ruledicaprio/sjednica-hybrid-solar/README.md

solar-rfp-engine

Solar/hybrid-power engineering toolkit for producing RFP and technical
proposal documents. First active project: Solarna ograda SJEDNICA_BILECA.
See CLAUDE.md for scope, tool/data sources, and workflow.
