ruledicaprio/sjednica-hybrid-solar/rural-star-sjednica/RuralStar_Sjednica_Report.pdf

# Izvještaj o simulaciji RuralStar Sjednica

### Datum generisanja: 24.04.2026 18:20

# 1. Konfiguracija Sistema

Parametar | Vrijednost
Lokacija | 42.94° N, 18.32° E
Nadmorska visina | 1076 m
Ukupno panela | 12 kom (Huawei 540W)
Raspored | 2 nosa■a x 2 reda x 3 kolone
Nagib (Tilt) | 45°
Orijentacija | Jug (180°)
Baterija | 46.08 kWh
Generator | 13.5 kW

# 2. Geometrija Rasporeda

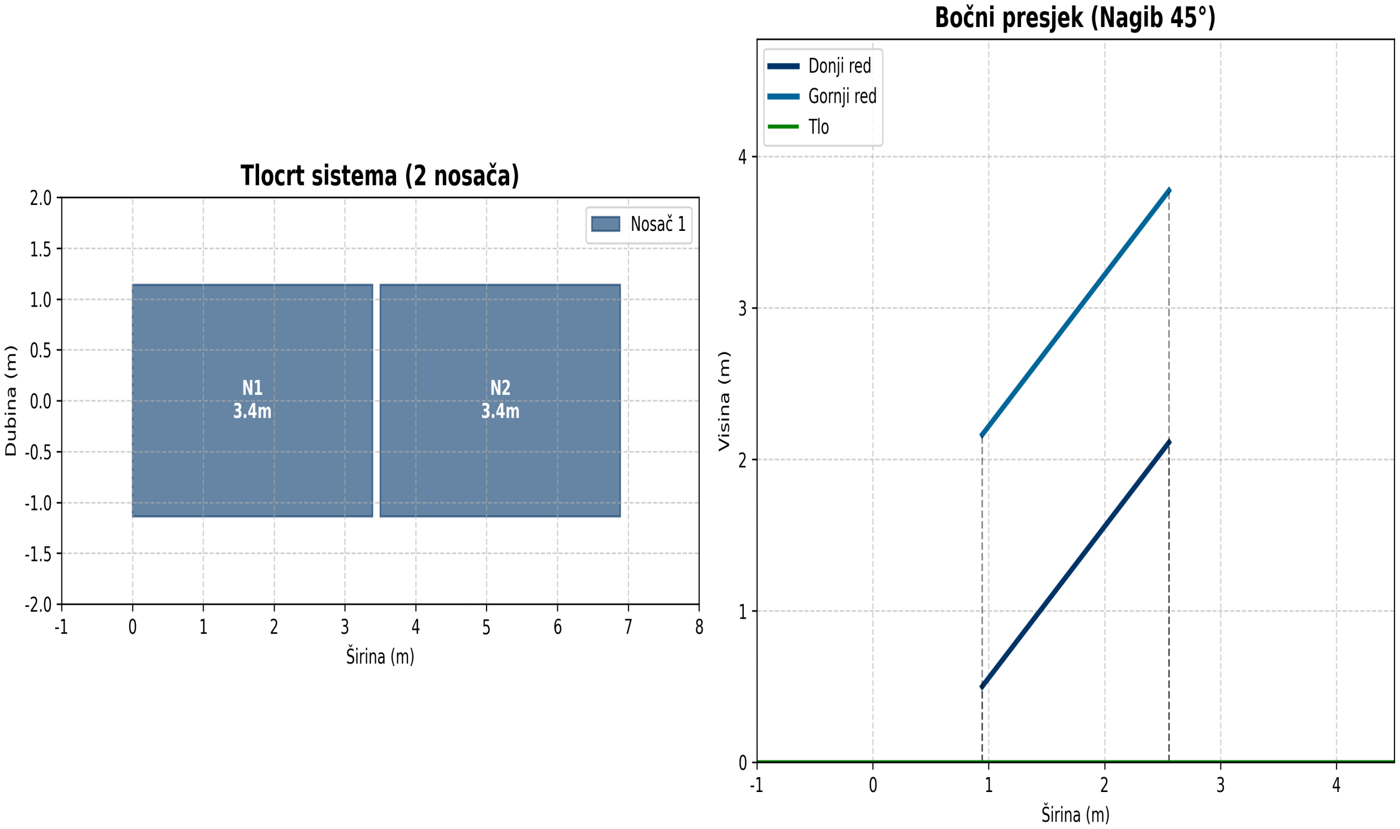
[picture p12: figure]

Slika 1: Tlocrt i bo■ni presjek sistema (2 nosa■a).

# 3. Energetski Bilans

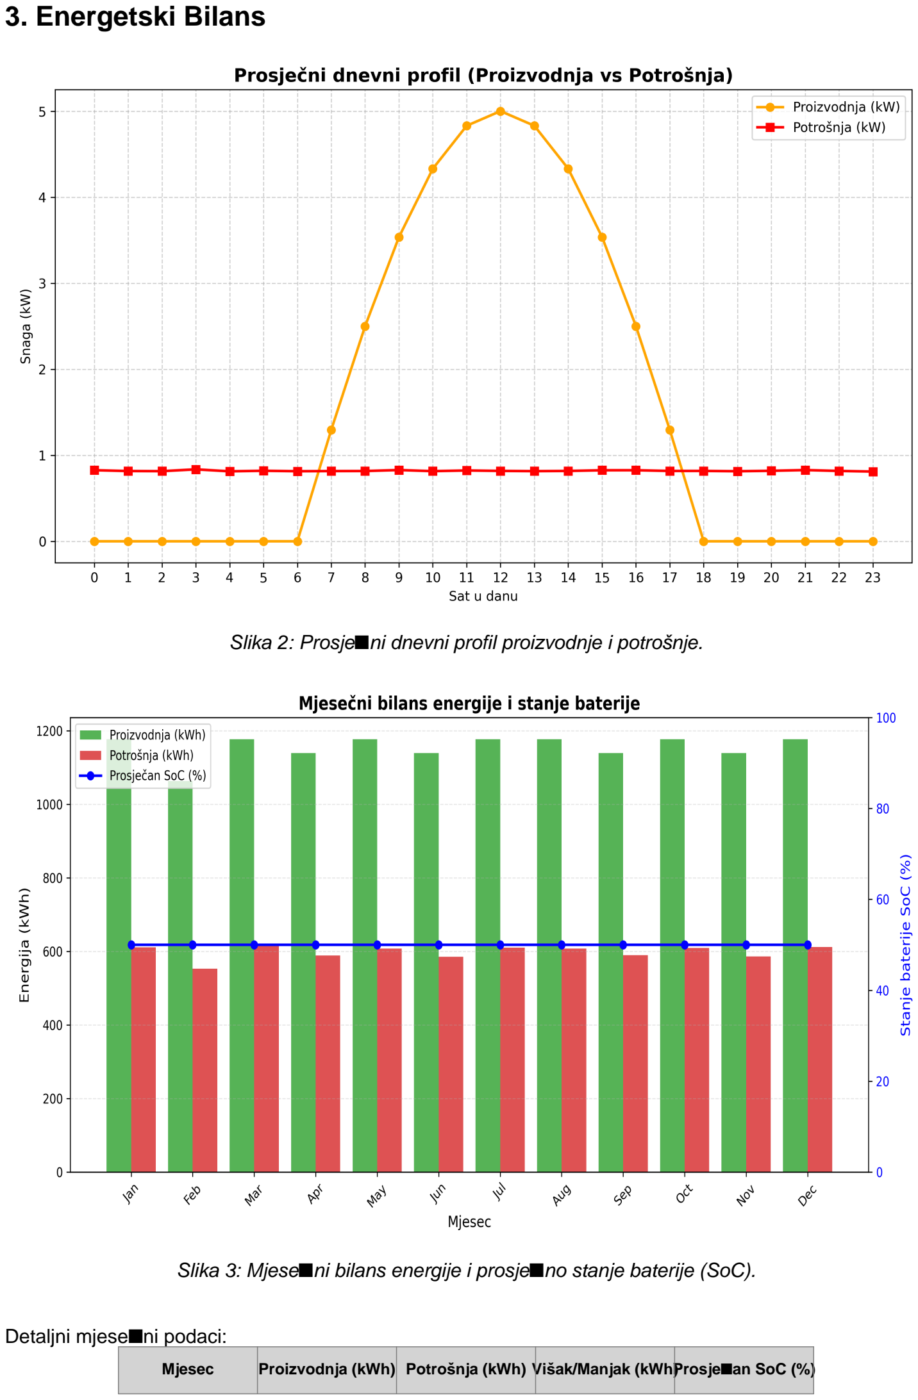
[picture p13: page 2]

Slika 2: Prosje■ni dnevni profil proizvodnje i potrošnje.

Slika 3: Mjese■ni bilans energije i prosje■no stanje baterije (SoC).

### Detaljni mjese■ni podaci:

Mjesec | Proizvodnja (kWh) | Potrošnja (kWh) Višak/Manjak (kWh)Prosje■an SoC (%)

January | 1177.3 | 611.0 | +566.3 | 50.0
February | 1063.4 | 553.0 | +510.4 | 50.0
March | 1177.3 | 615.2 | +562.2 | 50.0
April | 1139.4 | 588.8 | +550.6 | 50.0
May | 1177.3 | 607.8 | +569.5 | 50.0
June | 1139.4 | 585.3 | +554.1 | 50.0
July | 1177.3 | 610.2 | +567.2 | 50.0
August | 1177.3 | 608.1 | +569.2 | 50.0
September | 1139.4 | 589.8 | +549.6 | 50.0
October | 1177.3 | 609.5 | +567.8 | 50.0
November | 1139.4 | 587.0 | +552.4 | 50.0
December | 1177.3 | 612.0 | +565.4 | 50.0

Kraj izvještaja.
