ruledicaprio/sjednica-hybrid-solar/rural-star-sjednica/output/report_results/RuralStar_Sjednica_FINAL_REPORT.pdf

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

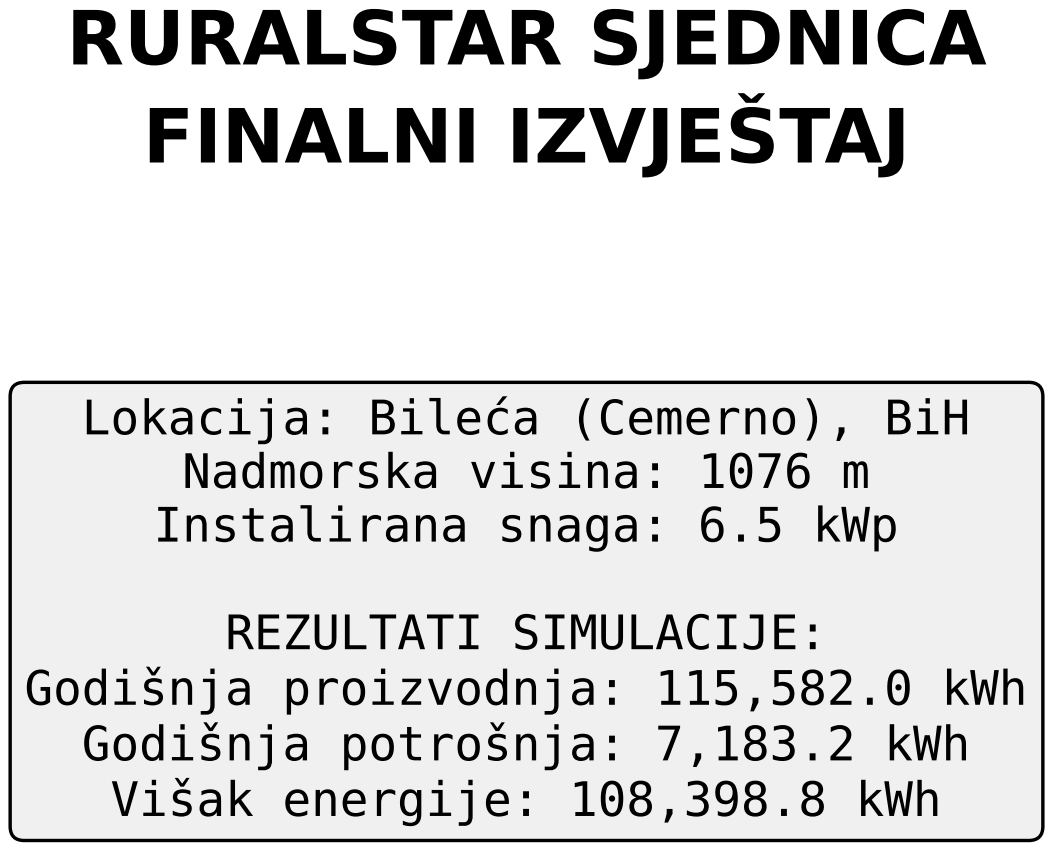
[picture p14: page 1]

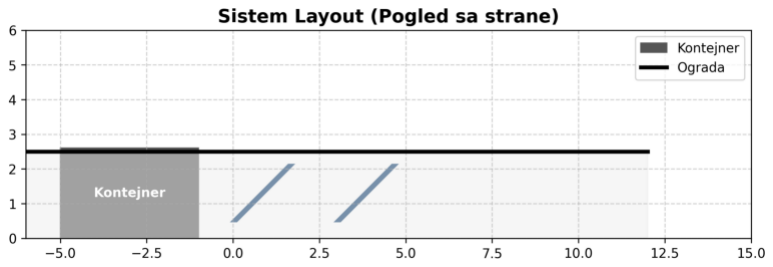
[picture p15: figure]

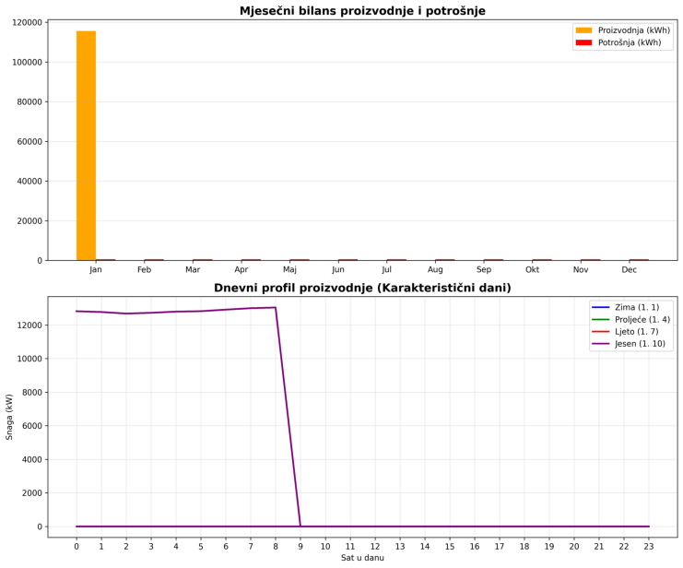
[picture p16: figure]
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
