ruledicaprio/sjednica-hybrid-solar/bht-sjednica-final-review/reference/P_22-6_FG_Wilson_LONG_SIDE_VIEW_compressed.png

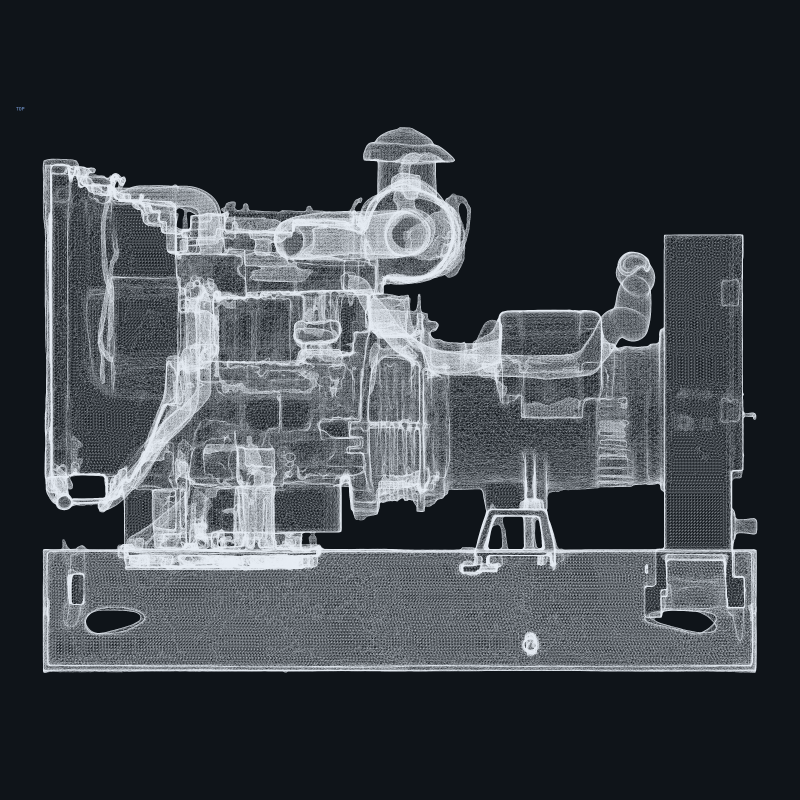
bht-sjednica-final-review/reference/P_22-6_FG_Wilson_LONG_SIDE_VIEW_compressed.png
