ruledicaprio/sjednica-hybrid-solar/bht-sjednica-final-review/reference/P_22-6_FG_Wilson_SIDE_VIEW.png

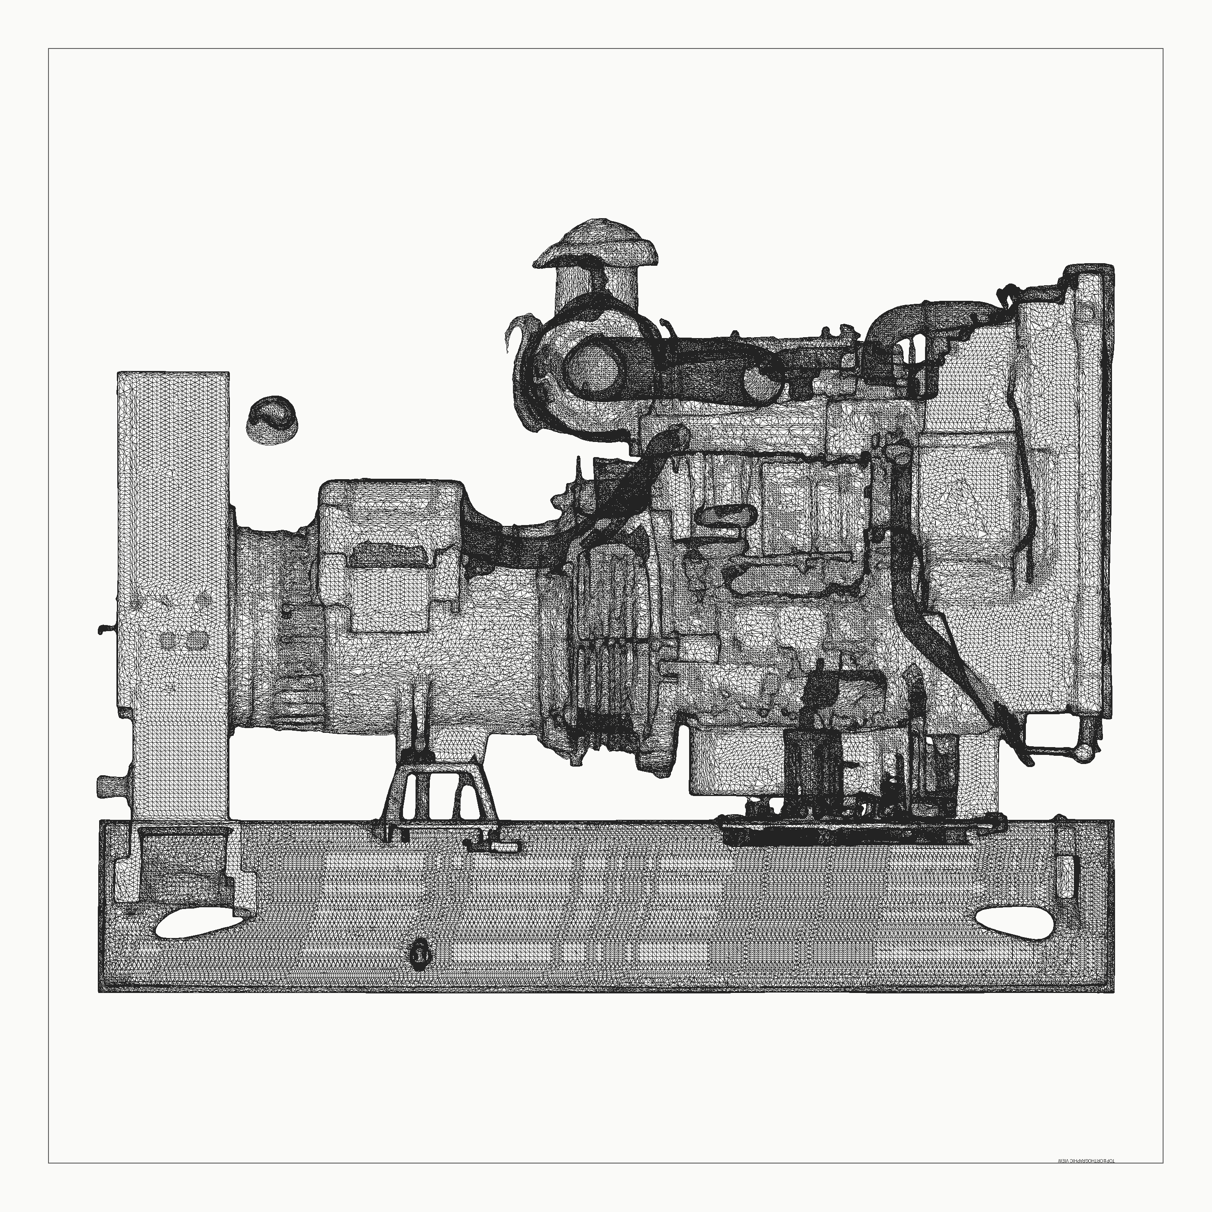
bht-sjednica-final-review/reference/P_22-6_FG_Wilson_SIDE_VIEW.png
