ruledicaprio/sjednica-hybrid-solar/bht-sjednica-final-review/review/pvsim/fig/f1_bilans_t60.png

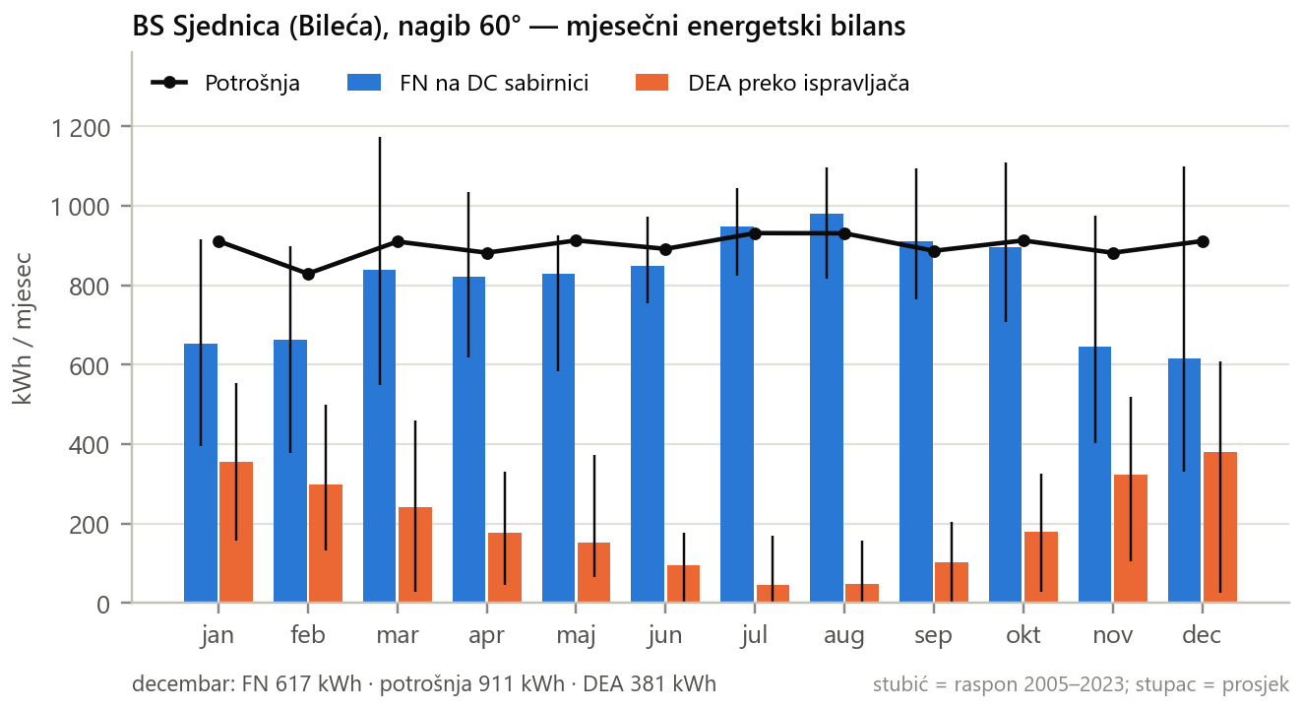
bht-sjednica-final-review/review/pvsim/fig/f1_bilans_t60.png
