ruledicaprio/sjednica-hybrid-solar/bht-sjednica-final-review/review/pvsim/fig/f3_dea_dani_t45.png

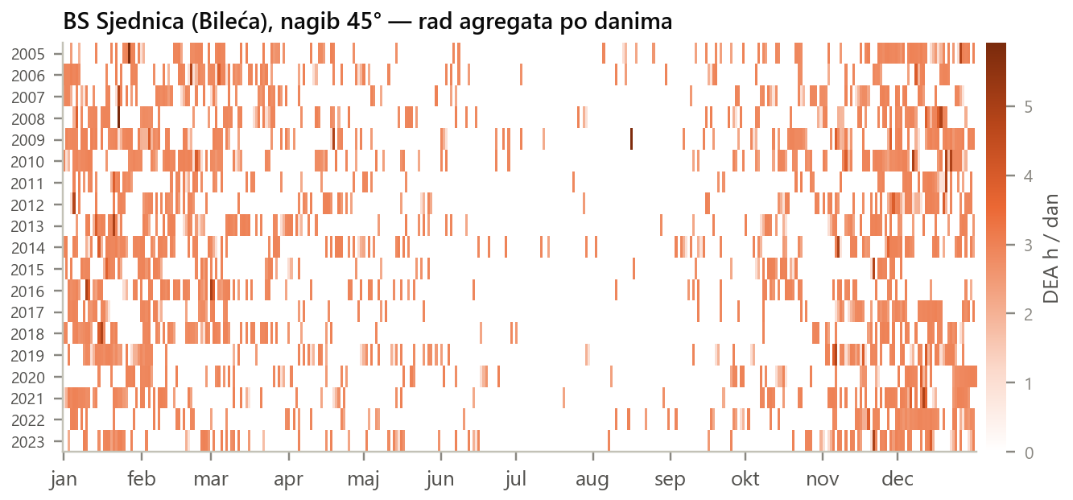
bht-sjednica-final-review/review/pvsim/fig/f3_dea_dani_t45.png
