ruledicaprio/sjednica-hybrid-solar/bht-sjednica-final-review/review/pvsim/fig/f4_dea_godine_t45.png

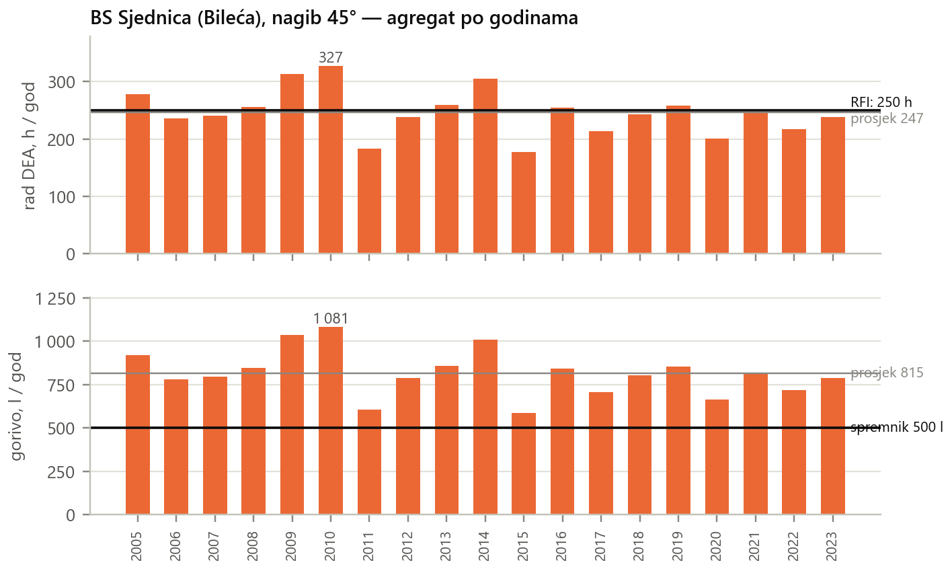
bht-sjednica-final-review/review/pvsim/fig/f4_dea_godine_t45.png
