ruledicaprio/sjednica-hybrid-solar/bht-sjednica-final-review/review/pvsim/fig/f6_nagibi.png

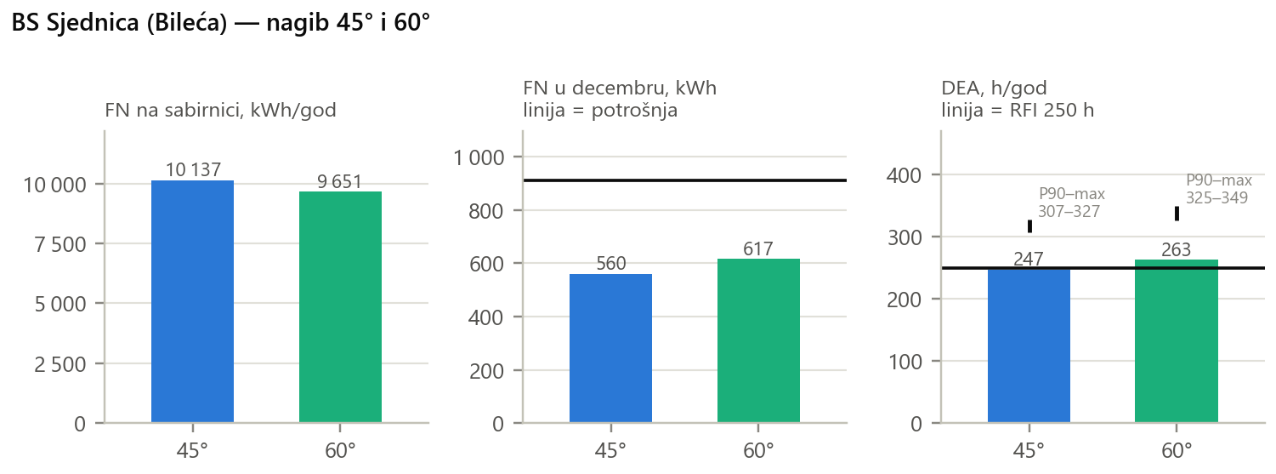
bht-sjednica-final-review/review/pvsim/fig/f6_nagibi.png
