ruledicaprio/sjednica-hybrid-solar/hamzici-hybrid-solar/review/pvsim/photo/20260908_121243_sunce.jpg

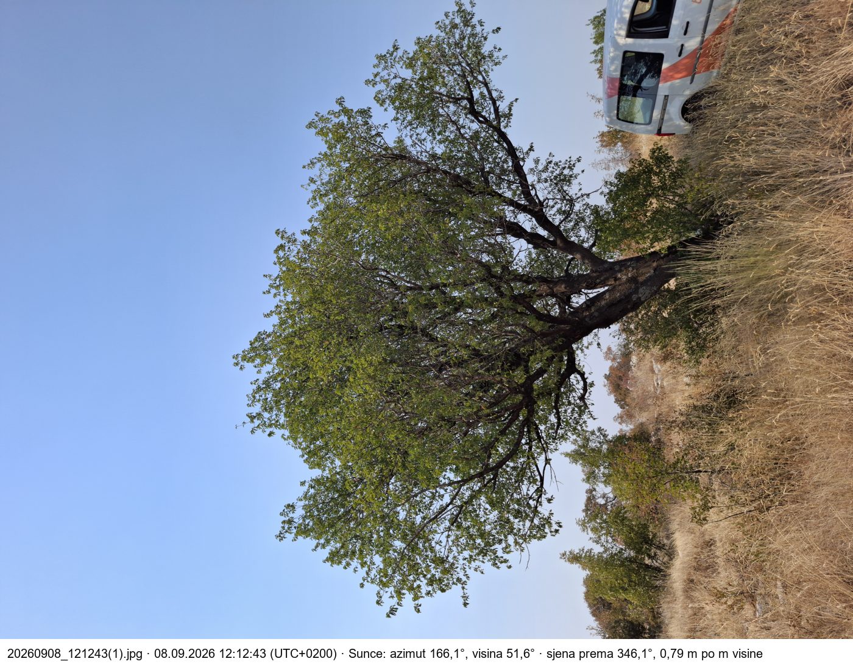
hamzici-hybrid-solar/review/pvsim/photo/20260908_121243_sunce.jpg
