ruledicaprio/sjednica-hybrid-solar/bht-sjednica-final-review/TD-OUTPUT/grafika/S-03.dxf

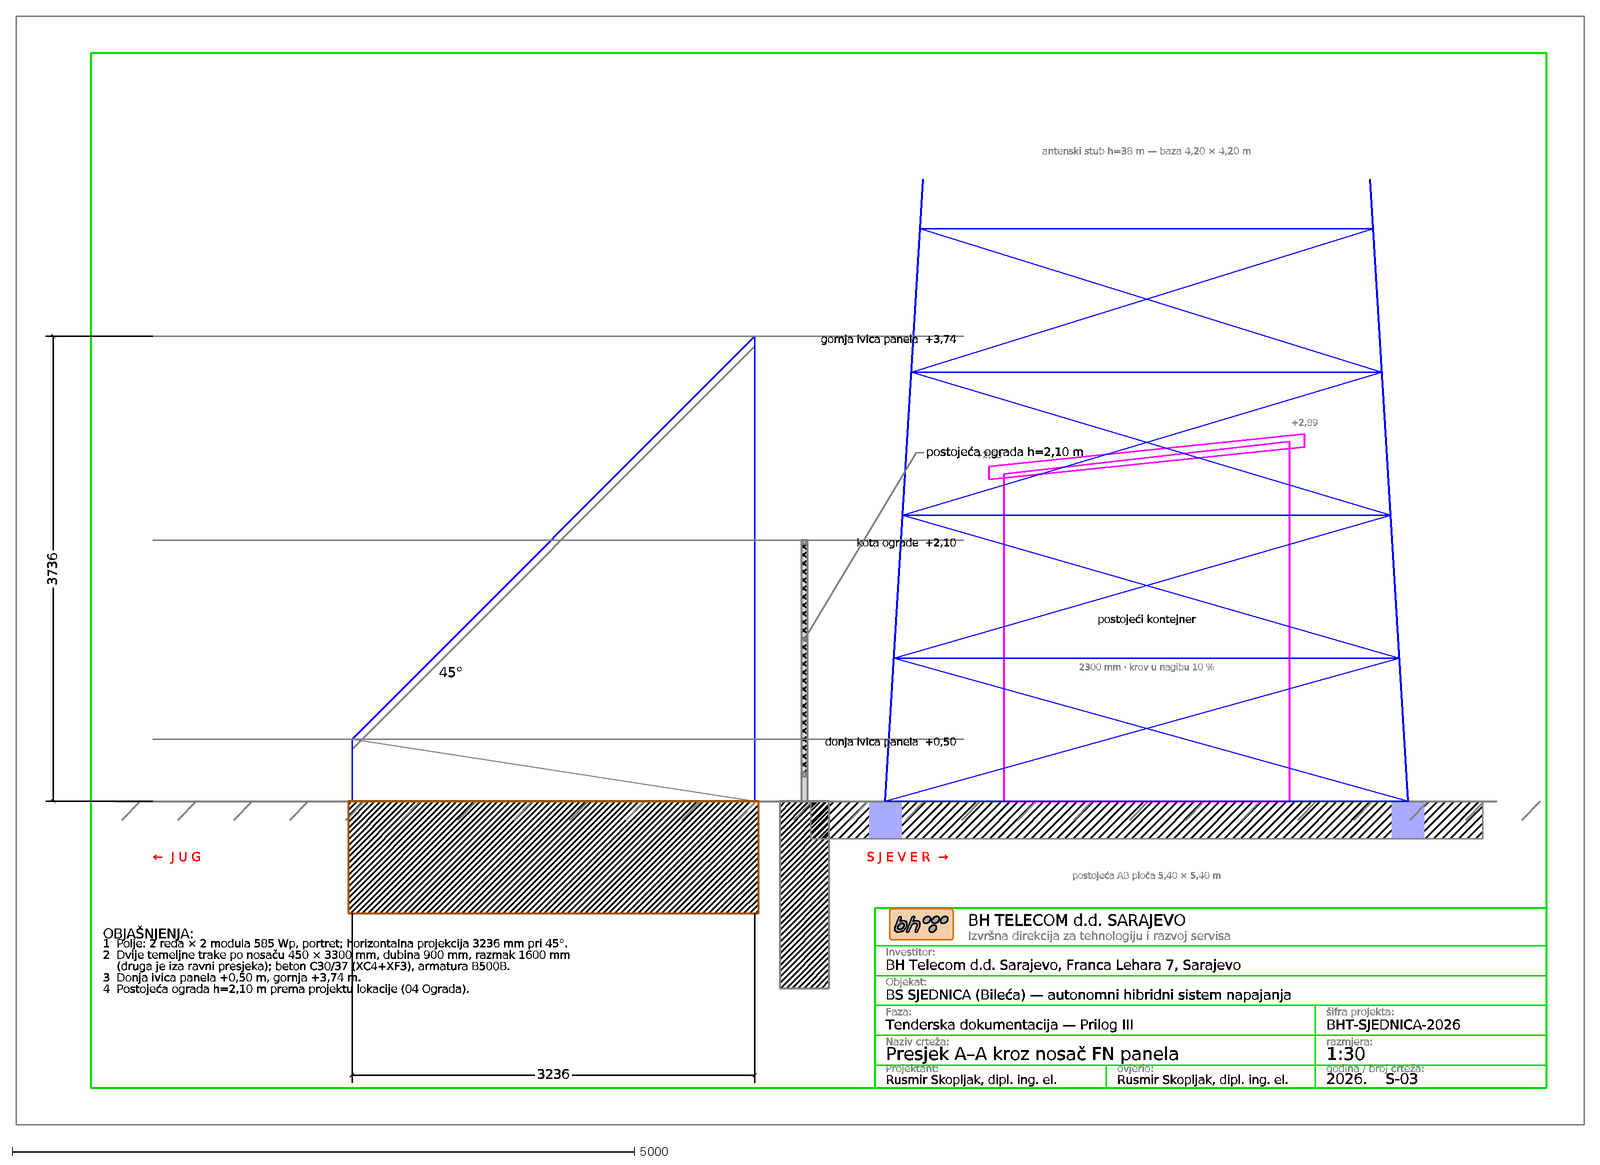
[picture p34: CAD file, 2026-09-11]
bht-sjednica-final-review/TD-OUTPUT/grafika/S-03.dxf
BH TELECOM d.d. SARAJEVO
Izvršna direkcija za tehnologiju i razvoj servisa
Investitor:
BH Telecom d.d. Sarajevo, Franca Lehara 7, Sarajevo
Objekat:
BS SJEDNICA (Bileća) — autonomni hibridni sistem napajanja
Faza:
Tenderska dokumentacija — Prilog III
šifra projekta:
BHT-SJEDNICA-2026
Naziv crteža:
Presjek A–A kroz nosač FN panela
razmjera:
1:30
Projektant:
Rusmir Skopljak, dipl. ing. el.
ovjerio:
godina / broj crteža:
2026. S-03
postojeći kontejner
2300 mm · krov u nagibu 10 %
+2,63
+2,89
postojeća AB ploča 5,40 × 5,40 m
antenski stub h=38 m — baza 4,20 × 4,20 m
donja ivica panela +0,50
kota ograde +2,10
gornja ivica panela +3,74
3236
3736
45°
S J E V E R →
← J U G
postojeća ograda h=2,10 m
OBJAŠNJENJA:
1 Polje: 2 reda × 2 modula 585 Wp, portret; horizontalna projekcija 3236 mm pri 45°.
2 Dvije temeljne trake po nosaču 450 × 3300 mm, dubina 900 mm, razmak 1600 mm
(druga je iza ravni presjeka); beton C30/37 (XC4+XF3), armatura B500B.
3 Donja ivica panela +0,50 m, gornja +3,74 m.
4 Postojeća ograda h=2,10 m prema projektu lokacije (04 Ograda).
