ruledicaprio/sjednica-hybrid-solar/hamzici-hybrid-solar/TD-OUTPUT/grafika/H-03.dxf

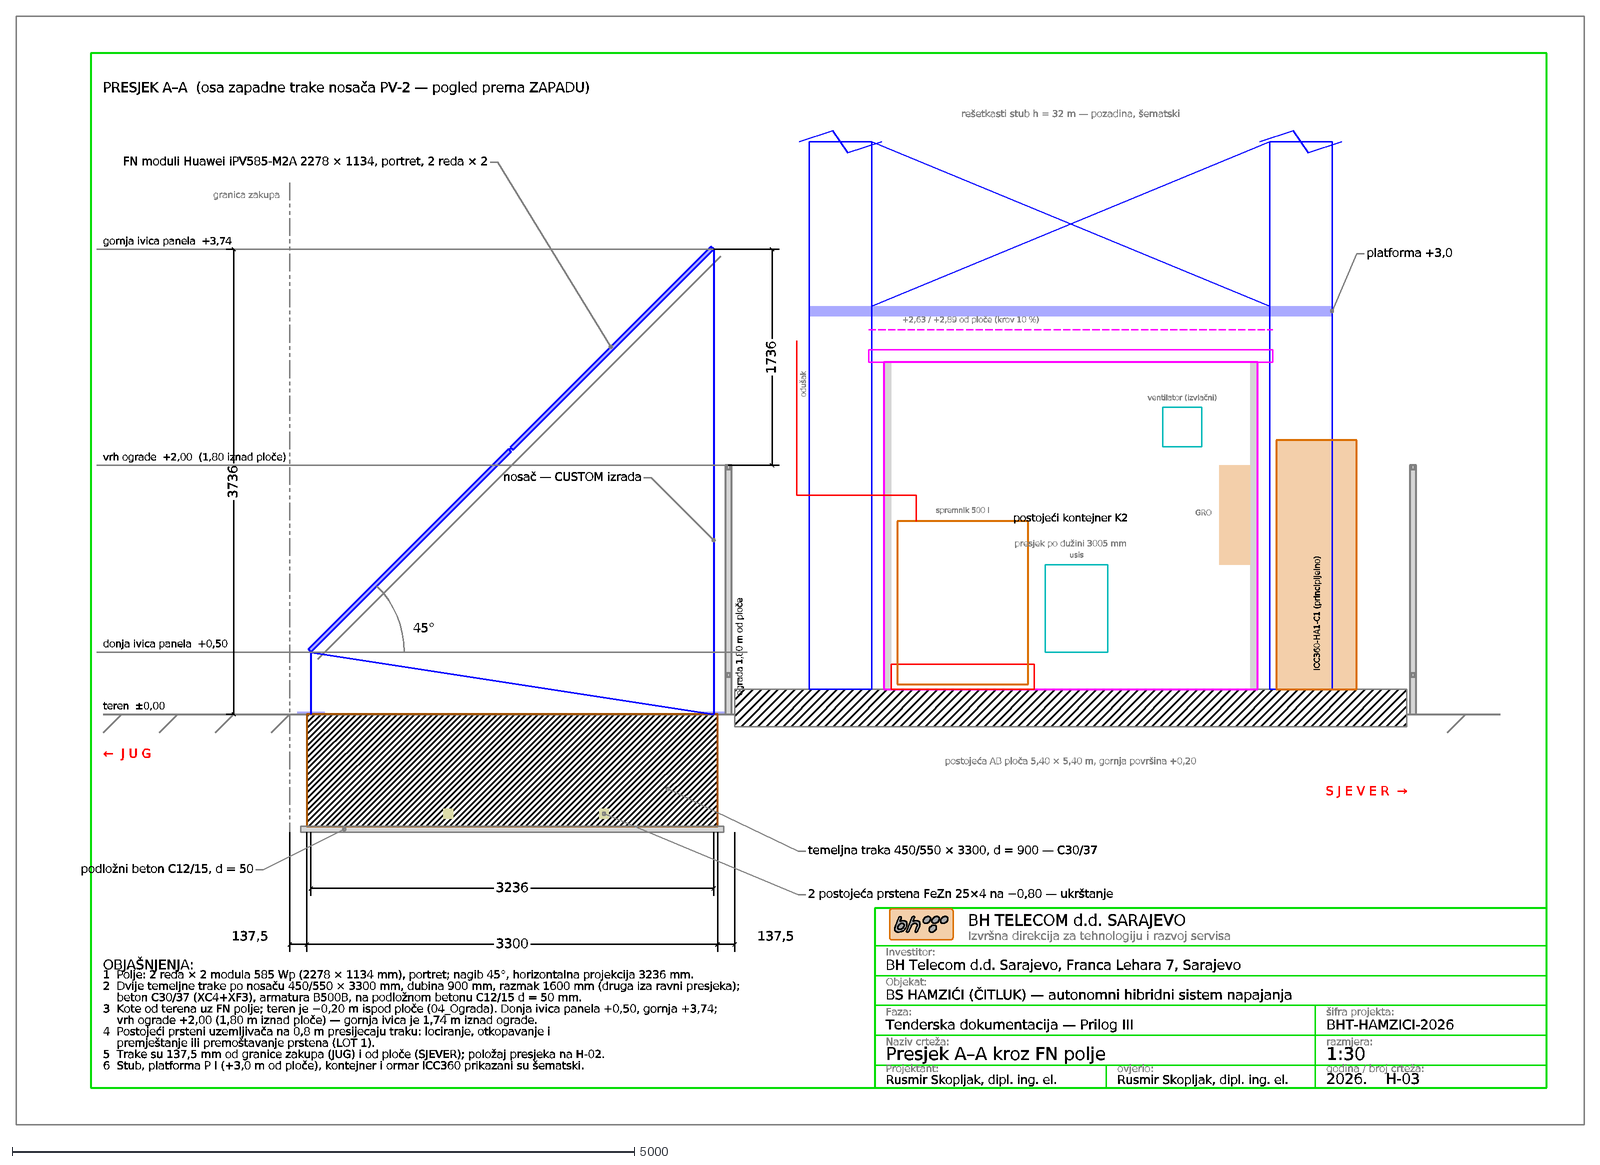
[picture p35: CAD file, 2026-09-11]
hamzici-hybrid-solar/TD-OUTPUT/grafika/H-03.dxf
BH TELECOM d.d. SARAJEVO
Izvršna direkcija za tehnologiju i razvoj servisa
Investitor:
BH Telecom d.d. Sarajevo, Franca Lehara 7, Sarajevo
Objekat:
BS HAMZIĆI (ČITLUK) — autonomni hibridni sistem napajanja
Faza:
Tenderska dokumentacija — Prilog III
šifra projekta:
BHT-HAMZICI-2026
Naziv crteža:
Presjek A–A kroz FN polje
razmjera:
1:30
Projektant:
Rusmir Skopljak, dipl. ing. el.
ovjerio:
godina / broj crteža:
2026. H-03
granica zakupa
45°
ograda 1,80 m od ploče
postojeća AB ploča 5,40 × 5,40 m, gornja površina +0,20
rešetkasti stub h = 32 m — pozadina, šematski
platforma +3,0
+2,63 / +2,89 od ploče (krov 10 %)
usis
ventilator (izvlačni)
GRO
spremnik 500 l
odušak
ICC360-HA1-C1 (principijelno)
postojeći kontejner K2
presjek po dužini 3005 mm
donja ivica panela +0,50
vrh ograde +2,00 (1,80 iznad ploče)
gornja ivica panela +3,74
teren ±0,00
3736
1736
3236
137,5
3300
FN moduli Huawei iPV585-M2A 2278 × 1134, portret, 2 reda × 2
nosač — CUSTOM izrada
temeljna traka 450/550 × 3300, d = 900 — C30/37
2 postojeća prstena FeZn 25×4 na −0,80 — ukrštanje
podložni beton C12/15, d = 50
PRESJEK A–A (osa zapadne trake nosača PV-2 — pogled prema ZAPADU)
← J U G
S J E V E R →
OBJAŠNJENJA:
1 Polje: 2 reda × 2 modula 585 Wp (2278 × 1134 mm), portret; nagib 45°, horizontalna projekcija 3236 mm.
2 Dvije temeljne trake po nosaču 450/550 × 3300 mm, dubina 900 mm, razmak 1600 mm (druga iza ravni presjeka);
beton C30/37 (XC4+XF3), armatura B500B, na podložnom betonu C12/15 d = 50 mm.
3 Kote od terena uz FN polje; teren je −0,20 m ispod ploče (04_Ograda). Donja ivica panela +0,50, gornja +3,74;
vrh ograde +2,00 (1,80 m iznad ploče) — gornja ivica je 1,74 m iznad ograde.
4 Postojeći prsteni uzemljivača na 0,8 m presijecaju traku: lociranje, otkopavanje i
premještanje ili premoštavanje prstena (LOT 1).
5 Trake su 137,5 mm od granice zakupa (JUG) i od ploče (SJEVER); položaj presjeka na H-02.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
