ruledicaprio/sjednica-hybrid-solar/rfp-hybrid-solar-td/TD-OUTPUT/grafika/hamzici/H-02.dxf

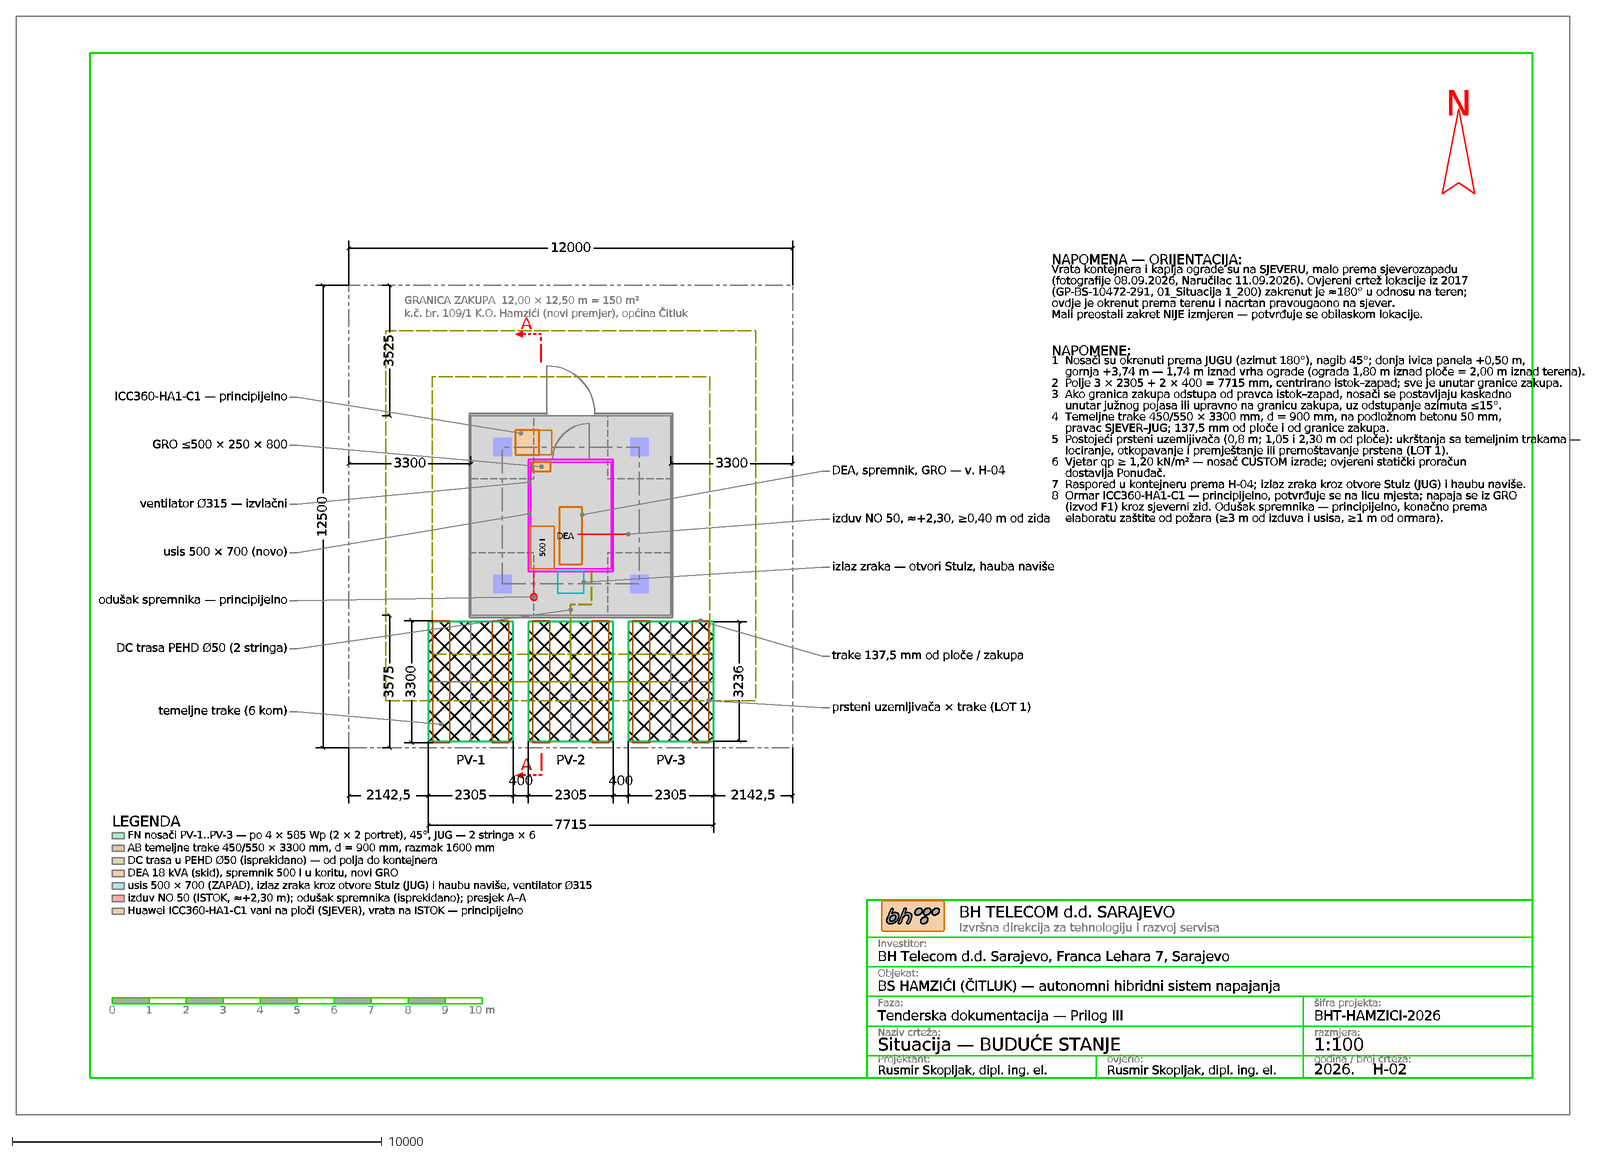
[picture p36: CAD file, 2026-09-11]
rfp-hybrid-solar-td/TD-OUTPUT/grafika/hamzici/H-02.dxf
BH TELECOM d.d. SARAJEVO
Izvršna direkcija za tehnologiju i razvoj servisa
Investitor:
BH Telecom d.d. Sarajevo, Franca Lehara 7, Sarajevo
Objekat:
BS HAMZIĆI (ČITLUK) — autonomni hibridni sistem napajanja
Faza:
Tenderska dokumentacija — Prilog III
šifra projekta:
BHT-HAMZICI-2026
Naziv crteža:
Situacija — BUDUĆE STANJE
razmjera:
1:100
Projektant:
Rusmir Skopljak, dipl. ing. el.
ovjerio:
godina / broj crteža:
2026. H-02
GRANICA ZAKUPA 12,00 × 12,50 m = 150 m²
k.č. br. 109/1 K.O. Hamzići (novi premjer), općina Čitluk
DEA
500 l
12000
12500
3525
3575
3300
PV-1
PV-2
PV-3
A
2142,5
2305
400
7715
3236
temeljne trake (6 kom)
DC trasa PEHD Ø50 (2 stringa)
usis 500 × 700 (novo)
ventilator Ø315 — izvlačni
GRO ≤500 × 250 × 800
izlaz zraka — otvori Stulz, hauba naviše
izduv NO 50, ≈+2,30, ≥0,40 m od zida
DEA, spremnik, GRO — v. H-04
trake 137,5 mm od ploče / zakupa
prsteni uzemljivača × trake (LOT 1)
ICC360-HA1-C1 — principijelno
odušak spremnika — principijelno
N
0
1
2
3
4
5
6
7
8
9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
