ruledicaprio/sjednica-hybrid-solar/bht-sjednica-final-review/TD-OUTPUT/grafika/M-01.dxf

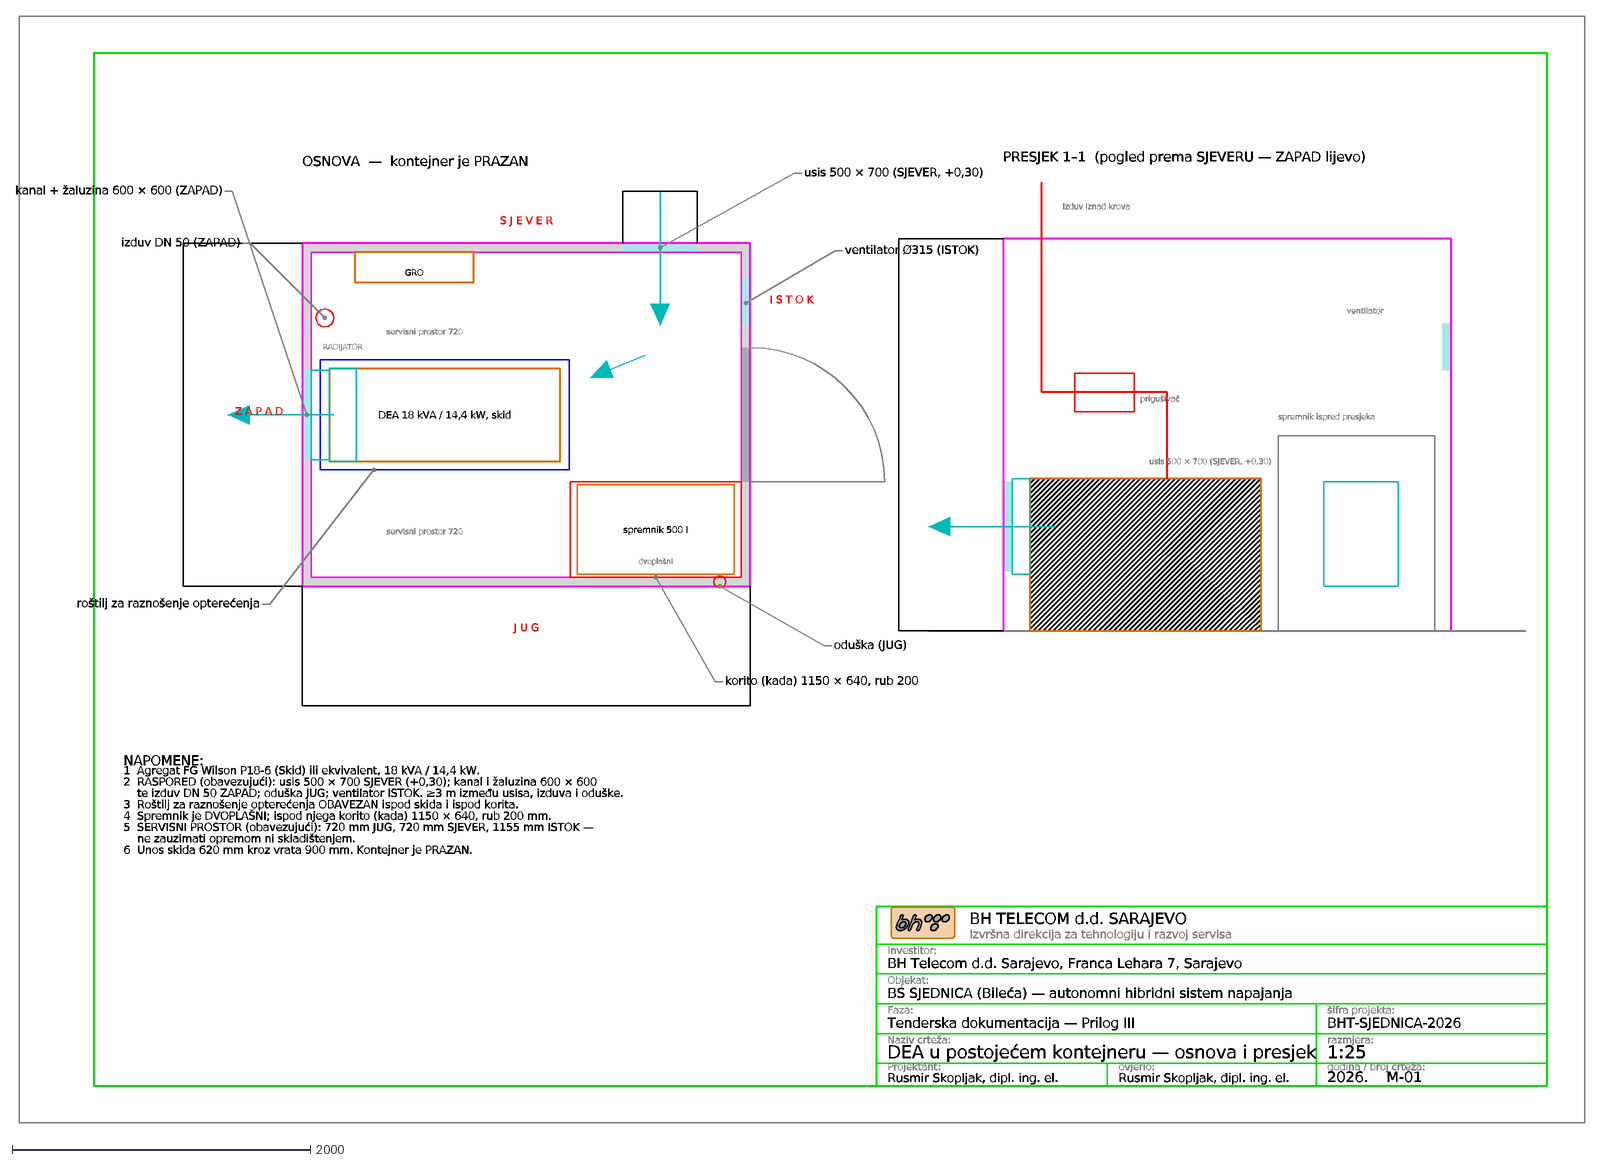
[picture p37: CAD file, 2026-09-11]
bht-sjednica-final-review/TD-OUTPUT/grafika/M-01.dxf
BH TELECOM d.d. SARAJEVO
Izvršna direkcija za tehnologiju i razvoj servisa
Investitor:
BH Telecom d.d. Sarajevo, Franca Lehara 7, Sarajevo
Objekat:
BS SJEDNICA (Bileća) — autonomni hibridni sistem napajanja
Faza:
Tenderska dokumentacija — Prilog III
šifra projekta:
BHT-SJEDNICA-2026
Naziv crteža:
DEA u postojećem kontejneru — osnova i presjek
razmjera:
1:25
Projektant:
Rusmir Skopljak, dipl. ing. el.
ovjerio:
godina / broj crteža:
2026. M-01
OSNOVA — kontejner je PRAZAN
DEA 18 kVA / 14,4 kW, skid
RADIJATOR
GRO
spremnik 500 l
dvoplašni
servisni prostor 720
3005
2300
500
usis 500 × 700 (SJEVER, +0,30)
kanal + žaluzina 600 × 600 (ZAPAD)
izduv DN 50 (ZAPAD)
korito (kada) 1150 × 640, rub 200
oduška (JUG)
ventilator Ø315 (ISTOK)
roštilj za raznošenje opterećenja
S J E V E R
J U G
Z A P A D
I S T O K
PRESJEK 1–1 (pogled prema SJEVERU — ZAPAD lijevo)
prigušivač
izduv iznad krova
spremnik ispred presjeka
ventilator
2630
NAPOMENE:
1 Agregat FG Wilson P18-6 (Skid) ili ekvivalent, 18 kVA / 14,4 kW.
2 RASPORED (obavezujući): usis 500 × 700 SJEVER (+0,30); kanal i žaluzina 600 × 600
te izduv DN 50 ZAPAD; oduška JUG; ventilator ISTOK. ≥3 m između usisa, izduva i oduške.
3 Roštilj za raznošenje opterećenja OBAVEZAN ispod skida i ispod korita.
4 Spremnik je DVOPLAŠNI; ispod njega korito (kada) 1150 × 640, rub 200 mm.
5 SERVISNI PROSTOR (obavezujući): 720 mm JUG, 720 mm SJEVER, 1155 mm ISTOK —
ne zauzimati opremom ni skladištenjem.
6 Unos skida 620 mm kroz vrata 900 mm. Kontejner je PRAZAN.
