ruledicaprio/sjednica-hybrid-solar/bht-sjednica-final-review/TD-OUTPUT/grafika/S-01.dxf

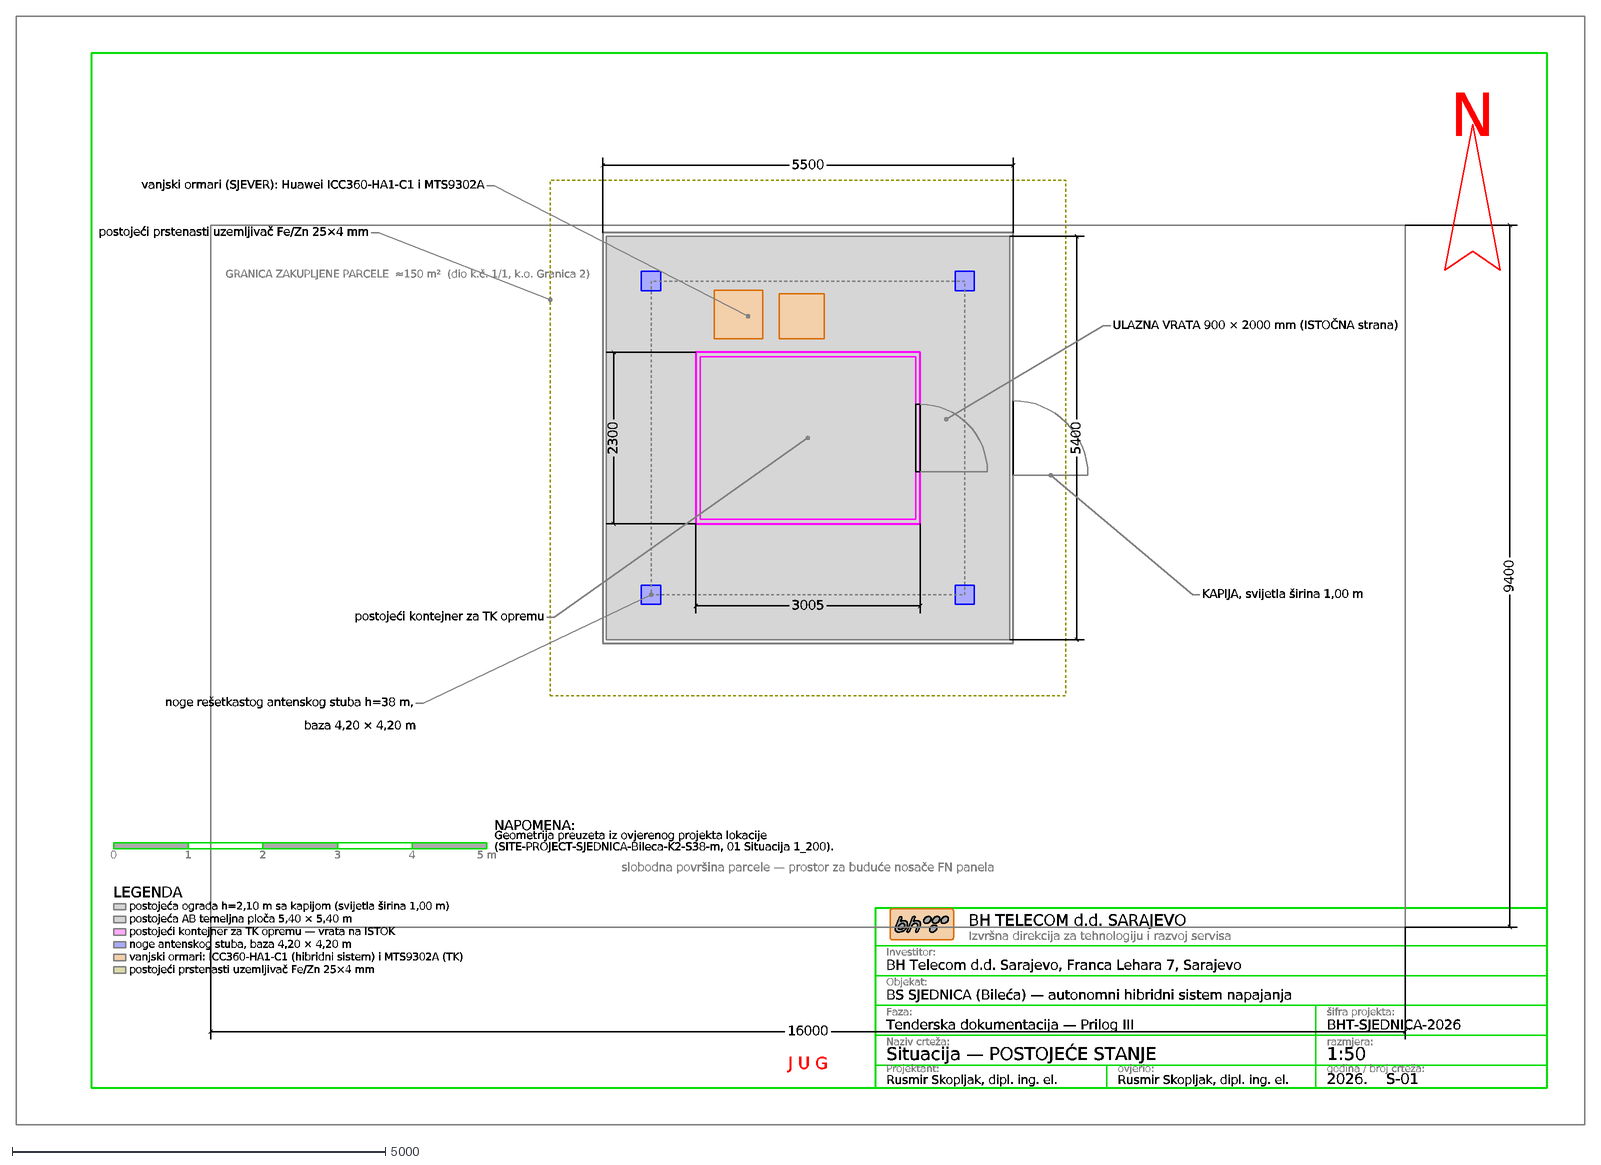
[picture p38: CAD file, 2026-09-11]
bht-sjednica-final-review/TD-OUTPUT/grafika/S-01.dxf
BH TELECOM d.d. SARAJEVO
Izvršna direkcija za tehnologiju i razvoj servisa
Investitor:
BH Telecom d.d. Sarajevo, Franca Lehara 7, Sarajevo
Objekat:
BS SJEDNICA (Bileća) — autonomni hibridni sistem napajanja
Faza:
Tenderska dokumentacija — Prilog III
šifra projekta:
BHT-SJEDNICA-2026
Naziv crteža:
Situacija — POSTOJEĆE STANJE
razmjera:
1:50
Projektant:
Rusmir Skopljak, dipl. ing. el.
ovjerio:
godina / broj crteža:
2026. S-01
GRANICA ZAKUPLJENE PARCELE ≈150 m² (dio k.č. 1/1, k.o. Granica 2)
5500
5400
3005
2300
16000
9400
postojeći kontejner za TK opremu
ULAZNA VRATA 900 × 2000 mm (ISTOČNA strana)
vanjski ormari (SJEVER): Huawei ICC360-HA1-C1 i MTS9302A
noge rešetkastog antenskog stuba h=38 m,
baza 4,20 × 4,20 m
KAPIJA, svijetla širina 1,00 m
postojeći prstenasti uzemljivač Fe/Zn 25×4 mm
slobodna površina parcele — prostor za buduće nosače FN panela
J U G
N
0
1
2
3
4
5 m
LEGENDA
postojeća ograda h=2,10 m sa kapijom (svijetla širina 1,00 m)
postojeća AB temeljna ploča 5,40 × 5,40 m
postojeći kontejner za TK opremu — vrata na ISTOK
noge antenskog stuba, baza 4,20 × 4,20 m
vanjski ormari: ICC360-HA1-C1 (hibridni sistem) i MTS9302A (TK)
NAPOMENA:
Geometrija preuzeta iz ovjerenog projekta lokacije
(SITE-PROJECT-SJEDNICA-Bileca-K2-S38-m, 01 Situacija 1_200).
