ruledicaprio/sjednica-hybrid-solar/rfp-hybrid-solar-td/TD-OUTPUT/grafika/hamzici/H-01.dxf

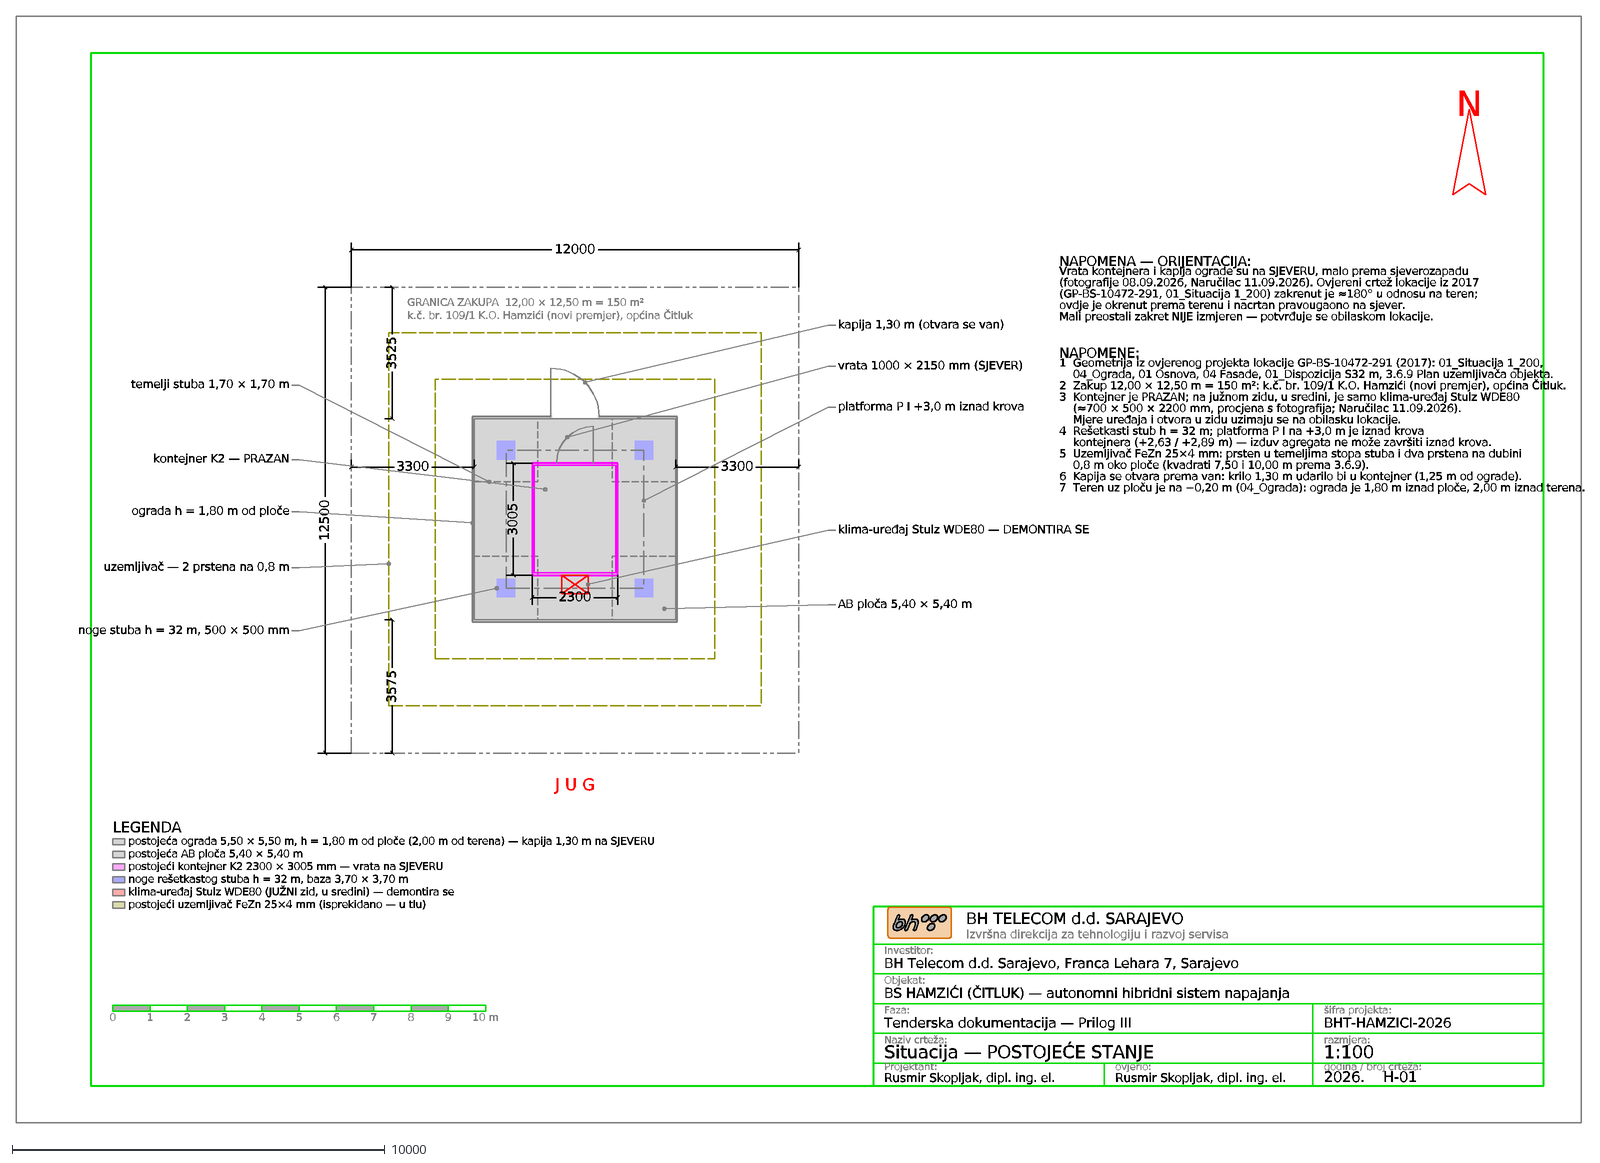
[picture p39: CAD file, 2026-09-11]
rfp-hybrid-solar-td/TD-OUTPUT/grafika/hamzici/H-01.dxf
BH TELECOM d.d. SARAJEVO
Izvršna direkcija za tehnologiju i razvoj servisa
Investitor:
BH Telecom d.d. Sarajevo, Franca Lehara 7, Sarajevo
Objekat:
BS HAMZIĆI (ČITLUK) — autonomni hibridni sistem napajanja
Faza:
Tenderska dokumentacija — Prilog III
šifra projekta:
BHT-HAMZICI-2026
Naziv crteža:
Situacija — POSTOJEĆE STANJE
razmjera:
1:100
Projektant:
Rusmir Skopljak, dipl. ing. el.
ovjerio:
godina / broj crteža:
2026. H-01
GRANICA ZAKUPA 12,00 × 12,50 m = 150 m²
k.č. br. 109/1 K.O. Hamzići (novi premjer), općina Čitluk
12000
12500
3525
3575
3300
2300
3005
temelji stuba 1,70 × 1,70 m
kontejner K2 — PRAZAN
ograda h = 1,80 m od ploče
uzemljivač — 2 prstena na 0,8 m
noge stuba h = 32 m, 500 × 500 mm
kapija 1,30 m (otvara se van)
vrata 1000 × 2150 mm (SJEVER)
platforma P I +3,0 m iznad krova
klima-uređaj Stulz WDE80 — DEMONTIRA SE
AB ploča 5,40 × 5,40 m
J U G
N
0
1
2
3
4
5
6
7
8
9
10 m
LEGENDA
postojeća ograda 5,50 × 5,50 m, h = 1,80 m od ploče (2,00 m od terena) — kapija 1,30 m na SJEVERU
postojeća AB ploča 5,40 × 5,40 m
postojeći kontejner K2 2300 × 3005 mm — vrata na SJEVERU
noge rešetkastog stuba h = 32 m, baza 3,70 × 3,70 m
klima-uređaj Stulz WDE80 (JUŽNI zid, u sredini) — demontira se
postojeći uzemljivač FeZn 25×4 mm (isprekidano — u tlu)
NAPOMENA — ORIJENTACIJA:
Vrata kontejnera i kapija ograde su na SJEVERU, malo prema sjeverozapadu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
