ruledicaprio/sjednica-hybrid-solar/bht-sjednica-final-review/TD-OUTPUT/grafika/S-02.dxf

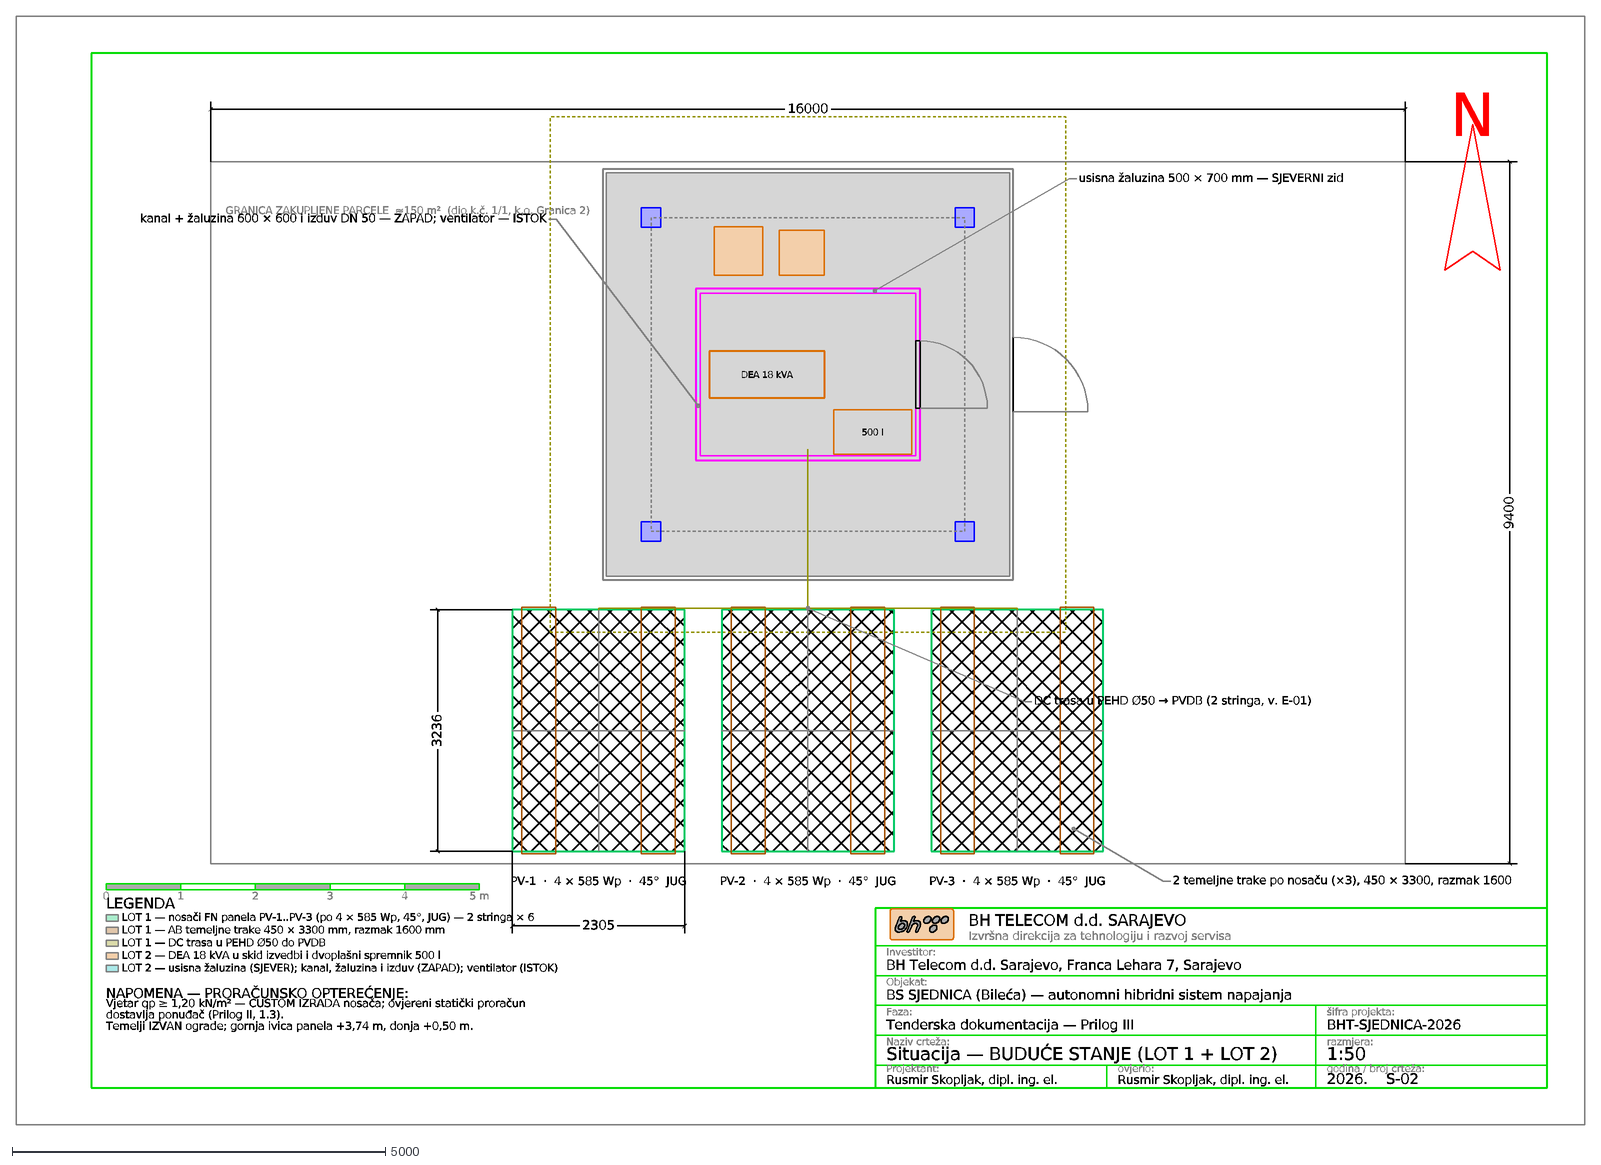
[picture p40: CAD file, 2026-09-11]
bht-sjednica-final-review/TD-OUTPUT/grafika/S-02.dxf
BH TELECOM d.d. SARAJEVO
Izvršna direkcija za tehnologiju i razvoj servisa
Investitor:
BH Telecom d.d. Sarajevo, Franca Lehara 7, Sarajevo
Objekat:
BS SJEDNICA (Bileća) — autonomni hibridni sistem napajanja
Faza:
Tenderska dokumentacija — Prilog III
šifra projekta:
BHT-SJEDNICA-2026
Naziv crteža:
Situacija — BUDUĆE STANJE (LOT 1 + LOT 2)
razmjera:
1:50
Projektant:
Rusmir Skopljak, dipl. ing. el.
ovjerio:
godina / broj crteža:
2026. S-02
GRANICA ZAKUPLJENE PARCELE ≈150 m² (dio k.č. 1/1, k.o. Granica 2)
PV-1 · 4 × 585 Wp · 45° JUG
PV-2 · 4 × 585 Wp · 45° JUG
PV-3 · 4 × 585 Wp · 45° JUG
DEA 18 kVA
500 l
2305
3236
16000
9400
usisna žaluzina 500 × 700 mm — SJEVERNI zid
kanal + žaluzina 600 × 600 i izduv DN 50 — ZAPAD; ventilator — ISTOK
DC trasa u PEHD Ø50 → PVDB (2 stringa, v. E-01)
2 temeljne trake po nosaču (×3), 450 × 3300, razmak 1600
N
0
1
2
3
4
5 m
LEGENDA
LOT 1 — nosači FN panela PV-1..PV-3 (po 4 × 585 Wp, 45°, JUG) — 2 stringa × 6
LOT 1 — AB temeljne trake 450 × 3300 mm, razmak 1600 mm
LOT 1 — DC trasa u PEHD Ø50 do PVDB
LOT 2 — DEA 18 kVA u skid izvedbi i dvoplašni spremnik 500 l
LOT 2 — usisna žaluzina (SJEVER); kanal, žaluzina i izduv (ZAPAD); ventilator (ISTOK)
NAPOMENA — PRORAČUNSKO OPTEREĆENJE:
Vjetar qp ≥ 1,20 kN/m² — CUSTOM IZRADA nosača; ovjereni statički proračun
dostavlja ponuđač (Prilog II, 1.3).
Temelji IZVAN ograde; gornja ivica panela +3,74 m, donja +0,50 m.
