ruledicaprio/sjednica-hybrid-solar/rfp-hybrid-solar-td/TD-OUTPUT/grafika/hamzici/H-04.dxf

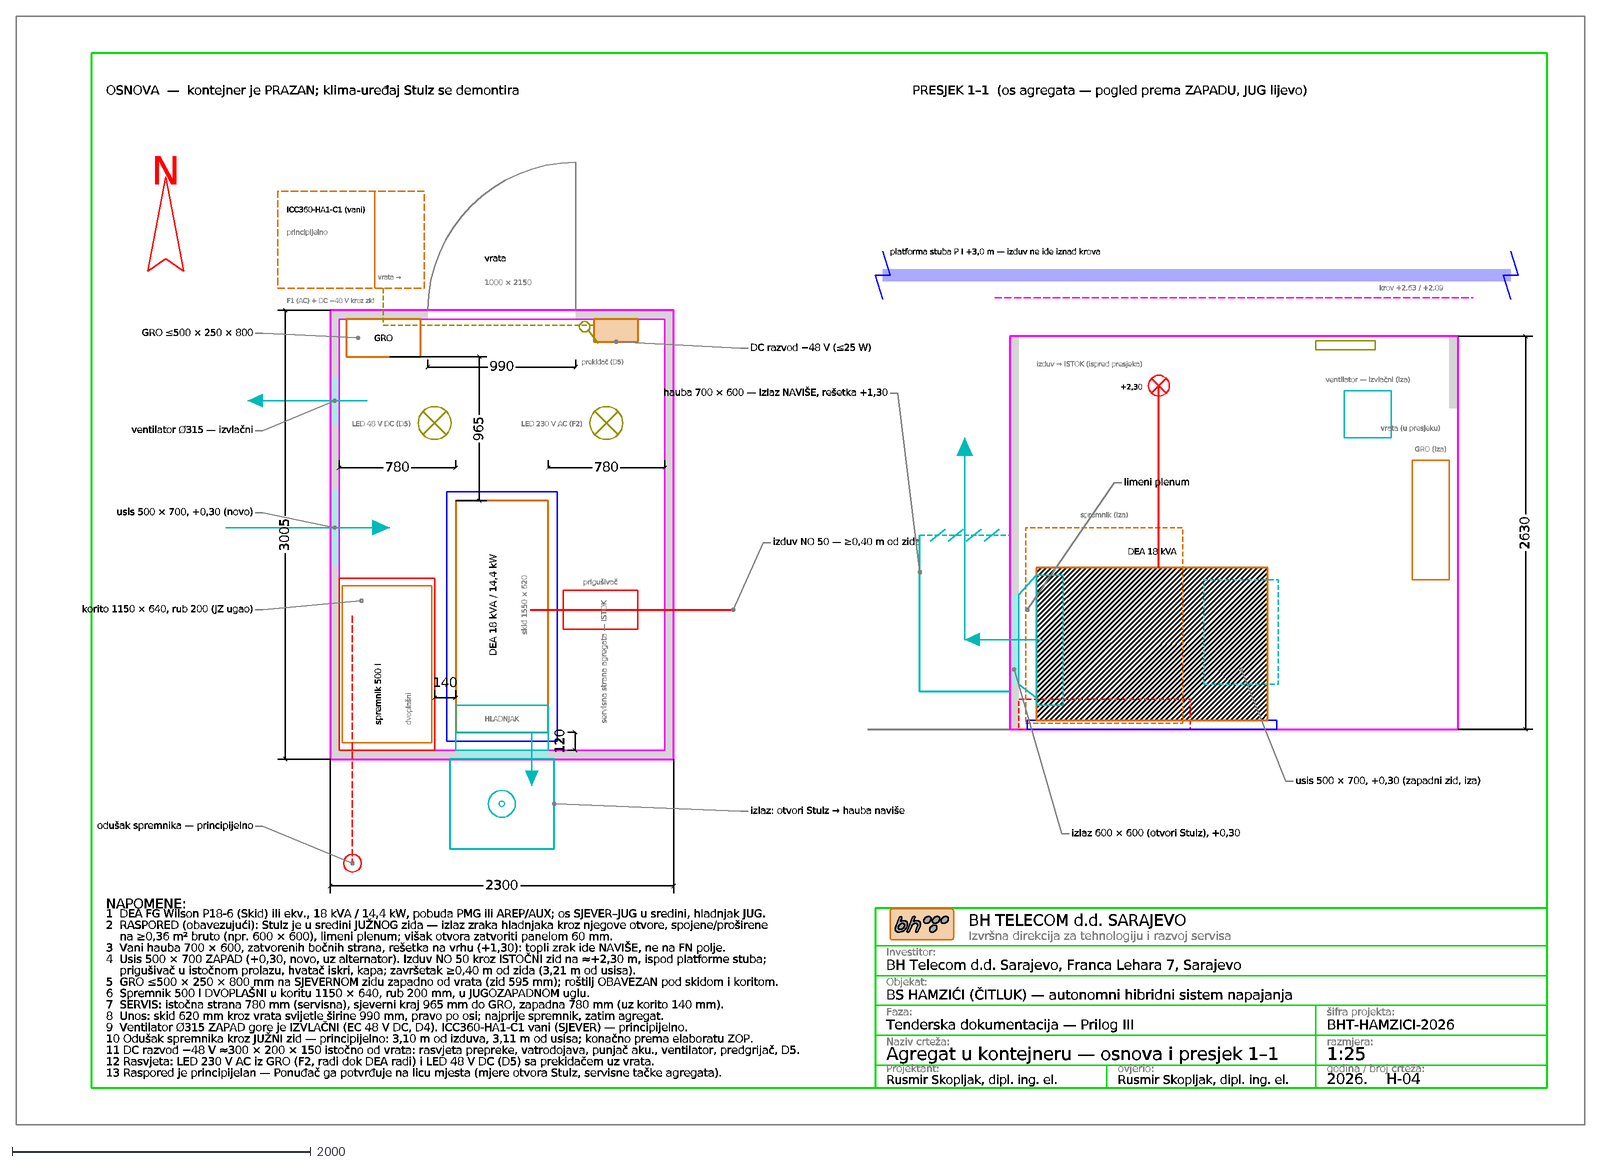
[picture p41: CAD file, 2026-09-11]
rfp-hybrid-solar-td/TD-OUTPUT/grafika/hamzici/H-04.dxf
BH TELECOM d.d. SARAJEVO
Izvršna direkcija za tehnologiju i razvoj servisa
Investitor:
BH Telecom d.d. Sarajevo, Franca Lehara 7, Sarajevo
Objekat:
BS HAMZIĆI (ČITLUK) — autonomni hibridni sistem napajanja
Faza:
Tenderska dokumentacija — Prilog III
šifra projekta:
BHT-HAMZICI-2026
Naziv crteža:
Agregat u kontejneru — osnova i presjek 1–1
razmjera:
1:25
Projektant:
Rusmir Skopljak, dipl. ing. el.
ovjerio:
godina / broj crteža:
2026. H-04
vrata
1000 × 2150
LED 230 V AC (F2)
LED 48 V DC (D5)
prekidač (D5)
F1 (AC) + DC −48 V kroz zid
DEA 18 kVA / 14,4 kW
skid 1550 × 620
HLADNJAK
spremnik 500 l
dvoplašni
GRO
prigušivač
servisna strana agregata — ISTOK
ICC360-HA1-C1 (vani)
principijelno
vrata →
2300
3005
990
780
140
120
965
korito 1150 × 640, rub 200 (JZ ugao)
usis 500 × 700, +0,30 (novo)
ventilator Ø315 — izvlačni
GRO ≤500 × 250 × 800
odušak spremnika — principijelno
DC razvod −48 V (≤25 W)
izduv NO 50 — ≥0,40 m od zida
izlaz: otvori Stulz → hauba naviše
N
OSNOVA — kontejner je PRAZAN; klima-uređaj Stulz se demontira
DEA 18 kVA
+2,30
izduv → ISTOK (ispred presjeka)
platforma stuba P I +3,0 m — izduv ne ide iznad krova
krov +2,63 / +2,89
GRO (iza)
spremnik (iza)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
