ruledicaprio/sjednica-hybrid-solar/bht-sjednica-final-review/TD-OUTPUT/grafika/E-01.dxf

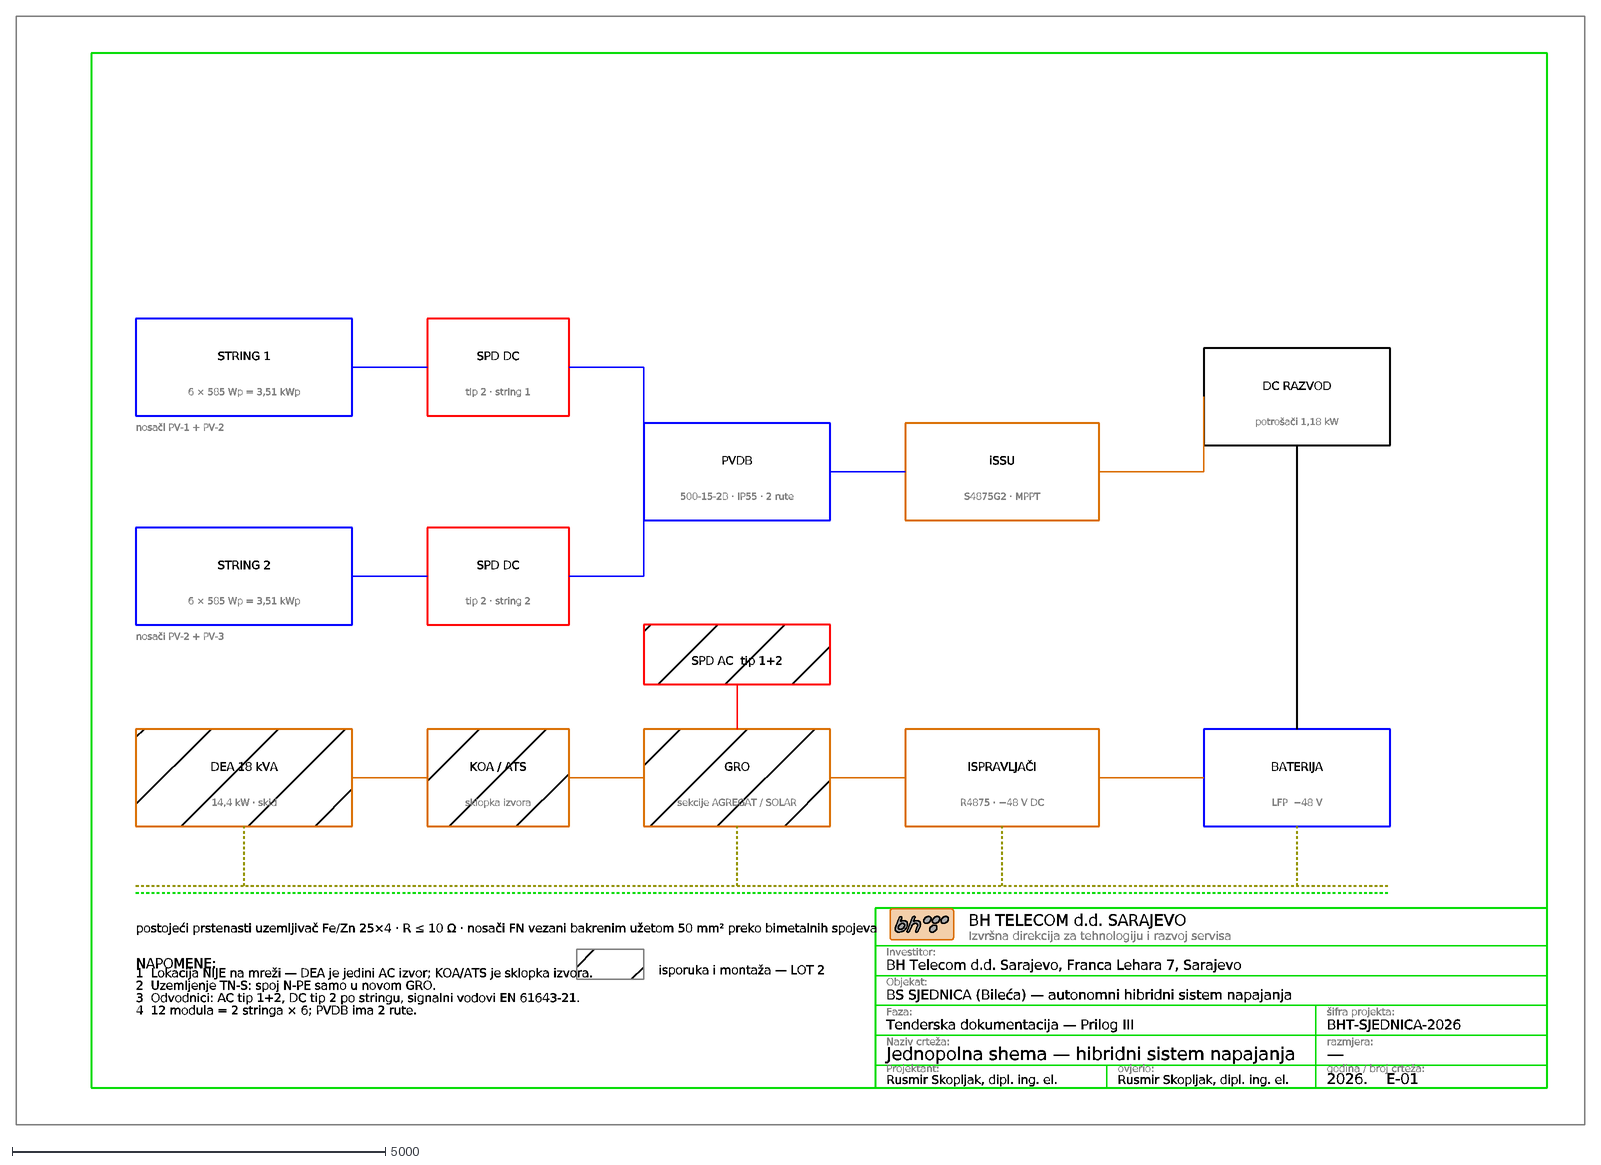
[picture p42: CAD file, 2026-09-11]
bht-sjednica-final-review/TD-OUTPUT/grafika/E-01.dxf
BH TELECOM d.d. SARAJEVO
Izvršna direkcija za tehnologiju i razvoj servisa
Investitor:
BH Telecom d.d. Sarajevo, Franca Lehara 7, Sarajevo
Objekat:
BS SJEDNICA (Bileća) — autonomni hibridni sistem napajanja
Faza:
Tenderska dokumentacija — Prilog III
šifra projekta:
BHT-SJEDNICA-2026
Naziv crteža:
Jednopolna shema — hibridni sistem napajanja
razmjera:
—
Projektant:
Rusmir Skopljak, dipl. ing. el.
ovjerio:
godina / broj crteža:
2026. E-01
STRING 1
6 × 585 Wp = 3,51 kWp
STRING 2
nosači PV-1 + PV-2
nosači PV-2 + PV-3
SPD DC
tip 2 · string 1
tip 2 · string 2
PVDB
500-15-2B · IP55 · 2 rute
iSSU
S4875G2 · MPPT
DEA 18 kVA
14,4 kW · skid
KOA / ATS
sklopka izvora
GRO
sekcije AGREGAT / SOLAR
SPD AC tip 1+2
ISPRAVLJAČI
R4875 · −48 V DC
BATERIJA
LFP −48 V
DC RAZVOD
potrošači 1,18 kW
postojeći prstenasti uzemljivač Fe/Zn 25×4 · R ≤ 10 Ω · nosači FN vezani bakrenim užetom 50 mm² preko bimetalnih spojeva
isporuka i montaža — LOT 2
NAPOMENE:
1 Lokacija NIJE na mreži — DEA je jedini AC izvor; KOA/ATS je sklopka izvora.
2 Uzemljenje TN-S: spoj N-PE samo u novom GRO.
3 Odvodnici: AC tip 1+2, DC tip 2 po stringu, signalni vodovi EN 61643-21.
4 12 modula = 2 stringa × 6; PVDB ima 2 rute.
