ruledicaprio/sjednica-hybrid-solar/(list of files, cad)

Other CAD files:
bht-sjednica-final-review/reference/P13_5_FG_Wilson_hybrid MLINISTE.dwg
bht-sjednica-final-review/reference/P13_5_FG_Wilson_hybrid MLINISTE_2.dwg
hamzici-hybrid-solar/TD-OUTPUT/grafika/H-05.dxf
rfp-hybrid-solar-td/TD-OUTPUT/grafika/hamzici/H-05.dxf
bht-sjednica-final-review/TD-OUTPUT/grafika/E-01.dwg
bht-sjednica-final-review/TD-OUTPUT/grafika/M-01.dwg
bht-sjednica-final-review/TD-OUTPUT/grafika/S-01.dwg
bht-sjednica-final-review/TD-OUTPUT/grafika/S-02.dwg
bht-sjednica-final-review/TD-OUTPUT/grafika/S-03.dwg
hamzici-hybrid-solar/TD-OUTPUT/grafika/H-01.dwg
hamzici-hybrid-solar/TD-OUTPUT/grafika/H-02.dwg
hamzici-hybrid-solar/TD-OUTPUT/grafika/H-03.dwg
hamzici-hybrid-solar/TD-OUTPUT/grafika/H-04.dwg
hamzici-hybrid-solar/TD-OUTPUT/grafika/H-05.dwg
rfp-hybrid-solar-td/TD-OUTPUT/grafika/hamzici/H-01.dwg
rfp-hybrid-solar-td/TD-OUTPUT/grafika/hamzici/H-02.dwg
rfp-hybrid-solar-td/TD-OUTPUT/grafika/hamzici/H-03.dwg
rfp-hybrid-solar-td/TD-OUTPUT/grafika/hamzici/H-04.dwg
rfp-hybrid-solar-td/TD-OUTPUT/grafika/hamzici/H-05.dwg
rfp-hybrid-solar-td/TD-OUTPUT/grafika/sjednica/E-01.dwg
rfp-hybrid-solar-td/TD-OUTPUT/grafika/sjednica/M-01.dwg
rfp-hybrid-solar-td/TD-OUTPUT/grafika/sjednica/S-01.dwg
rfp-hybrid-solar-td/TD-OUTPUT/grafika/sjednica/S-02.dwg
rfp-hybrid-solar-td/TD-OUTPUT/grafika/sjednica/S-03.dwg
