ruledicaprio/sjednica-hybrid-solar/rural-star-sjednica/results/pvlib_annual_estimate.csv

 | poa_global_w_m2 | e_dc_kwh
1978-01-01 00:00:00+01:00 | 0.0 | 0.0
1978-01-01 01:00:00+01:00 | 0.0 | 0.0
1978-01-01 02:00:00+01:00 | 0.0 | 0.0
1978-01-01 03:00:00+01:00 | 0.0 | 0.0
1978-01-01 04:00:00+01:00 | 0.0 | 0.0
1978-01-01 05:00:00+01:00 | 0.0 | 0.0
1978-01-01 06:00:00+01:00 | 0.0 | 0.0
1978-01-01 07:00:00+01:00 | 0.0 | 0.0
1978-01-01 08:00:00+01:00 | 119.1759107675795 | 0.6692919148707265
1978-01-01 09:00:00+01:00 | 295.44746299952726 | 1.659232952205345
1978-01-01 10:00:00+01:00 | 395.1714377192298 | 2.2192827942311943
1978-01-01 11:00:00+01:00 | 468.43870222862563 | 2.6307517517159615
1978-01-01 12:00:00+01:00 | 480.3214922468832 | 2.6974855004584963
1978-01-01 13:00:00+01:00 | 419.5389571100246 | 2.3561307831298985
1978-01-01 14:00:00+01:00 | 344.4762998805155 | 1.9345789001289753
1978-01-01 15:00:00+01:00 | 237.10248072744923 | 1.331567531765355
1978-01-01 16:00:00+01:00 | 18.812207099267628 | 0.10564935506948699
1978-01-01 17:00:00+01:00 | 0.05857864376269049 | 0.0003289776633712698
1978-01-01 18:00:00+01:00 | 0.0 | 0.0
1978-01-01 19:00:00+01:00 | 0.0 | 0.0
1978-01-01 20:00:00+01:00 | 0.0 | 0.0
1978-01-01 21:00:00+01:00 | 0.0 | 0.0
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
