ruledicaprio/sjednica-hybrid-solar/rural-star-sjednica/scripts/results/model_comparison.csv

datetime | PVLib_POA_W | Radiance_Front_W | Radiance_Back_W | Radiance_Total_W | Ambient_Temp
1978-01-01 08:00:00+01:00 | 93.50270037616534 | 0.1214694 | 0.06121704 | 0.170443032 | -5.6
1978-01-01 09:00:00+01:00 | 242.4269108132118 | 0.5787714 | 0.003821874 | 0.5818288992 | -5.6
1978-01-01 10:00:00+01:00 | 329.6943304021347 | 0.9597553 | 0.1456311 | 1.07626018 | -5.2
1978-01-01 11:00:00+01:00 | 411.93528631839285 | 1.325171 | 0.1095191 | 1.4127862800000002 | -3.1
1978-01-01 12:00:00+01:00 | 412.02009044678493 | 1.340458 | 0.0574526 | 1.38642008 | -2.9
1978-01-01 13:00:00+01:00 | 347.77692078823077 | 1.208185 | 0.009516924 | 1.2157985392000001 | -2.9
1978-01-01 14:00:00+01:00 | 283.8639234296404 | 0.9254003000000001 | 0.00823301 | 0.931986708 | -3.0
1978-01-01 15:00:00+01:00 | 198.76788374450211 | 0.5996197 | 0.022876159999999996 | 0.617920628 | -3.6
1978-01-01 16:00:00+01:00 | 18.0920310216783 | 0.10878130000000001 | 0.001271285 | 0.10979832800000001 | -3.3
1978-01-02 08:00:00+01:00 | 99.9235640489753 | 0.1470136 | 0.01551507 | 0.159425656 | -12.2
1978-01-02 09:00:00+01:00 | 303.4181855086342 | 0.7666065999999999 | 0.024743940000000002 | 0.786401752 | -10.3
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
