ruledicaprio/sjednica-hybrid-solar/rural-star-sjednica/output/report_results/daily_profile.png

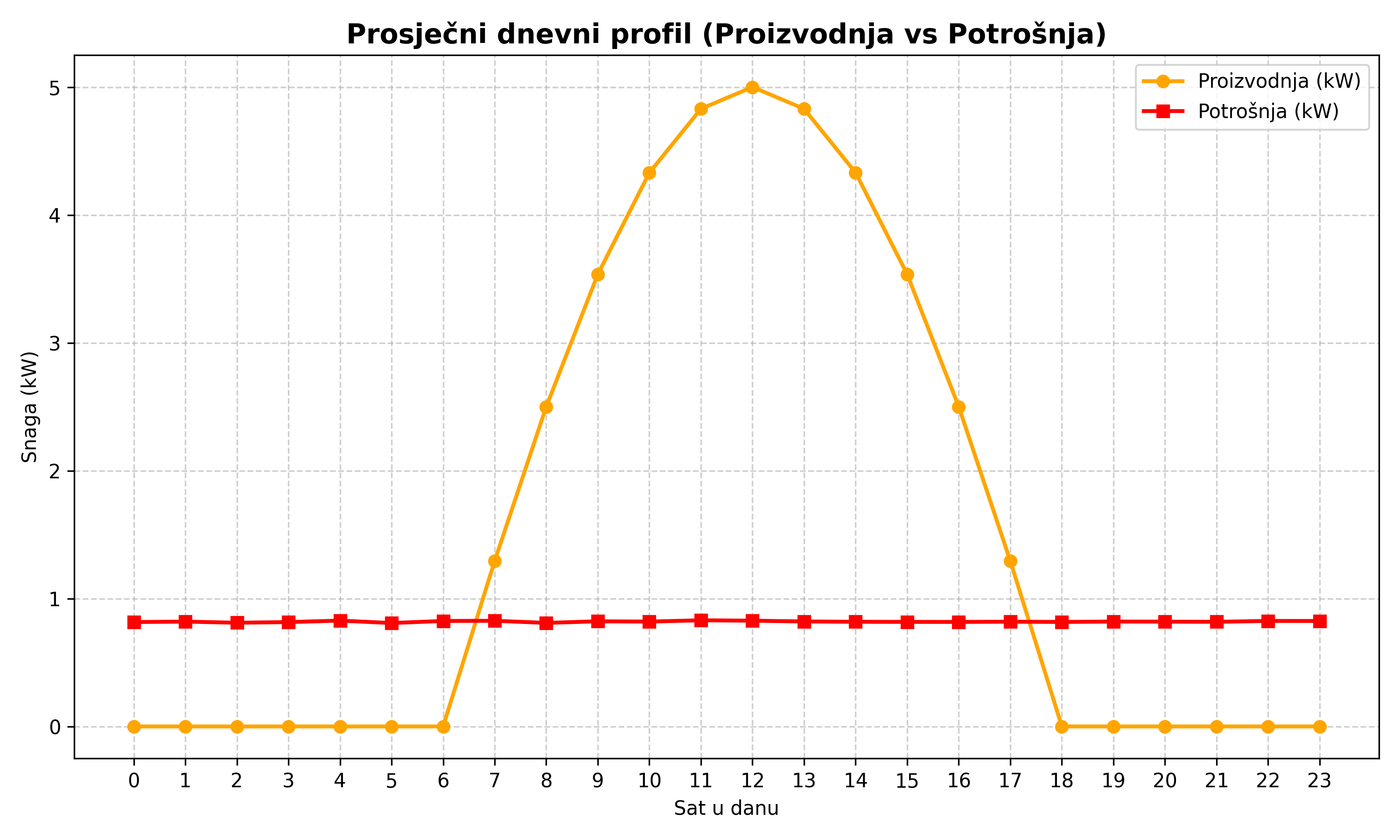
rural-star-sjednica/output/report_results/daily_profile.png
