ruledicaprio/sjednica-hybrid-solar/rural-star-sjednica/output/report_results/monthly_balance.png

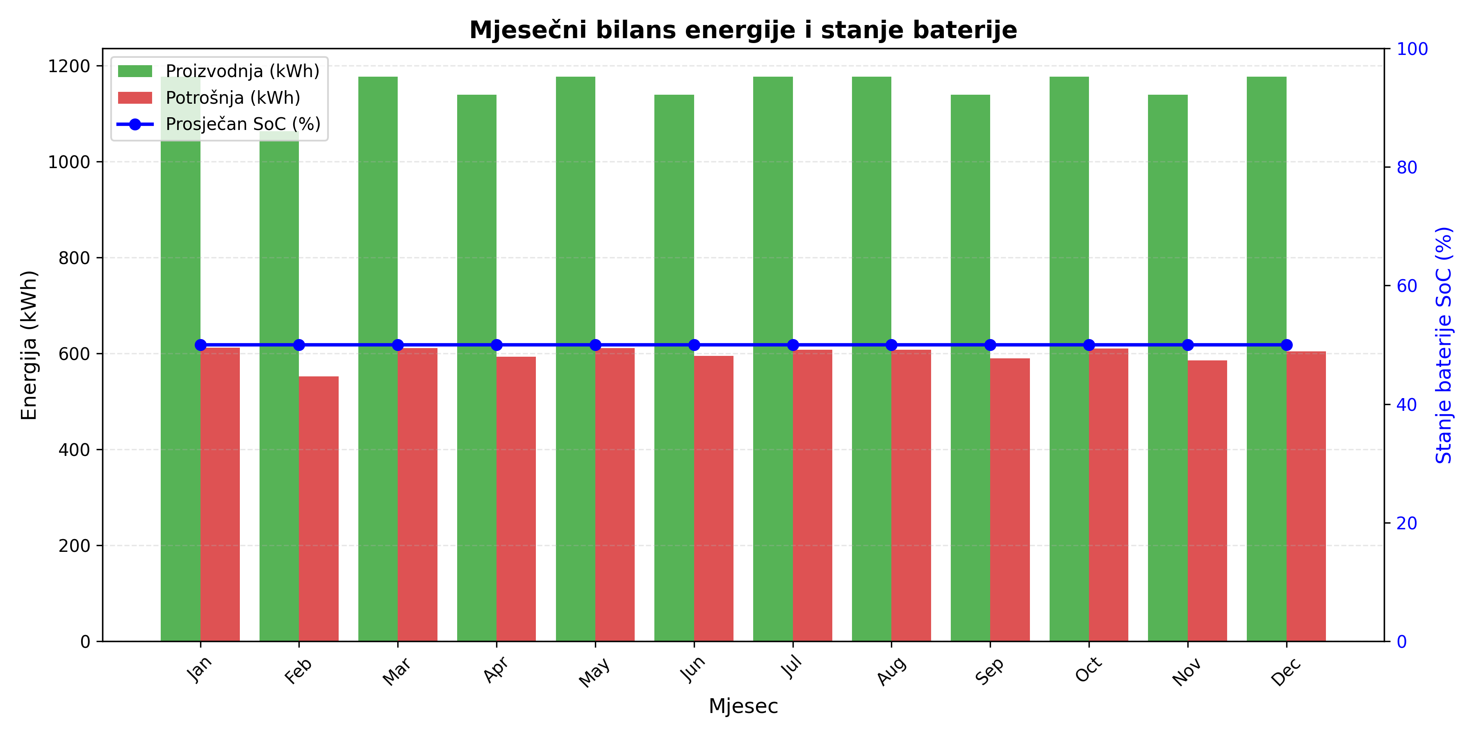
rural-star-sjednica/output/report_results/monthly_balance.png
