ruledicaprio/sjednica-hybrid-solar/rural-star-sjednica/output/report_results/system_layout.png

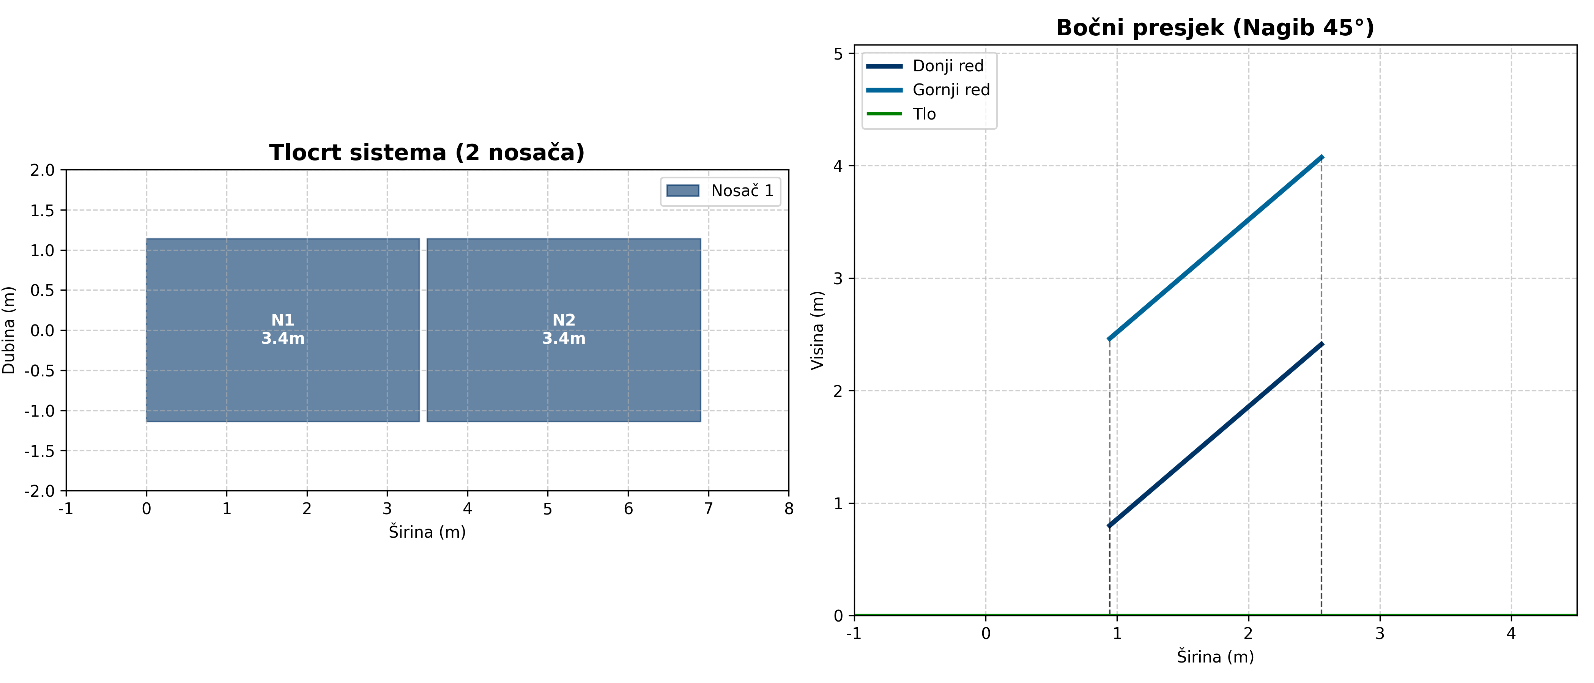
rural-star-sjednica/output/report_results/system_layout.png
