ruledicaprio/sjednica-hybrid-solar/bht-sjednica-final-review/TD-OUTPUT/Situacija_BS_Sjednica.pdf

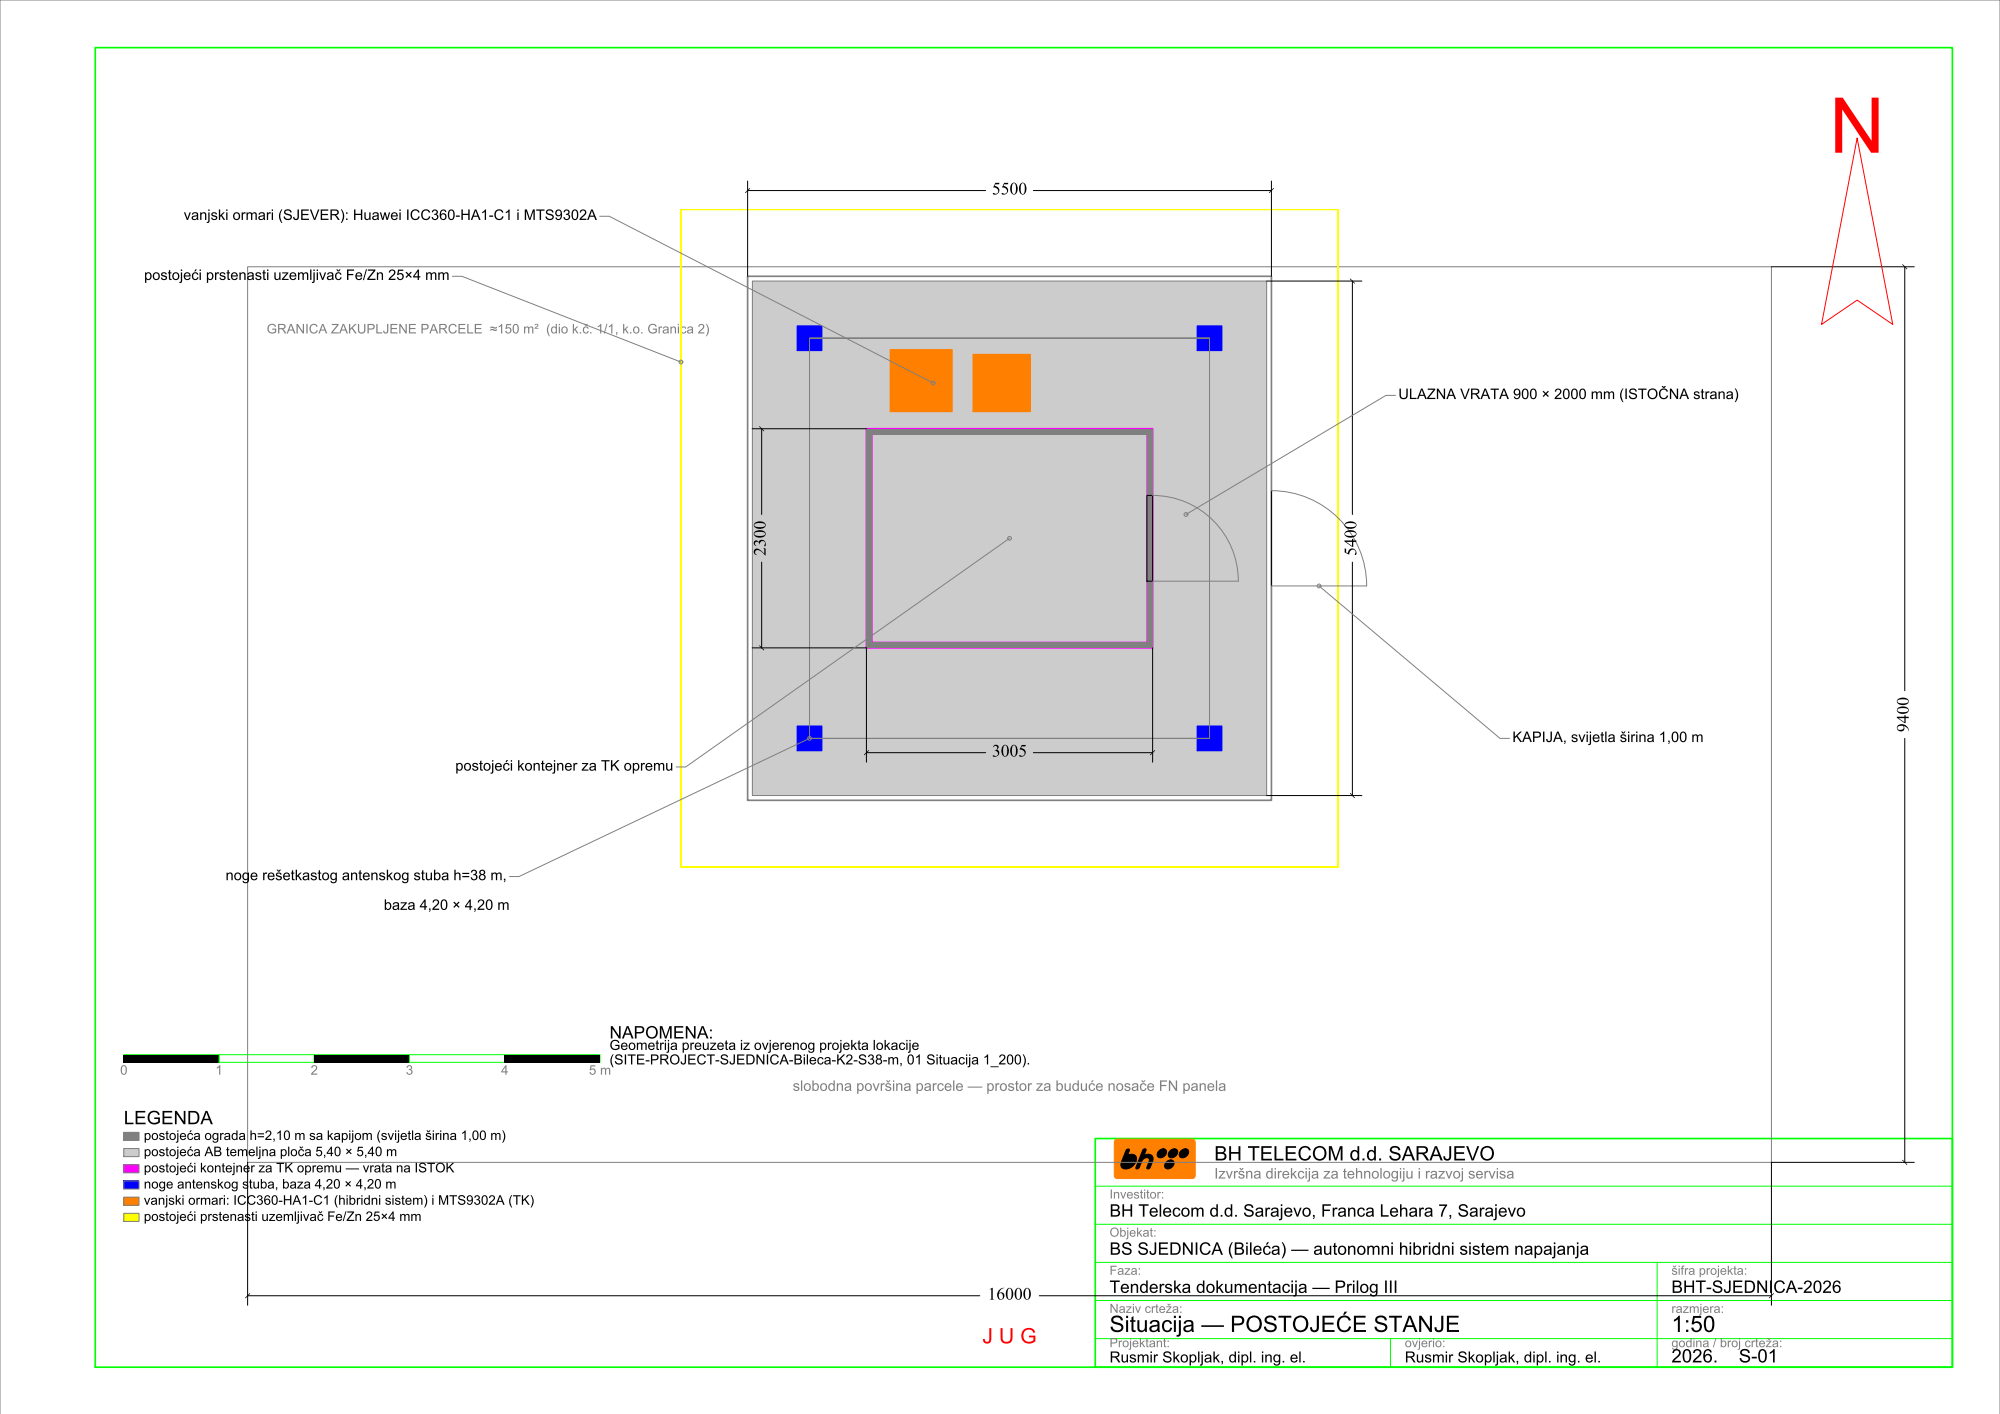
[picture p46: page 1]

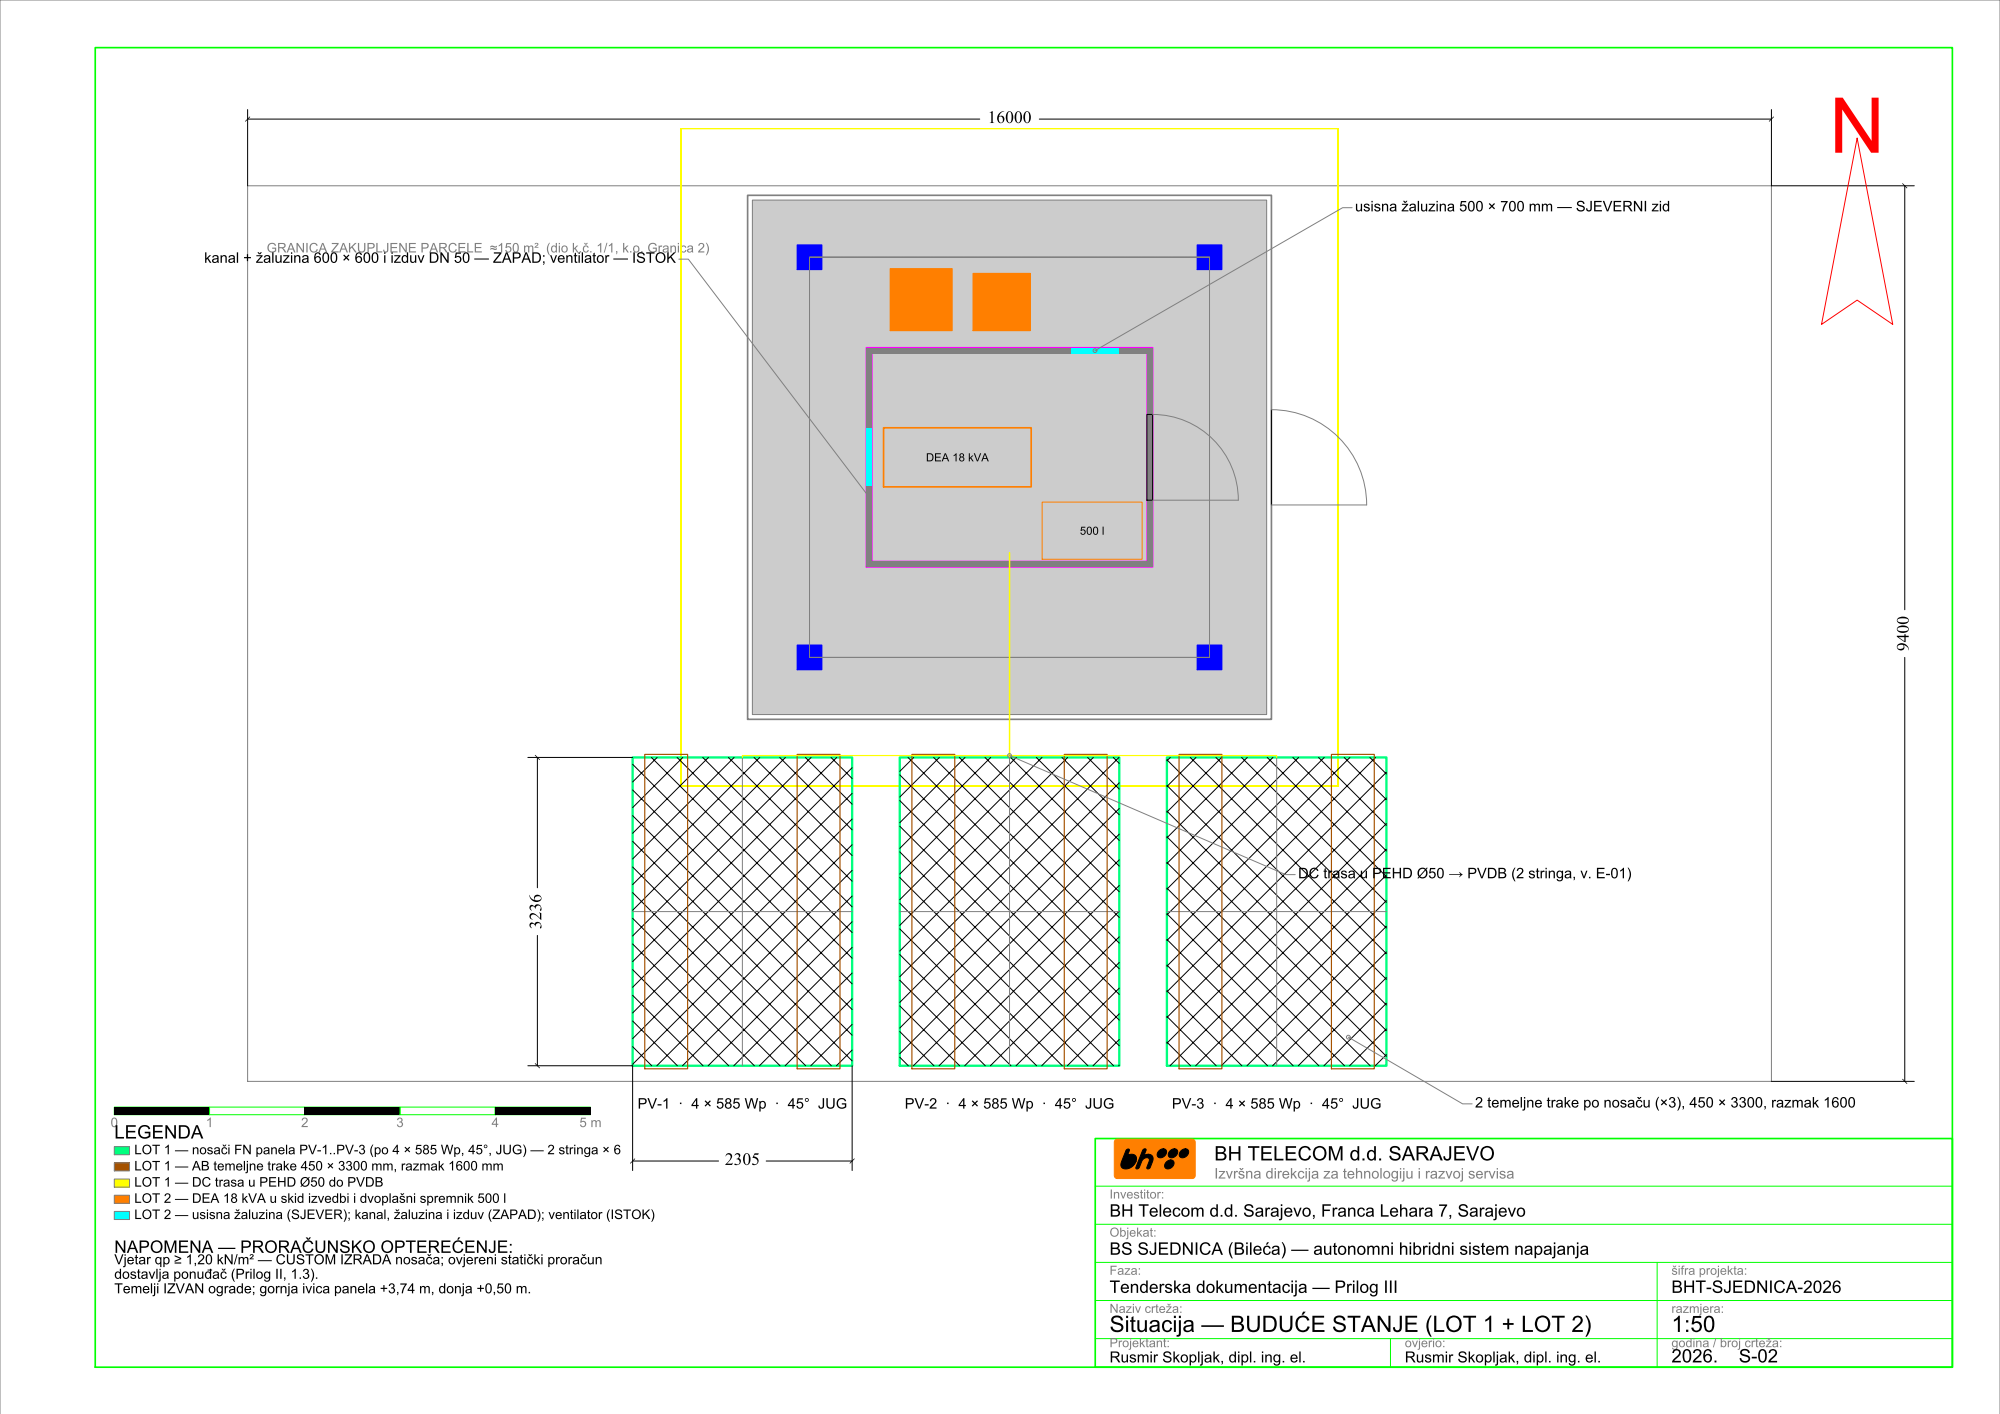
[picture p47: page 2]

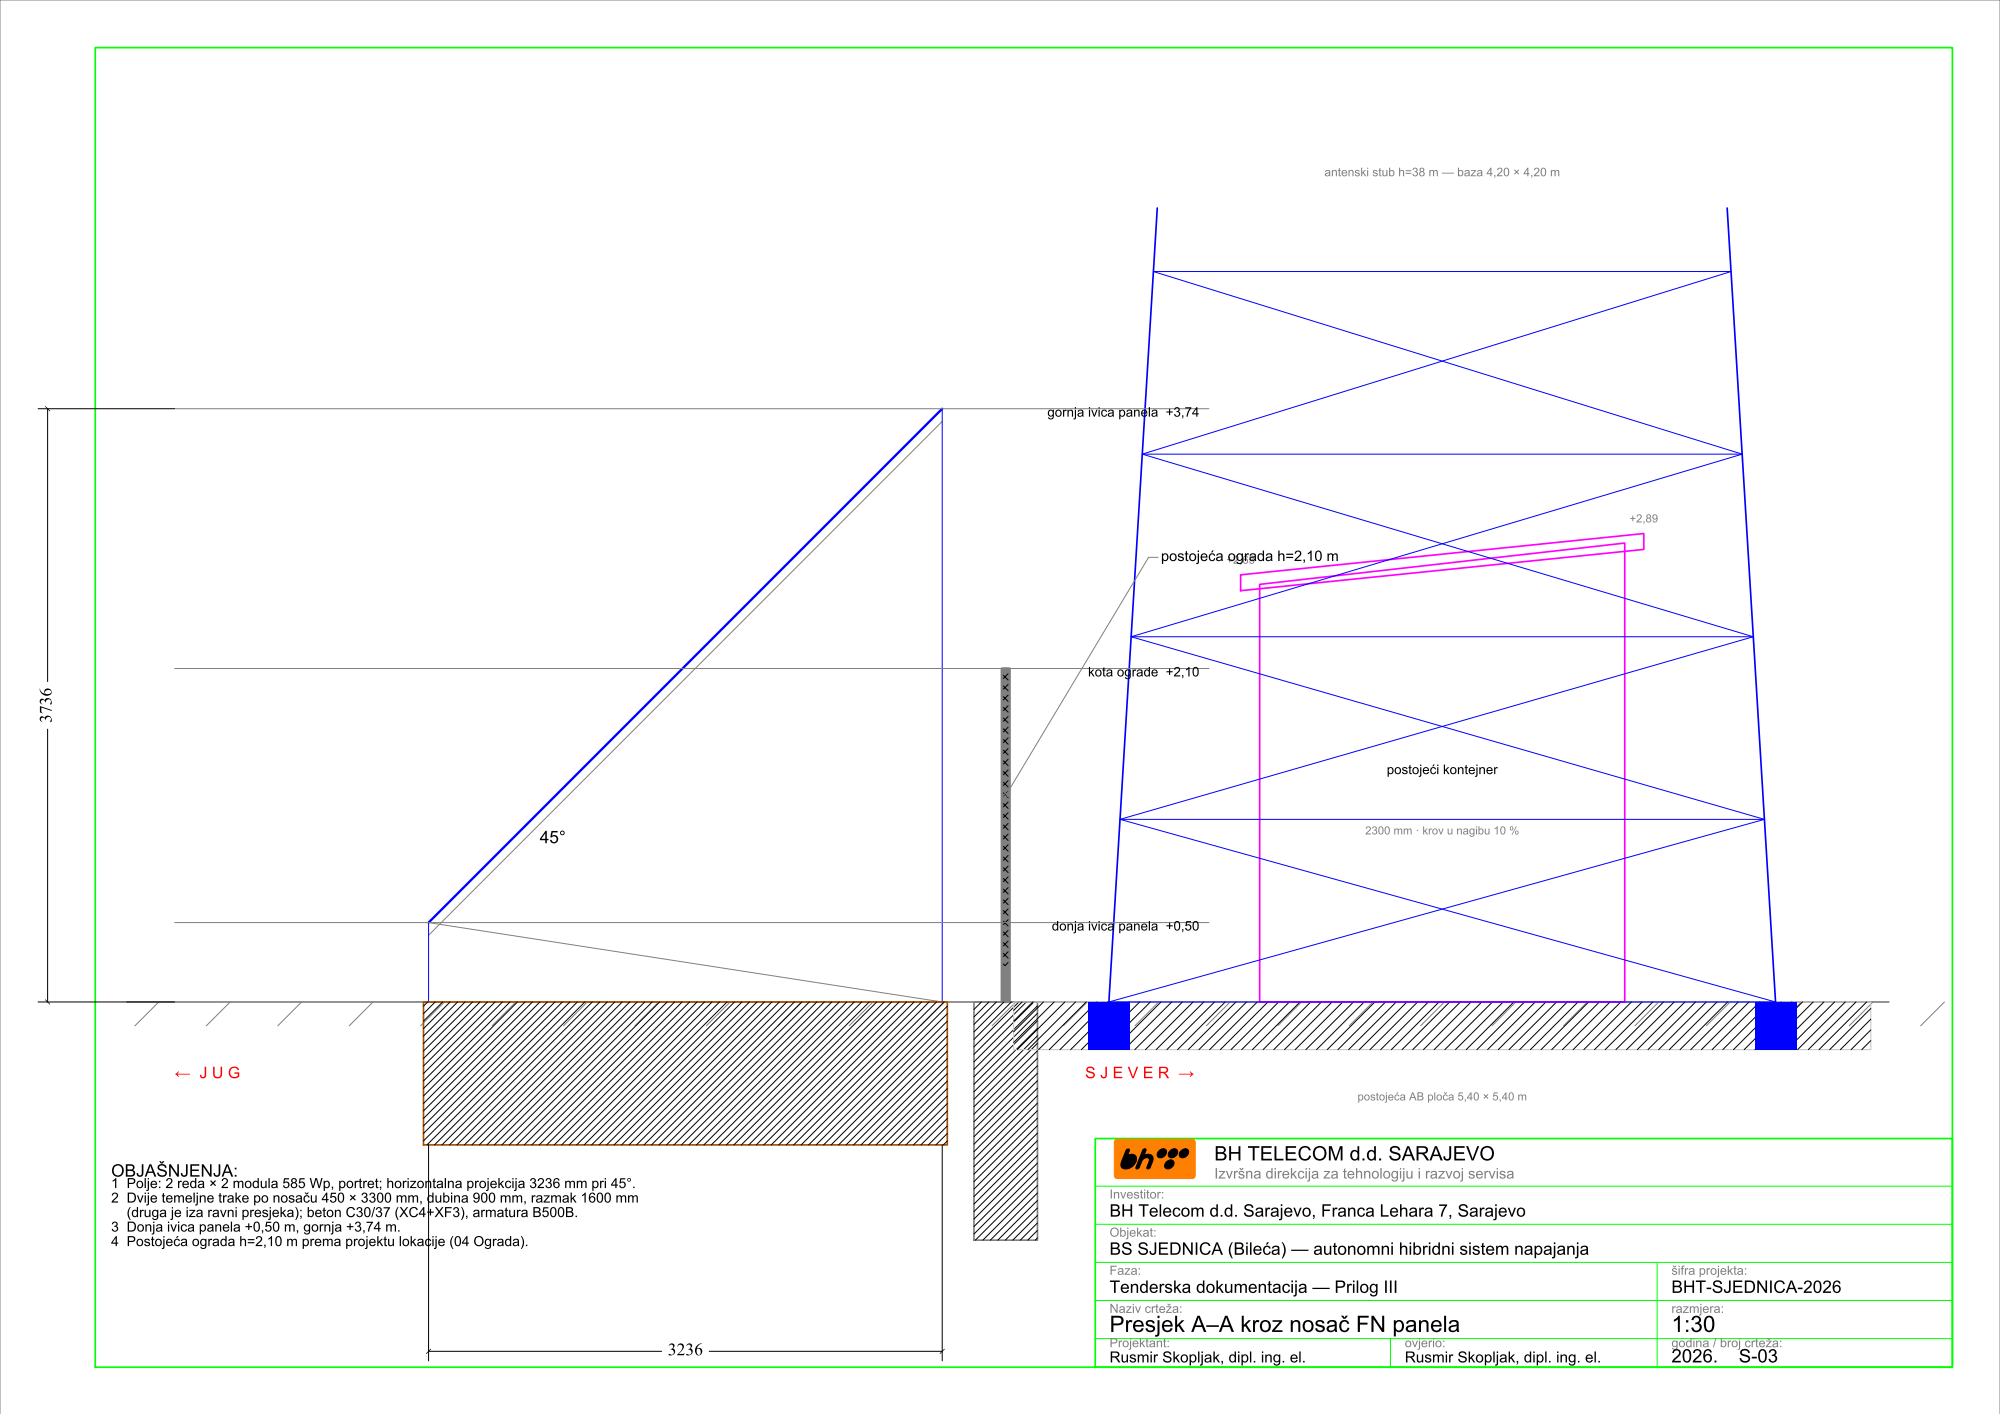
[picture p48: page 3]

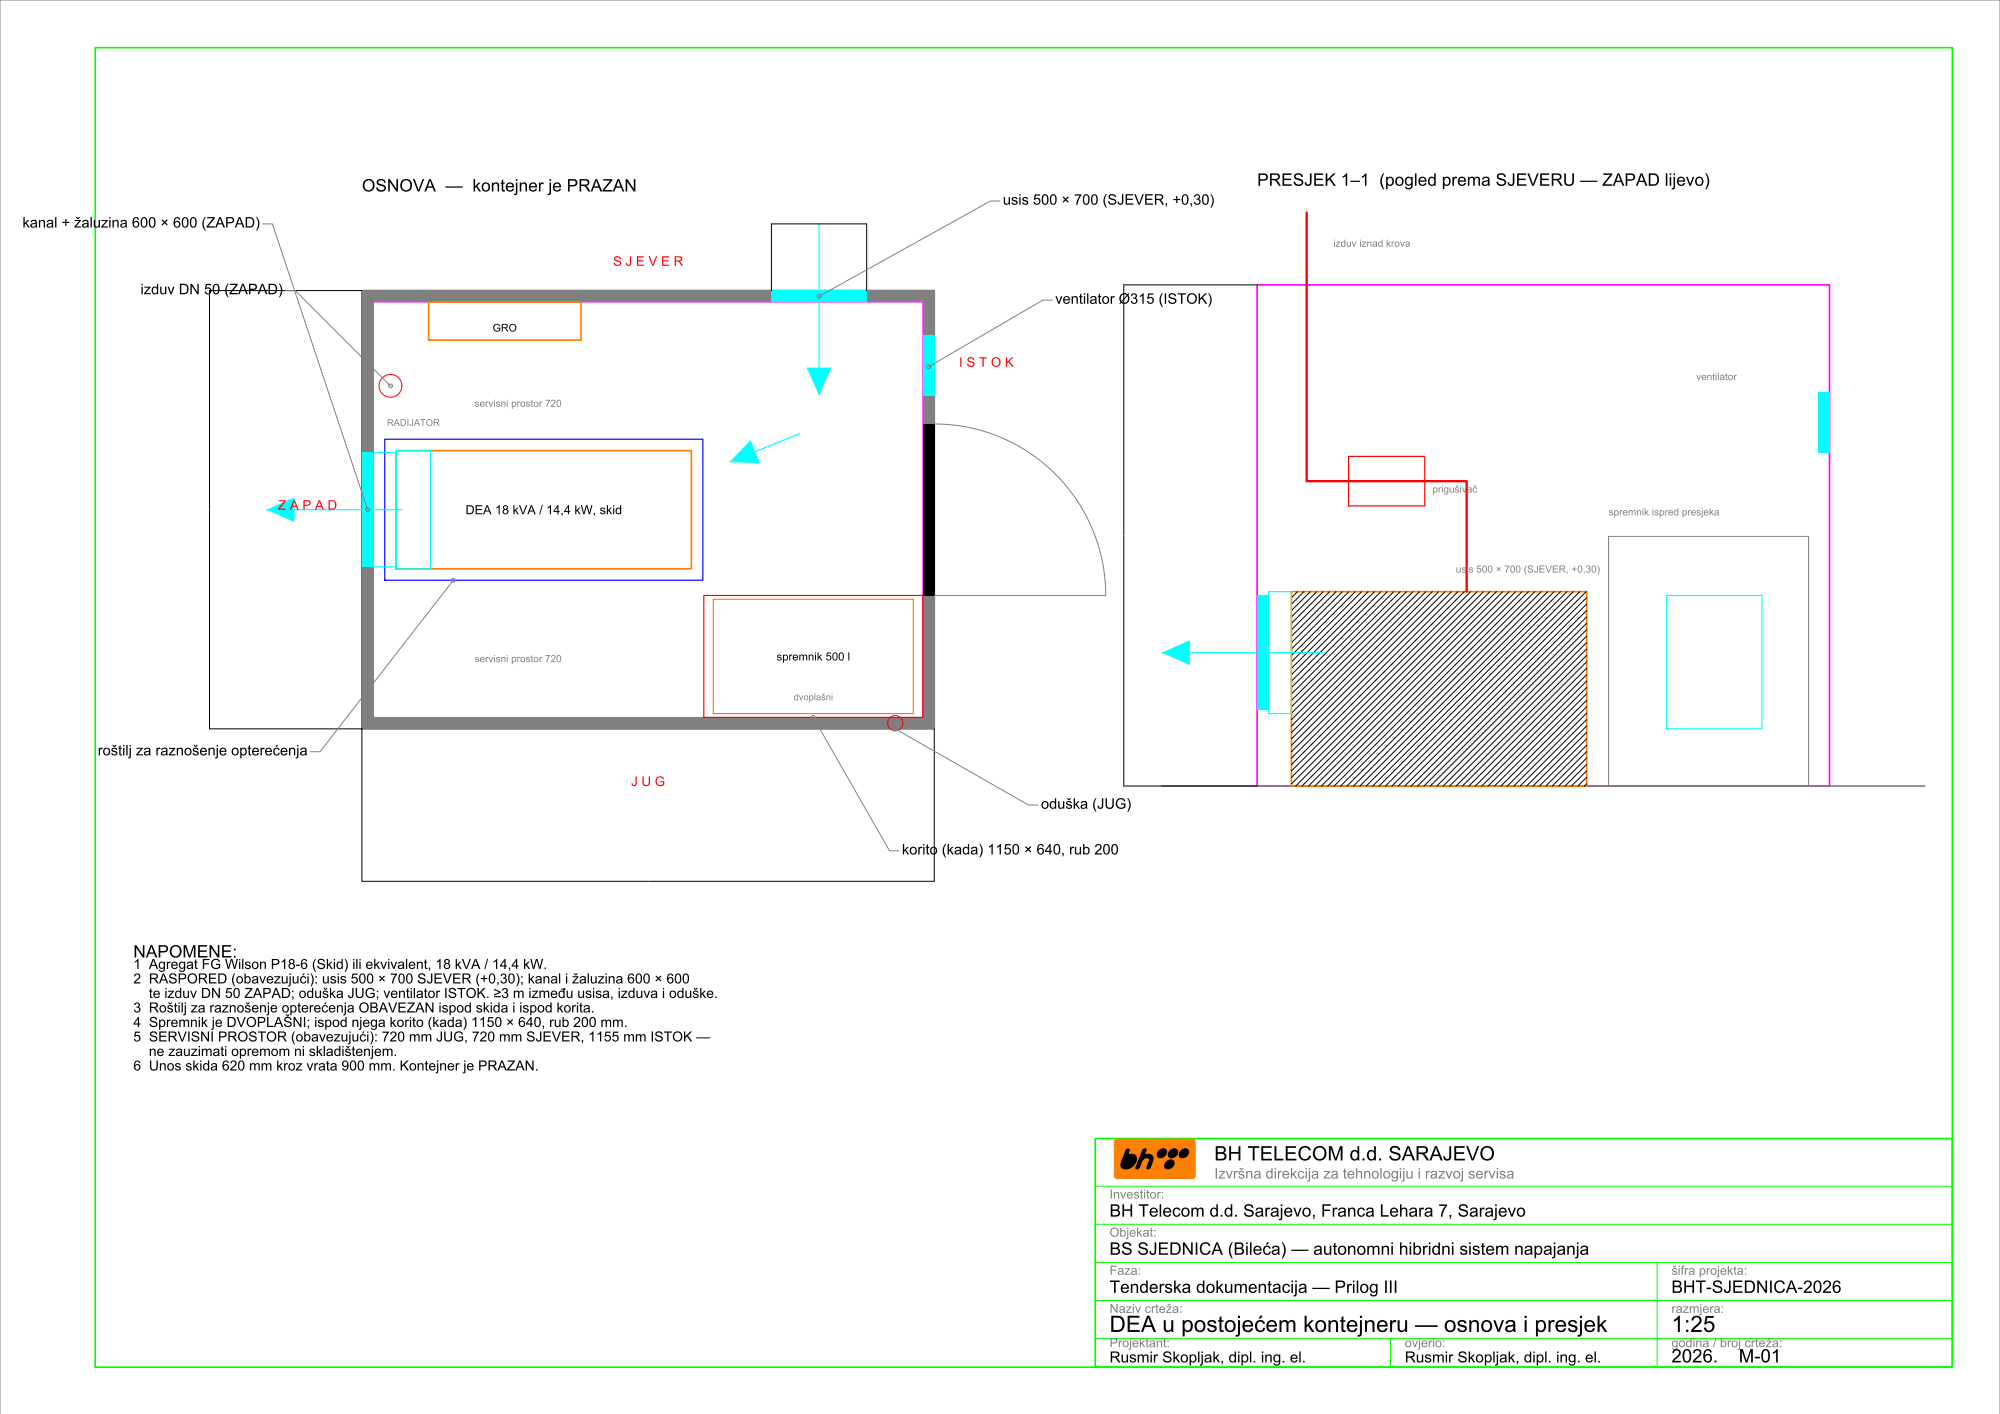
[picture p49: page 4]

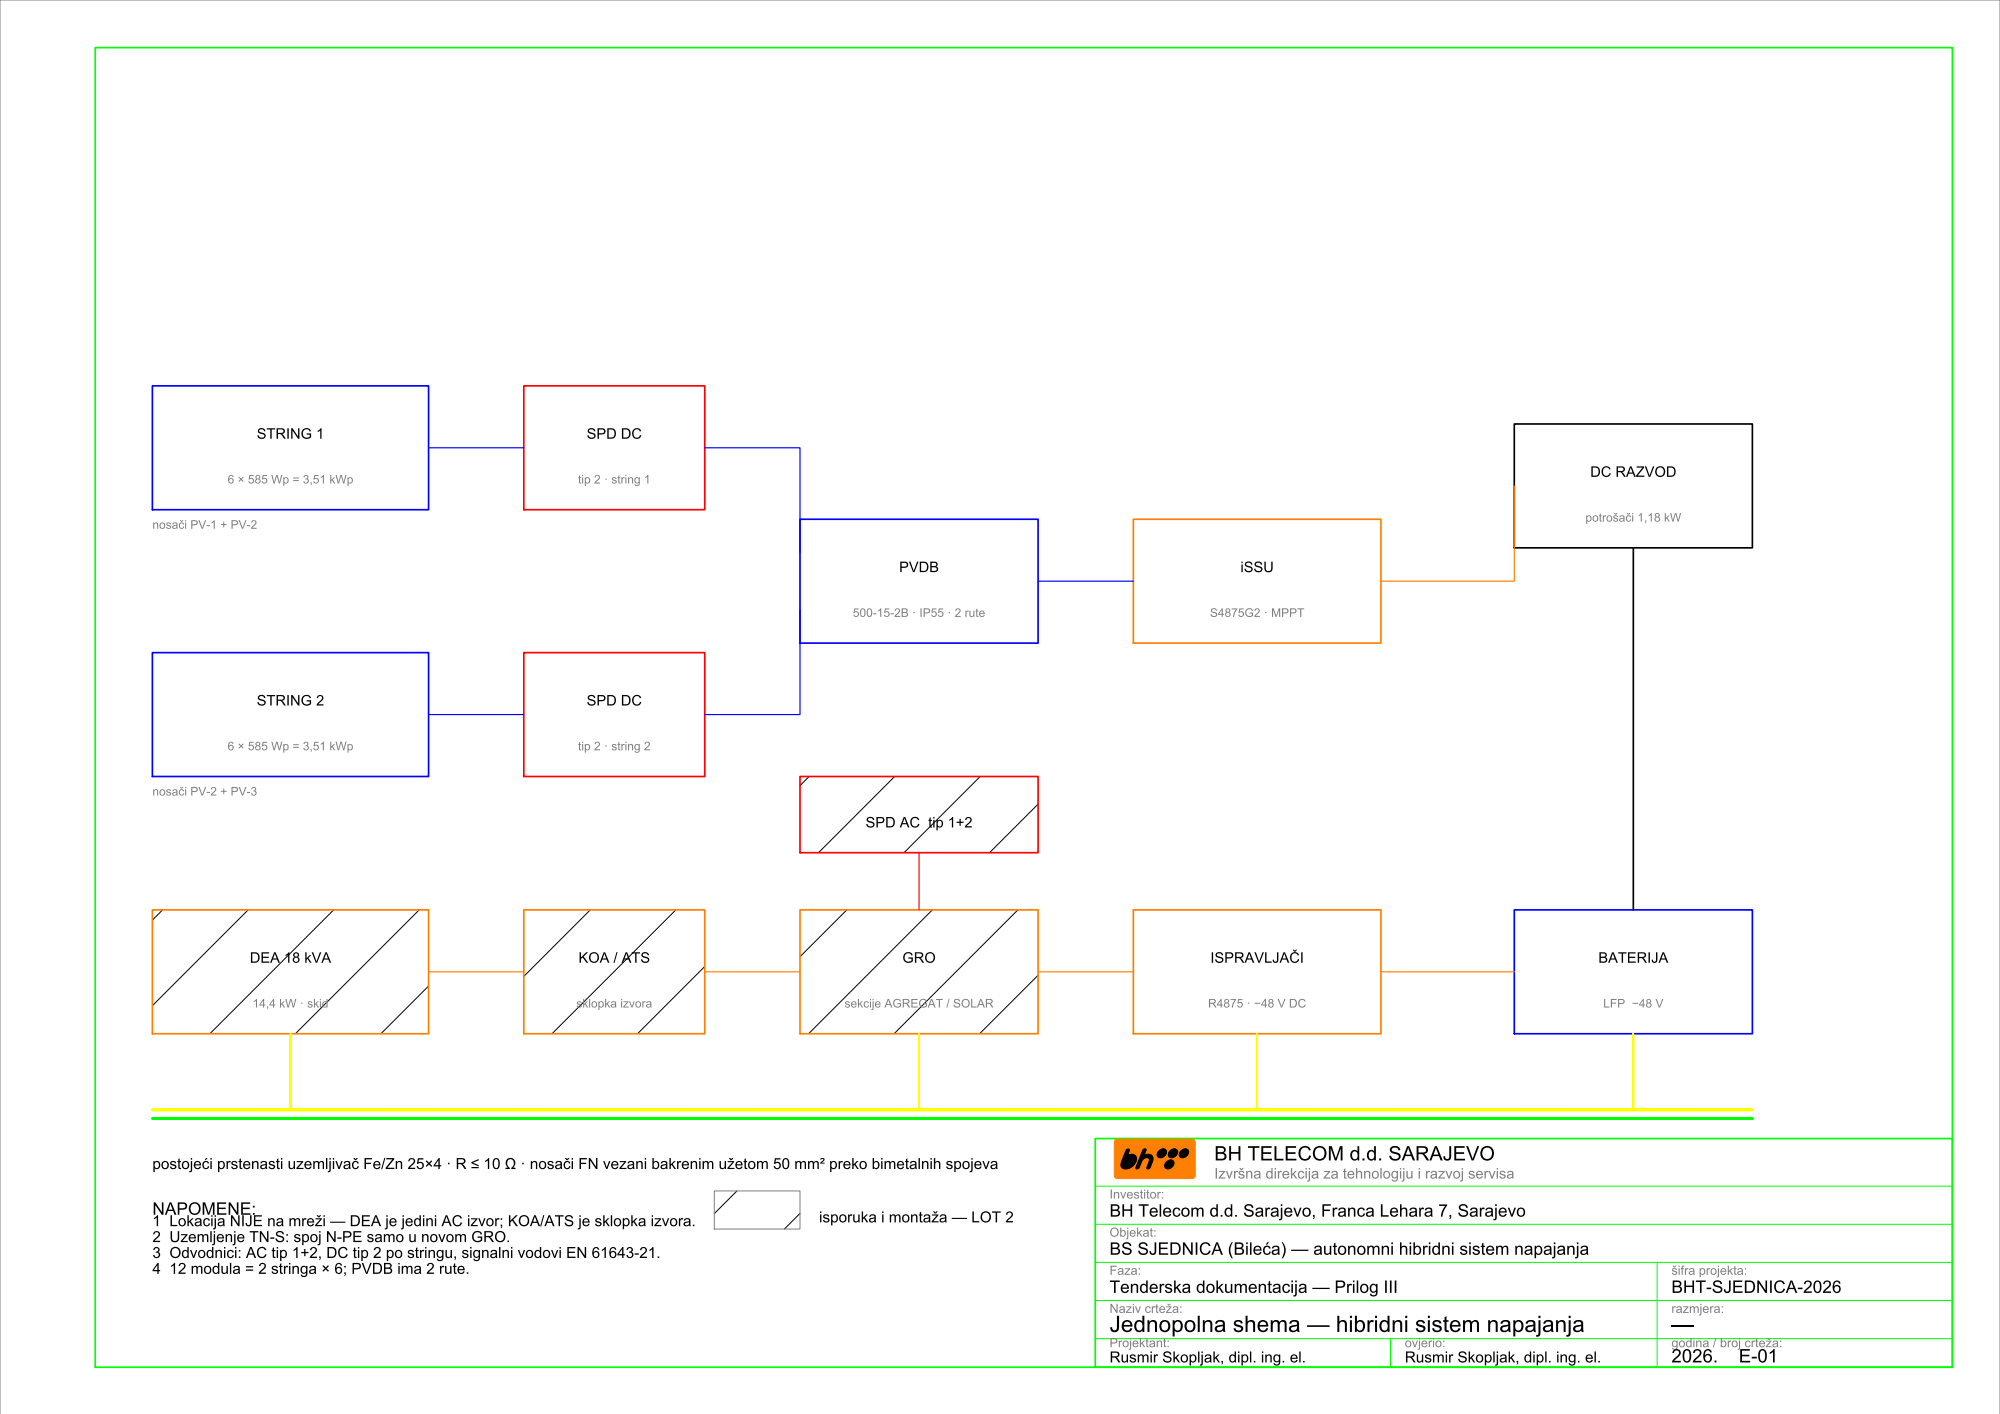
[picture p50: page 5]
