ruledicaprio/sjednica-hybrid-solar/rural-star-sjednica/docs/02_Dispozicija K2_S32 m.pdf

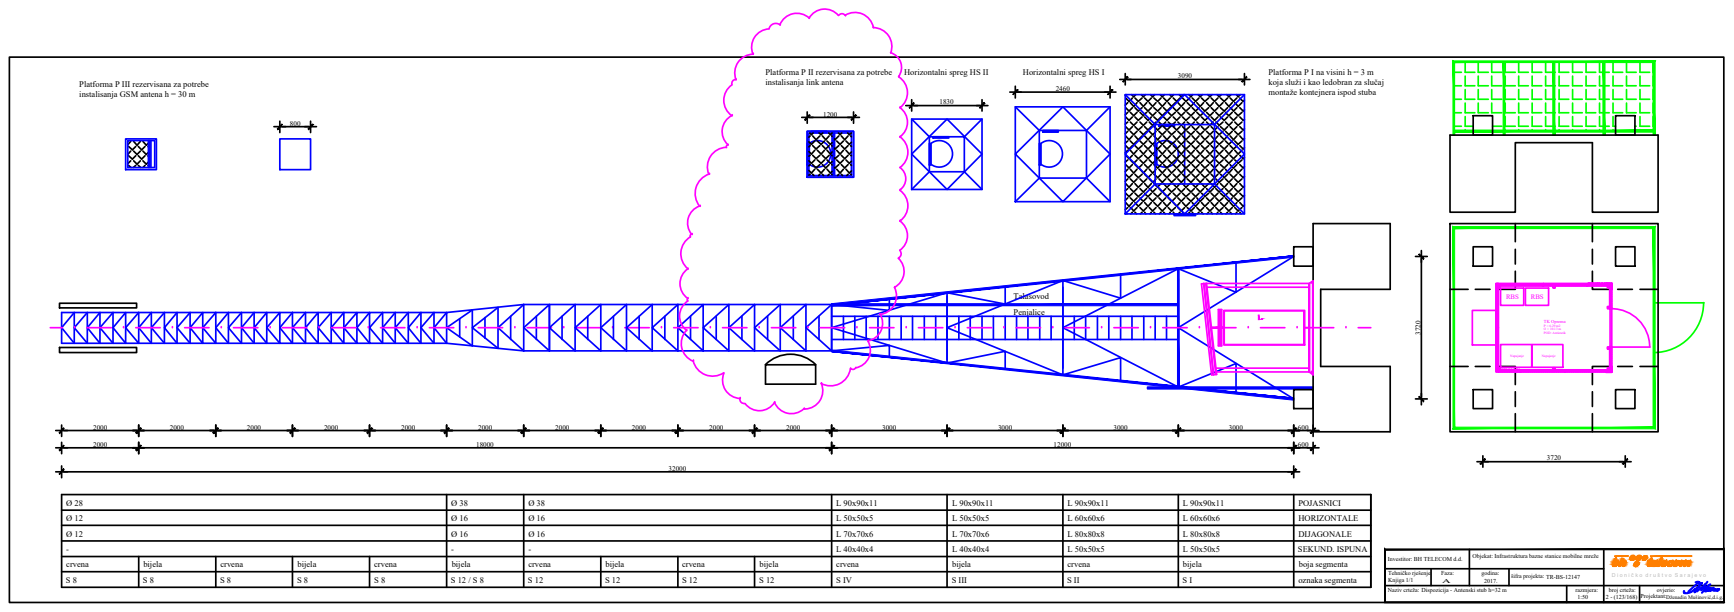
[picture p51: page 1]
Naziv crteža:; Faza:; šifra projekta: godina:; broj crteža:; Tehničko rješenje; Knjiga 1/1; Dženadin Mušinović,d.i.g.; Horizontalni spreg HS II; Horizontalni spreg HS I; Platforma P I na visini h = 3 m; S III; oznaka segmenta crvena; bijela; crvena; boja segmenta -Ø 12; SEKUND. ISPUNA DIJAGONALE HORIZONTALE POJASNICI; P = 6.29 m2 O = 10.13 m POD: Antistatik; TK Oprema

Platforma P III rezervisana za potrebe
instalisanja GSM antena h = 30 m

Platforma P II rezervisana za potrebe
instalisanja link antena

koja služi i kao ledobran za slučaj
montaže kontejnera ispod stuba

Objekat: Investitor: BH TELECOM d.d.

Infrastruktura bazne stanice mobilne mreže

Dispozicija - Antenski stub h=32 m
