ruledicaprio/sjednica-hybrid-solar/hamzici-hybrid-solar/TD-OUTPUT/grafika/H-01.pdf

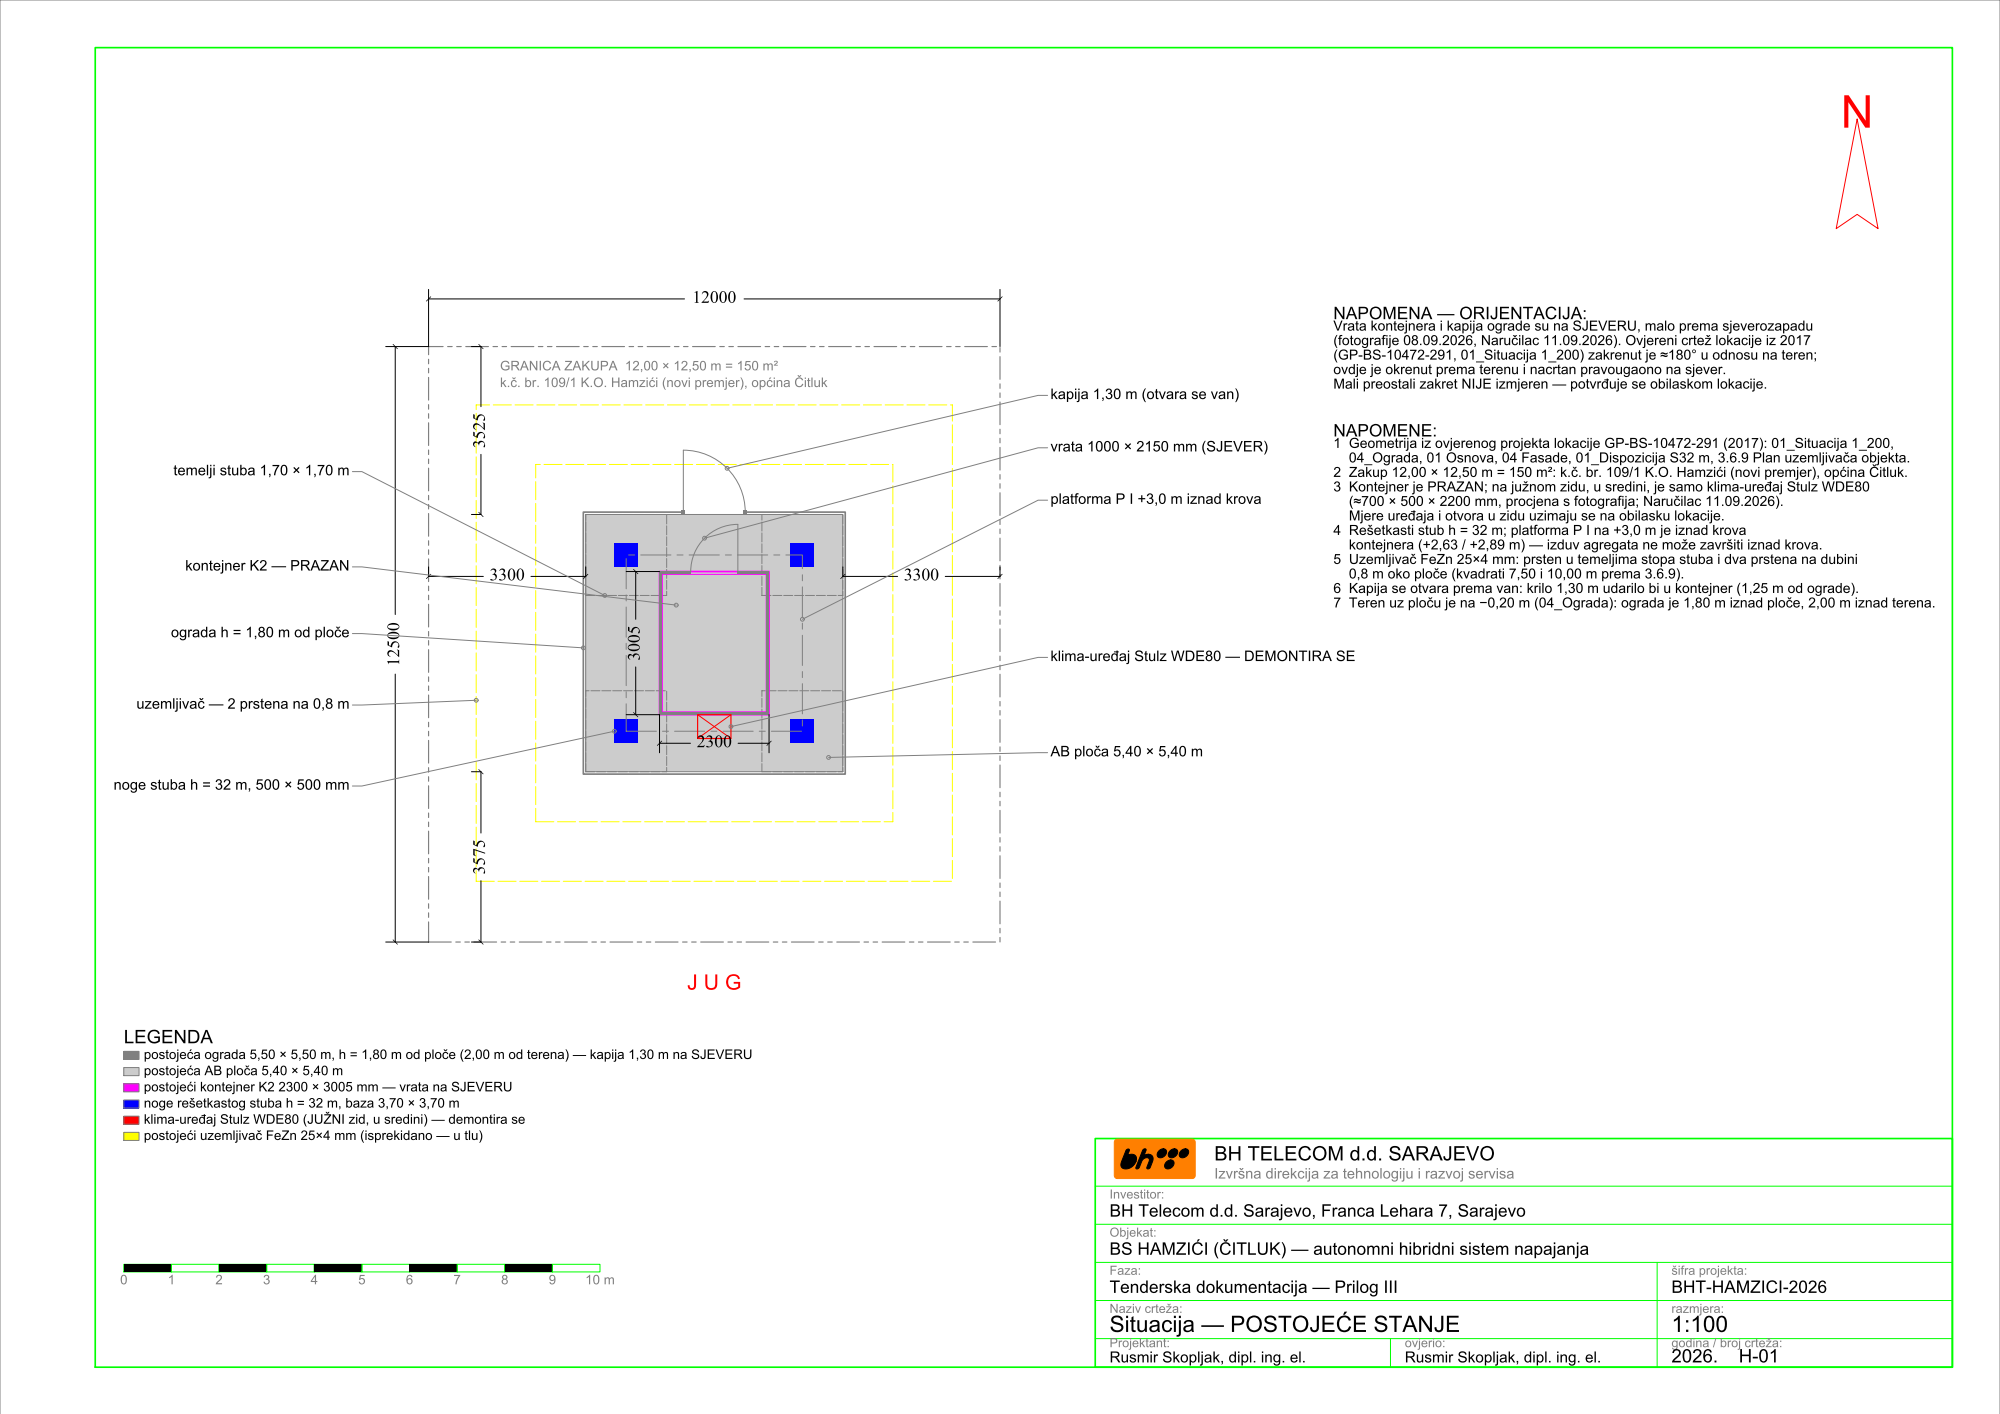
[picture p56: page 1]
