ruledicaprio/sjednica-hybrid-solar/hamzici-hybrid-solar/TD-OUTPUT/grafika/H-02.pdf

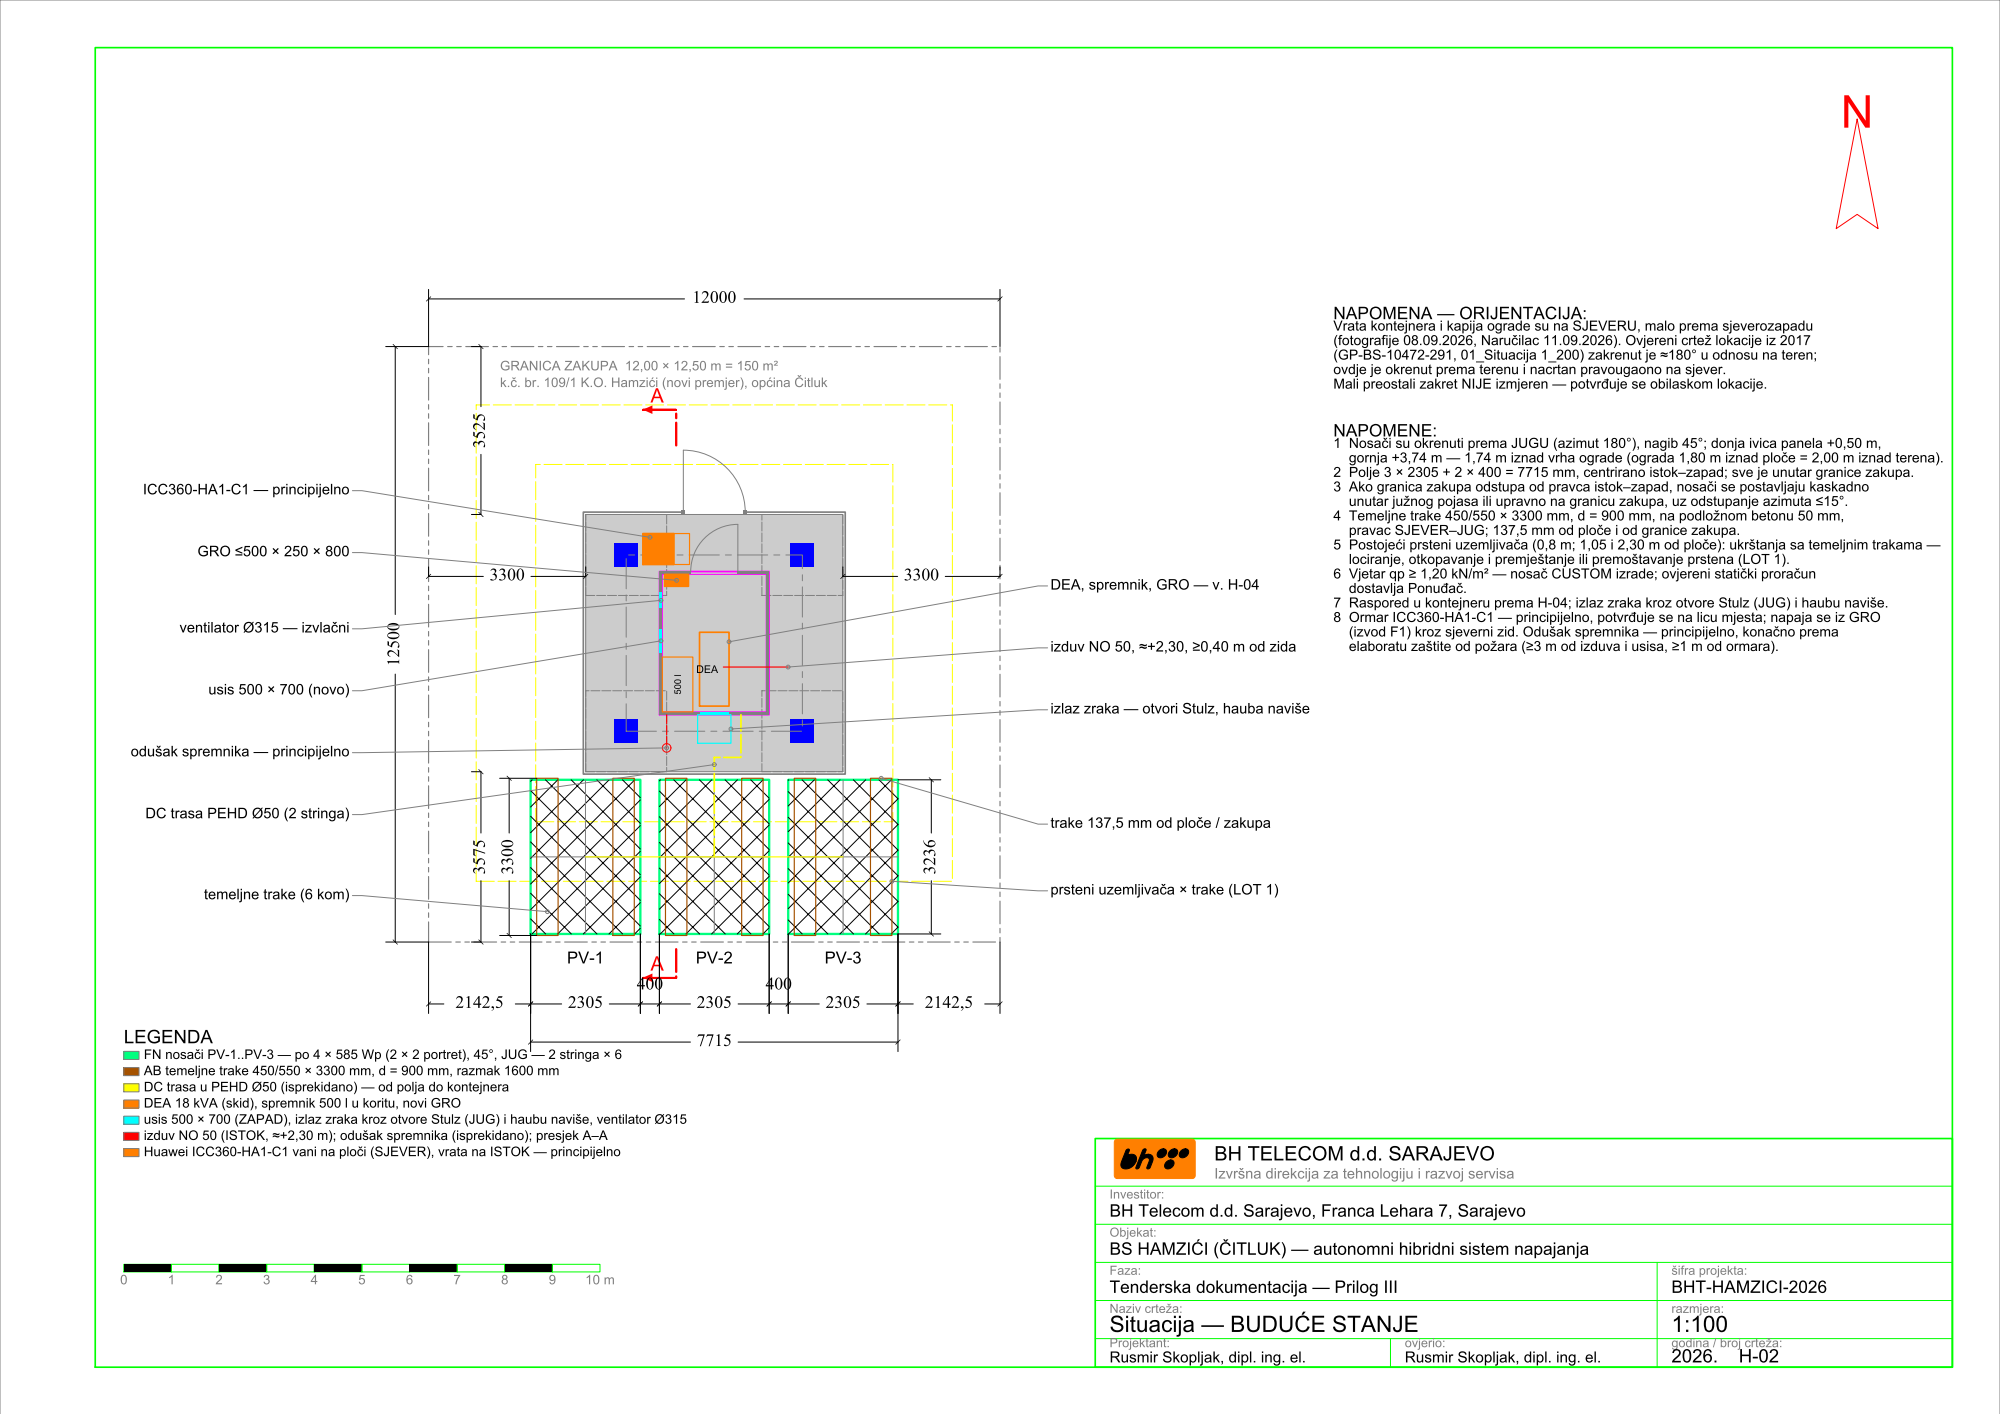
[picture p57: page 1]
