ruledicaprio/sjednica-hybrid-solar/hamzici-hybrid-solar/TD-OUTPUT/grafika/H-03.pdf

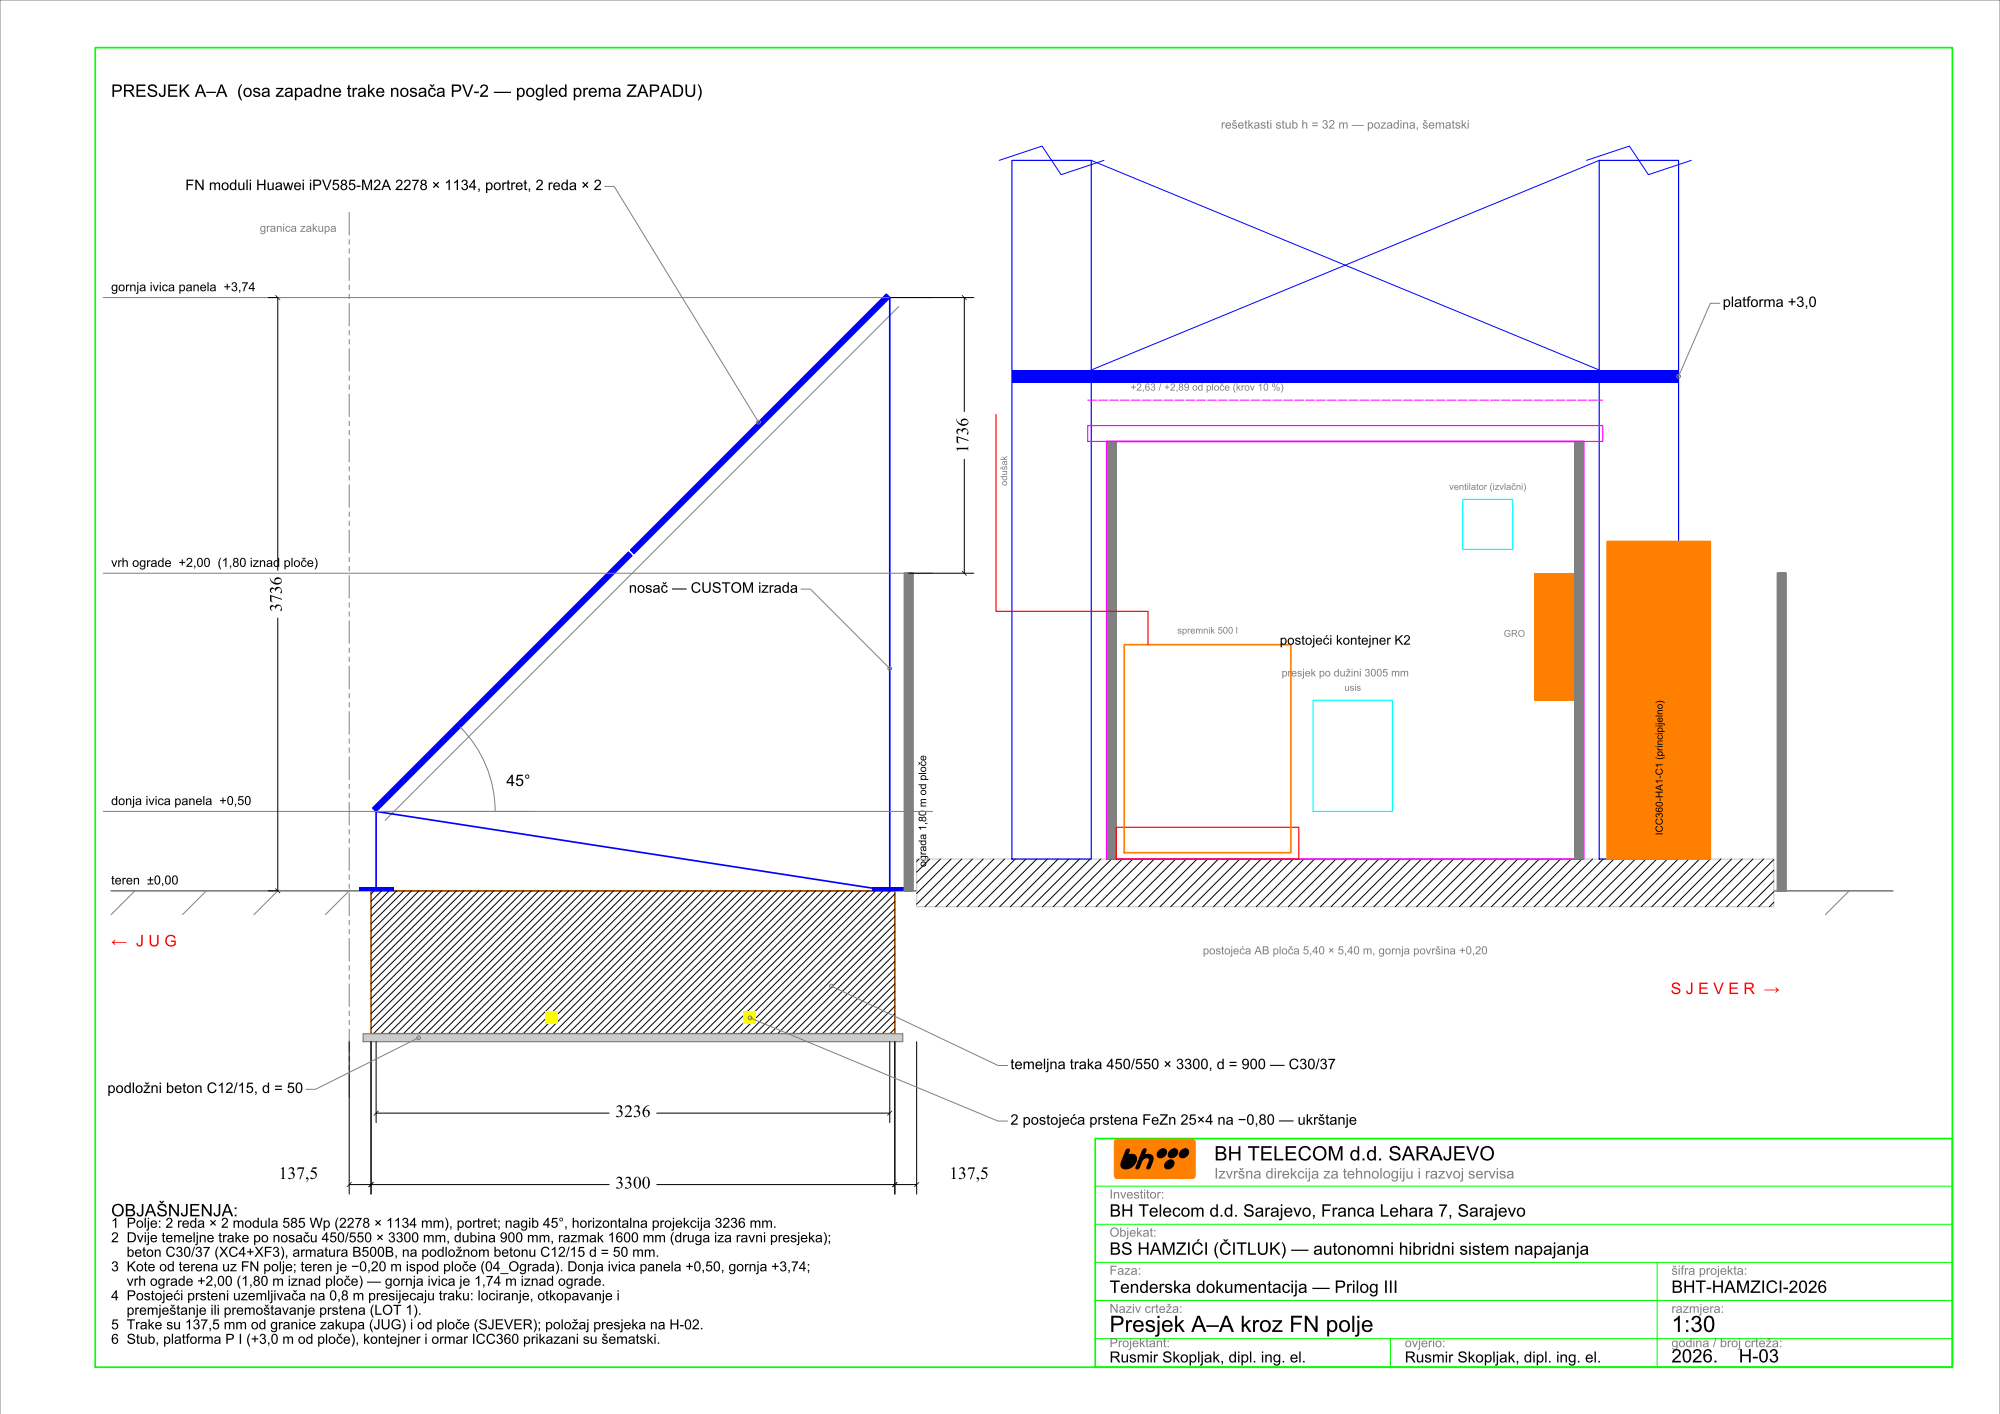
[picture p58: page 1]
