ruledicaprio/sjednica-hybrid-solar/hamzici-hybrid-solar/TD-OUTPUT/grafika/H-04.pdf

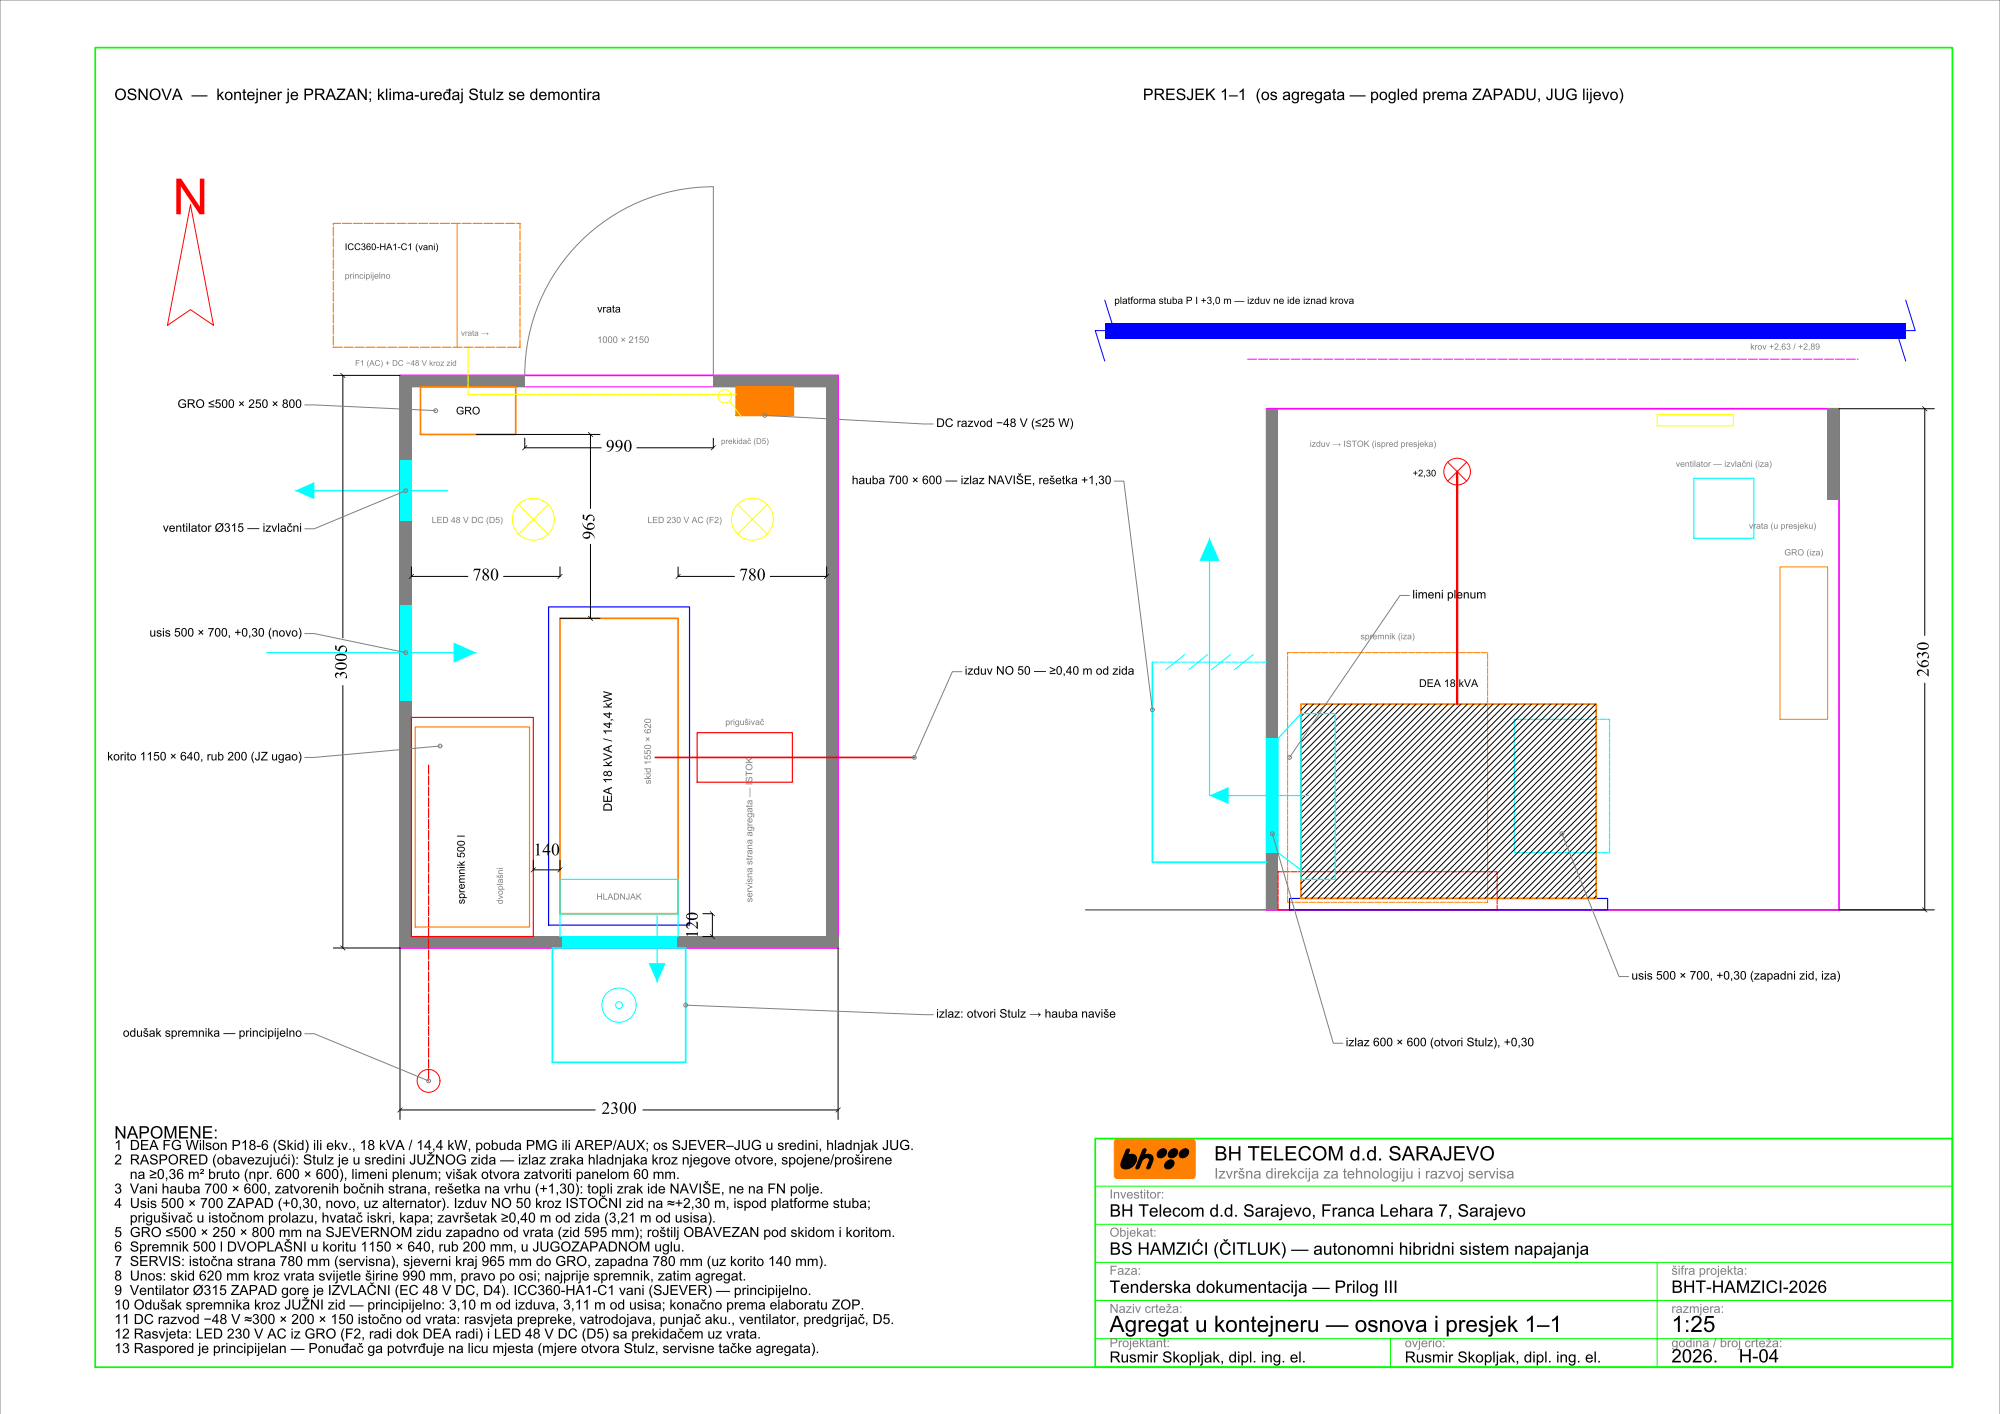
[picture p59: page 1]
