ruledicaprio/sjednica-hybrid-solar/(commit log)

2026-08-07 BS Sjednica tender package: review, corrections and CAD deliverables
    Full review and re-issue of the BS Sjednica (Bileca) tender package for the
    autonomous hybrid power system (LOT 1 PV supports, LOT 2 genset in container).
    Cross-document consistency: 7 failures at baseline -> 0.
    Repairs and corrections
    - 4. Izjava o stanju zaliha.docx was undeliverable: no [Content_Types].xml and
    three dangling customXml relationships. Rebuilt the package; all four docx now
    open in Word, LibreOffice and python-docx.
    - Panel geometry was derived from the 3656 mm longitudinal beam instead of the
    module field: projection 2590 -> 3236 mm, top edge +3,09 -> +3,74 m.
    - Container size, generator rating and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
    [3.1 PRILOG II TD - predmjer Sjednica Bileca.xlsx, E-01.dwg, E-01.dxf, M-01.dwg, M-01.dxf, S-01.dwg, S-01.dxf, S-02.dwg]
2026-08-08 Redesign PV mount to 3x4, sync tender package, fix rural-star-sjednica sim pipeline
    PV mount redesign (2 supports x 6 modules -> 3 supports x 4 modules, raised
    +0,50m -> +1,50m bottom edge) propagated through drawings (S-02/S-03/E-01),
    BOQ, and Prilog I; two real bugs found and fixed in tools/rebuild_pdfs.py
    (stale duplicate M-01/E-01 pages, obsolete Huawei catalogue reference pages).
    tools/check_consistency.py now passes 0 failures across the whole package.
    rural-star-sjednica: fixed three real bugs blocking the Radiance pipeline
    from ever running (invalid 'box' primitive -> genbox/xform, sensor position
    below the raised panel field, silently-discarded return type), added
    incremental/resum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
    [3.1 PRILOG II TD - predmjer Sjednica Bileca.xlsx, E-01.dwg, E-01.dxf, S-02.dwg, S-02.dxf, S-03.dwg, S-03.dxf, final_simulation_output.csv]
2026-08-11 fix: correct package init files, update pyproject, ignore sample_output
    [pvlib_annual_estimate.csv]
2026-08-11 added radiance
    [P13_5_FG_Wilson_hybrid MLINISTE.dwg, P13_5_FG_Wilson_hybrid MLINISTE_2.dwg]
2026-08-11 Add genset and fuel-tank figures to Prilog I
    New tools/render_equipment.py renders print-ready views: genset from the
    reference wireframe PNGs (inverted to black-on-white, vendor view labels
    trimmed), 500 l tank from the vendor vector PDFs at 300 DPI. The vendor
    "P_22-6_*" PDFs actually contain tank geometry - mapping is documented in
    the script.
    make_prilog1.py gains a figures() helper (side-by-side pairs with centred
    italic captions) and places Slika 1-2 under 4.1 Agregat and Slika 3-4
    under 4.2 Spremnik goriva, captioned generically "(ilustrativno)" to keep
    the tender brand-neutral. check_consistency.py: 0 failures.
2026-08-11 Relayout genset airflow and close the open review items
    Airflow (closes EL RED-03): intake, radiator discharge and the 505 C exhaust
    all sat on the north wall 1.4 m apart, facing the outdoor ICC330-H1/MTS9302
    cabinets, and the fuel tank stood in front of the intake. M-01 now shows a
    cross-flow arrangement - intake low on the south wall, radiator duct and
    exhaust west, tank and its 110 % bund north, room fan east - with cardinal
    wall labels, door swing, airflow arrows, and a plan and section that agree.
    Louvre sizes are unchanged; the 125 Pa budget was never the problem.
    Tank data supplied by the Investor (1050 x 600 x 1310 mm, 170 kg) replaces the
    unverified estimate. At 9.2 kN/m2 full it e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
    [3.1 PRILOG II TD - predmjer Sjednica Bileca.xlsx, E-01.dwg, E-01.dxf, M-01.dwg, M-01.dxf, S-01.dwg, S-01.dxf, S-02.dwg]
2026-08-11 Restore 10 kN/m2 floor load, 2 strings, true A3 sheets
    Floor capacity: Rev 2 was wrong and the Investor is right. "04 AG dio.docx"
    4.4.2.3 - the certified project of THIS K2 object - dimensions the floor for a
    total (g+p) of 10.00 kN/m2 (secondary beams HOP 100x50x3 at 0.51 m, 5.10 kN/m';
    primary 15.00 kN/m'). The 2.00 kN/m2 in the same document is the pedestrian live
    load on the walkable strip. Rev 2 took that figure for the capacity and blamed a
    K3 type sheet; 02-construction R-08's "no such document is in the pack" is
    retracted. The spreading frame stays required, now for the right reason: the
    equipment loads are concentrated on a few secondary beams while 10 kN/m2 is a
    uniformly distribu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
    [3.1 PRILOG II TD - predmjer Sjednica Bileca.xlsx, E-01.dwg, E-01.dxf, M-01.dwg, M-01.dxf, S-01.dwg, S-01.dxf, S-02.dwg]
2026-08-11 Rebuild Prilog III from sources: K2 drawings replace the K3 set
    The annex was maintained by splicing into an inherited 30-page PDF. It is now
    assembled from parts by tools/build_prilog3.py, which is what made the
    Investor's restructure possible.
    The eight K3 container drawings are replaced by six from the certified project
    of this object (osnova, both sections, fasade, detalji, osnova temelja) - the
    site is a K2, so the K3 sheets described a different container. The nine K3
    electrical drawings are replaced by one: the K2 single-line of the GRO. The PMO
    sheets go with them, since the PMO no longer has a supply and sheet E-01 of this
    package shows the new GRO. INFO-03, INFO-04 (which still na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
    [S-03.dxf]
2026-08-11 Move S-02 foundation strips into the band south of the fence
    The strips were drawn from 250 mm below the panel's lower edge running 1500 mm
    NORTH, which put them across the fence line and into the compound - the notes
    have always said the foundations sit outside the fence, in the 1950 mm strip.
    They now run south from the panel edge, inside the parcel boundary, and the
    PV-n labels moved clear of them.
    Drawing position only; the foundation design is unchanged, as confirmed.
    [E-01.dwg, E-01.dxf, M-01.dwg, M-01.dxf, S-01.dwg, S-01.dxf, S-02.dwg, S-02.dxf]
2026-08-11 Move the PV array south, clear of the container
    The panels sat 400 mm south of the fence, so at 45 deg their 3236 mm projection
    oversailed the fence, the slab and the container itself. The array now sits as
    far south as the leased parcel allows - lower edge 100 mm inside the southern
    boundary - so both foundation strips fall inside the 1950 mm band outside the
    fence and the panels stop short of the container.
    Drawing placement only; the support design, tilt and foundation type are
    unchanged. Prilog I is left exactly as edited by hand and is not regenerated;
    everything else is rebuilt from the sources.
    [E-01.dwg, E-01.dxf, M-01.dwg, M-01.dxf, S-01.dwg, S-01.dxf, S-02.dwg, S-02.dxf]
2026-08-11 Container height 2,63 / 2,89 m from the certified K2 facade
    The K2 facade drawing now in Prilog III carries levels +2.63 and +2.89 with a
    10 % mono-pitch roof. The package had been using 2.40 m, which was an assumption
    - 02-construction Y-05 listed four conflicting heights and left it to the site
    visit. The certified drawing settles it, so Y-05 is closed. The lower eave
    2.63 m governs internal clearances and is what the M-01 section now draws.
    The extents guard caught the taller section running 25 units off the top of the
    A3 sheet; the section origin moved down to suit.
    Checked while there: the K2 elevations show no louvre or wall opening anywhere,
    only a roxtec gland and the door. The app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
    [E-01.dwg, E-01.dxf, M-01.dwg, M-01.dxf, S-01.dwg, S-01.dxf, S-02.dwg, S-02.dxf]
2026-08-11 Real container elevation on S-03; earth bar and notes on E-01
    S-03 drew the container as a plain box. It now uses the geometry the certified K2
    facade gives: 2300 mm wide with a 10 % mono-pitch roof, +2,63 at one eave and
    +2,89 at the other, with the roof overhang - drawn parametrically from those
    figures rather than by scaling a vendor elevation into place, so nothing is
    distorted and none of their annotation comes along. The level captions moved to
    the left of it; they had been printing on top of the container.
    E-01: the earth bar sat at the bottom of the sheet with 500 mm stubs that
    stopped short of the equipment they bond. The bar is raised and the stubs now
    reach the boxes, and it is d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
    [E-01.dwg, E-01.dxf, M-01.dwg, M-01.dxf, S-01.dwg, S-01.dxf, S-02.dwg, S-02.dxf]
2026-08-11 Mirror the container interior: intake from the north face
    The intake now takes air from the NORTH wall - the shaded face, so the coolest
    air available - which is worth having on a genset that has to hold its rating at
    1076 m. The radiator discharge and the exhaust stay WEST, so nothing is blown at
    the outdoor cabinets and EL RED-03 stays closed; the intake is placed east of
    them so it does not draw their warm air either.
    Interior mirrored N-S to suit: tank and bund to the SOUTH wall with the vent
    through it, genset central with the radiator still WEST. The new GRO is drawn on
    the NORTH wall beside the cabinets it feeds, which is the shortest cable run.
    Bund, skid and GRO together need more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
    [3.1 PRILOG II TD - predmjer Sjednica Bileca.xlsx, E-01.dwg, E-01.dxf, M-01.dwg, M-01.dxf, S-01.dwg, S-01.dxf, S-02.dwg]
2026-08-11 Tower base on S-03; PV array into the open ground south of the compound
    S-03 gains the base segment of the 38 m lattice tower, drawn to the certified
    taper (4200 mm at grade narrowing linearly to 1200 mm at 24,60 m per
    site_geometry). The container stands between its legs, which is what makes the
    section read as the real structure rather than a box on a slab.
    S-02: the panels no longer cross the fence. The whole field now stands in the
    open ground south of the compound instead of leaning over it, and the leased
    plot is drawn with the compound toward its north edge, which is what leaves that
    front area free. Legend, notes and the parcel dimension moved to suit - the
    parcel width is now dimen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
    [E-01.dwg, E-01.dxf, M-01.dwg, M-01.dxf, S-01.dwg, S-01.dxf, S-02.dwg, S-02.dxf]
2026-08-11 Rev 6: footings at full length, real fence, M-01 fits the frame
    Investor's mark-up on the Situacija set. Three geometry errors:
    - Footings drawn 450x1500 while design.json, the S-02 leader and the S-02
    legend all said 450x3300. On S-03 the pair was drawn as two pads under the
    panel ends - wrong projection: the strips run N-S at 1600 mm centres E-W, so
    section A-A sees one 3300 mm strip and the other behind the section plane.
    Both now derive from support.strip_l/strip_w instead of literals.
    - The fence was a hairline. Drawn now to the certified elevation in
    '461 Graficki dio TEMELJ i OGRADA/04 Ograda.dwg', which also settles the
    height at +2,10 (the 1,90 in the package had no sou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
    [E-01.dwg, E-01.dxf, M-01.dwg, M-01.dxf, S-01.dwg, S-01.dxf, S-02.dwg, S-02.dxf]
2026-08-12 Rev 8: Prilog I from markdown, quantities corrected, calculations compacted
    The client restored the earlier _K documents and renamed the package (no _K
    suffix any more, TD-OUTPUT/DWG -> TD-OUTPUT/grafika). Comparing them showed the
    restored Prilog I was the latest _K plus the client's own edits, so nothing from
    earlier revisions was lost; what it carried were thirteen stale values that had
    survived six revisions because nothing checked them programmatically.
    Prilog I is now generated: review/prilog1.md -> pandoc -> .docx, via
    tools/build_prilog1.py, which asserts 15 forbidden and 26 required values on the
    output and fails the build if any of them move. That replaces the old rule that
    Prilog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
    [3.1 PRILOG II TD - predmjer Sjednica Bileca.rev8-bak.xlsx, 3.1 PRILOG II TD - predmjer Sjednica Bileca.xlsx, E-01.dwg, E-01.dxf, M-01.dwg, M-01.dxf, S-01.dwg, S-01.dxf]
2026-08-13 Rename repo to solar-rfp-engine, reposition as broader solar toolkit
    Renamed on GitHub from sjednica-hybrid-solar to solar-rfp-engine.
    Radiance is one input tool among several this toolkit is meant to use;
    documents pvlib, PVGIS, wind/snow load data, and floor weight capacity
    as future data/tool sources. Restored bin/lib locally (still gitignored)
    from the now-retired stale pre-rename Radiance_build clone.
2026-09-11 Phase 0: one paths module for the Rev 8 layout, pandoc discovery
    - tools/paths.py holds TD-OUTPUT/grafika and "3.2 Prilog III" in one
    place; TD_OUT redirects outputs so a rebuild can be compared against
    the committed package. The drawing, export and annex scripts still
    wrote to TD-OUTPUT/DWG or the pre-Rev 3 annex name.
    - build_prilog1.build() takes md, output, rule lists and image count, so
    the joint two-site package can reuse it; pandoc is found on PATH or in
    the per-user winget install.
    - Prilog III cover takes the logo from cad/bht-logo.svg as vector. The
    make_prilog1 import it relied on was deleted in Rev 8 and failed
    silently, so the Rev 8 cover shipped without a logo.
    -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
2026-09-11 pvsim: PV chain and 19-year off-grid dispatch from PVGIS SARAH3
    - pvgis.py: PVGIS v5.3 client with a gzip cache keyed by request and
    sha256 sidecars; the small responses are committed under
    sites/<id>/pvgis_ref with a manifest, the hourly series stay cached.
    - pv.py: PVGIS in-plane irradiance -> Martin-Ruiz IAM, Faiman
    temperature, Huld c-Si, soiling/snow/mismatch/LID, DC wiring,
    optimizers, iSSU S4875G2 losses read off the datasheet curve, 4 kW
    clip with its temperature derating.
    - dispatch.py: hourly DC-bus balance over all years with SoC and fuel
    carried across years; SMU logic (start at DOD 85 %, stop SoC, minimum
    run), rectifier cap 9,5 kW, P18-6 prime fuel curve; energy b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
    [monthly_t45.csv, monthly_t60.csv, years_t45.csv, years_t60.csv]
2026-09-11 Sjednica Rev 9: energy balance from pvsim, Odluka limits corrected
    - review/09: decisions of 11.09.2026. Both sites stay 3x4 at 45 deg
    (60 deg gives more December PV but more genset hours, and 44-72 %
    more overturning moment). The Odluka limits are replaced by simulated
    values. The Hamzici tree stays.
    - pvsim base case = the SMU settings the TD now requires (start DOD
    85 %, stop SoC 60 %, charge at the BMS limit, 0,5 C). SMU defaults
    move to the sensitivity table. The Hamzici plot is measured from the
    certified situation drawing: 3 525 mm south of the slab, so 45 deg
    fits.
    - Odluka (OOXML edit): the Aneks 2 paragraph gets the approved wording
    (≈280 h, ≈940 l/yr, 2-3 refil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
    [monthly_t45.csv, monthly_t60.csv, years_t45.csv, years_t60.csv]
2026-09-11 Rev 9: battery 6 × 150 Ah (48,6 kWh), as the Odluka states
    The Investor confirmed on 11.09.2026 that both sites get 6 × 150 Ah LFP
    (48,6 kWh), as in Odluka Aneks 2. The Huawei quote on file (6 × ESM-48100A6,
    28,8 kWh, quoted with 540 W modules) is outdated and stays only as a
    sensitivity case.
    pvsim: kwh_per_module 8,1 with a battery label in both site files; the
    report adds the 28,8 kWh sensitivity row. Reports and kpis regenerated for
    both sites.
    Sjednica, 45°, SMU set per Prilog I: genset 234 h/yr mean (293 h in 9 of
    10 years, 313 h worst), 773 l/yr, the 500 l tank refilled about twice a
    year (was 284 h / 938 l with 28,8 kWh). Hamzići: 214 h / 706 l.
    Propagated to Prilog I §4.6 a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
    [monthly_t45.csv, monthly_t60.csv, years_t45.csv, years_t60.csv]
2026-09-11 Hamzići site data, calculations and joint TD tooling
    BS Hamzići (Čitluk) joins the BS Sjednica tender as one joint off-grid
    tender with the same system design. LOT 1 covers the PV stands,
    foundations and grounding at both sites; LOT 2 the gensets and
    installations at both sites.
    hamzici-hybrid-solar/
    - cad/site_geometry.json: lease 12,00 × 12,50 m (k.č. 109/1), slab
    5,40 m, fence 1,80 m, K2 container, 32 m lattice tower, in the true
    orientation. The certified 2017 drawing is rotated ≈180° to the site:
    door and gate face north, slightly north-west (photos, Investor).
    - cad/design.json: the Sjednica design with the Hamzići overrides:
    JUS wind converted to EN (qp 1,20 kN/m² a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
2026-09-11 pvsim: always-on DC loads (aux 45 W); mark dirty trees in kpis
    Off-grid, the genset is the only AC source, so everything that must run
    while it is stopped moves to the -48 V DC bus (Investor, 11.09.2026):
    tower obstruction light (LED), fire-detection panel and starter-battery
    charger through DC/DC, 48 V DC room fan. Prilog I caps them at 25 W on
    average, so aux_w goes from 20 to 45 W at both sites.
    _git_commit() now appends "-dirty" when pvsim's code or site files differ
    from HEAD, so kpis.json never cites a commit that does not reproduce it.
2026-09-11 Always-on loads on -48 V DC; Hamzići H-04 layout; figures with aux 45 W
    Off-grid, the genset is the only AC source and stands still about 97 % of
    the year, so GRO feeders are dead most of the time - including the tower
    obstruction light Rev 8 reconnected to the new GRO. Investor decision
    (11.09.2026, both sites): always-on loads run from the ICC360 -48 V DC bus
    through a new DC distribution - LED obstruction light for 48 V DC, fire
    panel and starter-battery charger through DC/DC, 48 V DC room fan, one
    48 V DC container light. Prilog I §4.5 caps them at 25 W on average.
    Energy figures regenerated with aux 45 W (pvsim cd567a2) and propagated
    to Prilog I §8, 07-proracuni A.5/A.6/C.5/D/E/F,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
    [monthly_t45.csv, monthly_t60.csv, years_t45.csv, years_t60.csv]
2026-09-11 DC pre-heat and switch fixes, joint BOQ, Stulz on the south wall (WIP)
    Heaters (Investor, 11.09.2026): the 230 V coolant heater becomes a DC
    pre-heater on the DC razvod that the genset controller switches on only
    before a start. There is no space heater. Tank heating is replaced by
    fuel-line insulation and a first fill with winter diesel. The room
    low-temperature alarm defaults to -10 °C. Prilog I §4.1 gets a
    cold-start row and §4.5 the pre-heater; the DC budgets in 07-proracuni
    D.8/D.9 come to about 21 W, within 25 W.
    BOQ:
    - tools/fix_boq_dc_aux.py adds items 5.16-5.18 to the Sjednica source
    workbook: the DC razvod, a 48 V DC tower light and the DC/DC
    converters.
    - The same script m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
    [3.1 PRILOG II TD - predmjer Sjednica Bileca.xlsx]
2026-09-11 Hamzići container re-laid for the centred south Stulz; joint package built
    The Investor placed the Stulz centred on the SOUTH wall (not the east
    wall, not the SE corner). The Hamzići container is re-laid:
    - genset on the centre line, long axis N-S, radiator south through the
    Stulz cut-outs into a 700 × 600 hood that turns the warm air upwards,
    off the back of the PV array (0,77 m) and 1,25 m from the south legs;
    - intake on the west wall at the alternator end; exhaust through the
    east wall at +2,30 (3,21 m from the intake), silencer in the east
    passage;
    - tank in the SW corner - no spot keeps both 780 mm sides clear, so the
    east side is the service side; vent through the south w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
    [3.1 PRILOG II TD - predmjer Sjednica i Hamzici.xlsx, E-01.dwg, E-01.dxf, H-01.dwg, H-01.dxf, H-02.dwg, H-02.dxf, H-03.dwg]
